Lilffy/NIPKOW/firmware/README.md

# 固件工程（STM32F407VET6 / 天空星核心板）

> 负责人：B。开发环境建议 **STM32CubeIDE**（或 Keil MDK + HAL）。
> 引脚定义已冻结，见 `docs/SCHEMATIC_LAYOUT.md`。

## 里程碑

| 编号 | 内容 | 验收 | 状态 |
|---|---|---|---|
| M0 | 骨架：168 MHz、SysTick、USART2 115200、PB2 心跳灯 | 串口打印版本号 + LED 1 Hz | ⬜ |
| M1 | 红外 EXTI：PA1 下降沿、消抖、LEB、LED 亮 1 s（非阻塞） | 遮光/移开各触发一次 | ⬜ |
| M2 | RGB PWM：TIM3 CH1/2/3（PA6/PA7/PB0），开漏+反相，≥4 级 | 8 色可辨 | ⬜ |
| M3 | 电机：TIM4_CH1（PB6）启停/调速 | 电机可转可停可调速 | ⬜ |
| M4 | 串口协议：`START` / `STOP` / `SET <rpm>` / `RGB r g b` | 串口助手可控 | ⬜ |
| M5 | 稳速闭环：索引周期测量 + PI，1200±20 rpm | 30 s 稳定 | ⬜ |
| M6 | 整帧成像：16×25 帧缓冲、125 µs 像素、切图、动画、失锁 | 静态图 30 s 不漂移 | ⬜ |
| M7 | 加分：灰度、30 fps、PC 传图 | 按赛题 | ⬜ |

## 目录约定

```
firmware/
├── common/     时钟、延时、串口、日志
├── drivers/    led / ir_exti / rgb_pwm / motor_pwm / encoder
├── app/
│   ├── stage1/ 第一阶段 5 个演示程序（可独立编译）
│   └── stage2/ 扫描时序、帧缓冲、动画、失锁
└── tools/      上位机脚本（Python）
```

## 烧录

- ST-Link 接核心板 SWD（PA13/PA14 + GND + 3V3）
- 串口：J7（GND / TX=PA2 / RX=PA3），115200 8N1
- 上电顺序：先测 3.3V/5V 正常，再插核心板

## 关键约束（务必遵守）

1. RGB 三路必须 **GPIO 开漏输出**，PWM 占空比**取反**（低电平点亮），否则灯关不死
2. 索引 PA1：遮光时高、透光时低 → **下降沿**触发
3. 中断里只置标志/记时间戳，1 秒 LED 用 SysTick 非阻塞
4. 切帧只能在索引中断里做，避免撕裂
5. 失锁判据：索引间隔 > 1.5T 立即熄灯并复位状态机

## 构建（VSCode + CMake）

```powershell
cd firmware
cmake -B build -G Ninja -DCMAKE_BUILD_TYPE=Debug
cmake --build build
```

要求：
- `arm-none-eabi-gcc` 在 PATH（或设置环境变量 `ARM_GCC_DIR` 指向工具链根目录）
- CMake ≥ 3.20、Ninja
- 产物：`build/nipkow-fw.elf / .bin / .hex`

## 烧录

```powershell
# STM32CubeProgrammer CLI
& "C:\Program Files\STMicroelectronics\STM32Cube\STM32CubeProgrammer\bin\STM32_Programmer_CLI.exe" -c port=SWD -w build\nipkow-fw.hex -v -rst
```

或 VSCode 里用 STM32 扩展的 Debug/Run（选 ST-Link）。

---

## 目录说明（2026-10-26 更新）

| 路径 | 内容 | 状态 |
|---|---|---|
| 
irmware/cubemx/ | **当前开发工程**：CubeMX 生成（CMake + VSCode），含 M0 代码、.ioc、选择性 HAL | ✅ 可编译（RAM 2224 B / FLASH 19400 B） |
| 
irmware/Core/、
irmware/third_party/ | 早期手写骨架（参考用，HAL 全量） | 📦 参考 |

### 编译 cubemx 工程

`powershell
cd firmware/cubemx
cmake --preset Debug
cmake --build --preset Debug
`

要求：rm-none-eabi-gcc 在 PATH，CMake ≥ 3.22，Ninja。

> cubemx/ 是用 CubeMX 重新生成后直接覆盖的工程；.ioc 是唯一配置源。
> cubemx/Drivers/ 只保留了 CMake 实际引用的 16 个 HAL 源文件 + CMSIS 必要头文件（约 9 MB），
> 换芯片/加外设后如果 CMake 引用了新的 HAL 文件，需要补拷或直接用 CubeMX 重新生成。
