Lilffy/NIPKOW/docs/SCHEMATIC_ZONES.md

# 原理图分区：器件 → 功能模块对照表

> 用途：手动整理原理图分区时按此表归类（2026-10-27 按网表核对生成）。
> **DNP** = 不贴；网络名以原理图/网表为准。

| 模块 | 器件 |
|---|---|
| 核心板 | U1 |
| 电源输入 / 防反接 / 滤波 | J1、D1、C1、C3、C5、C7、C9、C10 |
| 5V 线性稳压（LM1117-ADJ） | U3、C4、C8、R10、R11 |
| 3.3V 线性稳压（LM1117-3.3） | U2、C2、C6、R16 |
| 5V 注入核心板 | JP1 |
| 核心板上拉（PA4/SPI Flash CS） | R15 |
| RGB 驱动（主方案：PNP 高边） | J3、Q4、Q5、Q6、R3、R6、R9、R17、R18、R19、R20、R21、R22 |
| RGB 备用（低边 NMOS，DNP 不贴） | Q1、Q2、Q3、R2、R5、R8 |
| 红外发射 | J4、R12 |
| 红外接收 / 索引输入 | J5、R13、R14、D2 |
| 按键 | KEY1、KEY2 |
| 电机接口 | J6 |
| 串口（UART） | J7、R23 |
| 测试点 | TP1、TP2、TP3、TP4、TP5、TP6、TP7、TP8、TP9 |

---

## 核心板（1 个）

**主要网络**：5V(+5V_CORE) / 3V3 / GND；PA1=IR_INDEX、PA2/PA3=UART_TX/RX、PA4=PA4(上拉)、PA6/PA7/PB0=R/G/B_PWM、PB6=MOTOR_PWM、PC0/PC1=KEY1/KEY2

| 器件 | 值 / 型号 | 封装 | 备注 |
|---|---|---|---|
| U1 | 立创·梁山派-天空星开发板 | DIP-80_L44.97-W69.97-P2.54X2-LS35.9_OLD |  |

## 电源输入 / 防反接 / 滤波（8 个）

**主要网络**：VIN_MAIN（J1、D1.A）→ VIN_PROTECTED（D1.K、C1/C3/C5/C7/C9/C10 到 GND）

| 器件 | 值 / 型号 | 封装 | 备注 |
|---|---|---|---|
| J1 | 主电源接口 | CONN-TH_XY301V-A-5.0-2P | C9900016950 |
| D1 | SS34 | SMA_L4.3-W2.6-LS5.0-FD | C7420365 |
| C1 | 10uF | C0603 |  |
| C3 | 10uF | C0603 |  |
| C5 | 100nF | C0603 |  |
| C7 | 100nF | C0603 |  |
| C9 | 100nF | C0603 |  |
| C10 | 10uF/25V | C0603 |  |

## 5V 线性稳压（LM1117-ADJ）（5 个）

**主要网络**：VIN_PROTECTED → U3 → +5V_REG；ADJ 节点由 R10/R11 分压；C4/C8 滤波

| 器件 | 值 / 型号 | 封装 | 备注 |
|---|---|---|---|
| U3 | 主稳压电路 | TO-220-3_L10.0-W4.5-P2.54-L | C498319 |
| C4 | 10uF | C0603 |  |
| C8 | 100nF | C0603 |  |
| R10 | 120 | R0603 |  |
| R11 | 360 | R0603 |  |

## 3.3V 线性稳压（LM1117-3.3）（4 个）

**主要网络**：VIN_PROTECTED → U2 → +3V3_EXT；C2/C6 滤波；R16 假负载

| 器件 | 值 / 型号 | 封装 | 备注 |
|---|---|---|---|
| U2 | 外围电路稳压 | SOT-223-3_L6.4-W3.5-P2.30-LS7.0-BR | C55544533 |
| C2 | 10uF | C0603 |  |
| C6 | 100nF | C0603 |  |
| R16 | 470 | R0603 |  |

## 5V 注入核心板（1 个）

**主要网络**：+5V_REG ↔ +5V_CORE（JP1 短接才注入）

| 器件 | 值 / 型号 | 封装 | 备注 |
|---|---|---|---|
| JP1 | 跳线 | HDR-TH_2P-P2.54-V-M | C9900015265 |

## 核心板上拉（PA4/SPI Flash CS）（1 个）

**主要网络**：PA4 ↔ +3V3_CORE（R15 10k 上拉）

| 器件 | 值 / 型号 | 封装 | 备注 |
|---|---|---|---|
| R15 | 10000 | R0603 |  |

## RGB 驱动（主方案：PNP 高边）（13 个）

**主要网络**：R_PWM/G_PWM/B_PWM → R17–R19 → Q4–Q6 基极；Q4–Q6 发射极接 +5V_REG、集电极 → R3/R6/R9 → J3-1/2/3；R20–R22 为上拉到 +5V_REG；J3-4 = GND（公共阴极）

| 器件 | 值 / 型号 | 封装 | 备注 |
|---|---|---|---|
| J3 | RGB灯珠接口 | CONN-TH_A2547WV-4P | C9900216472 |
| Q4 | S8550 | SOT-23-3_L2.9-W1.3-P1.90-LS2.4-BR | C20069126 |
| Q5 | S8550 | SOT-23-3_L2.9-W1.3-P1.90-LS2.4-BR | C20069126 |
| Q6 | S8550 | SOT-23-3_L2.9-W1.3-P1.90-LS2.4-BR | C20069126 |
| R3 | 180 | R0603 |  |
| R6 | 120 | R0603 |  |
| R9 | 120 | R0603 |  |
| R17 | 1000 | R0603 |  |
| R18 | 1000 | R0603 |  |
| R19 | 1000 | R0603 |  |
| R20 | 10000 | R0603 |  |
| R21 | 10000 | R0603 |  |
| R22 | 10000 | R0603 |  |

## RGB 备用（低边 NMOS，DNP 不贴）（6 个）

**主要网络**：Q1–Q3 + R2/R5/R8；仅当灯珠为共阳时才贴

| 器件 | 值 / 型号 | 封装 | 备注 |
|---|---|---|---|
| Q1 | AO3400A | SOT-23-3_L2.9-W1.3-P1.90-LS2.4-BR | **DNP 不贴**，C700953 |
| Q2 | AO3400A | SOT-23-3_L2.9-W1.3-P1.90-LS2.4-BR | **DNP 不贴**，C700953 |
| Q3 | AO3400A | SOT-23-3_L2.9-W1.3-P1.90-LS2.4-BR | **DNP 不贴**，C700953 |
| R2 | 10000 | R0603 | **DNP 不贴** |
| R5 | 10000 | R0603 | **DNP 不贴** |
| R8 | 10000 | R0603 | **DNP 不贴** |

## 红外发射（2 个）

**主要网络**：+5V_REG → R12 → J4-1（阳极）；J4-2 = GND（阴极）

| 器件 | 值 / 型号 | 封装 | 备注 |
|---|---|---|---|
| J4 | 2P2.54单排针 | HDR-TH_2P-P2.54-V-M | C9900015265 |
| R12 | 200 | R0603 |  |

## 红外接收 / 索引输入（4 个）

**主要网络**：+3V3_EXT → R13 → IR_INDEX（J5-1 = 集电极，接 PA1）；J5-2 = GND（发射极）；R14 + D2 为通光指示

| 器件 | 值 / 型号 | 封装 | 备注 |
|---|---|---|---|
| J5 | 2P2.54单排针 | HDR-TH_2P-P2.54-V-M | C9900015265 |
| R13 | 1000 | R0603 |  |
| R14 | 1000 | R0603 |  |
| D2 | GL0603UG01 | LED0603-RD | C51933293 |

## 按键（2 个）

**主要网络**：KEY1 = PC0、KEY2 = PC1；按下接地（内部/外部上拉），低有效

| 器件 | 值 / 型号 | 封装 | 备注 |
|---|---|---|---|
| KEY1 | 5.8 WSPT | SW-TH_6P-L5.8-W5.8-P2.00-LS4.5-TL_K8-5851E-L1 | C5379898 |
| KEY2 | 5.8 WSPT | SW-TH_6P-L5.8-W5.8-P2.00-LS4.5-TL_K8-5851E-L1 | C5379898 |

## 电机接口（1 个）

**主要网络**：J6: 1=VIN_PROTECTED、2=GND、3=MOTOR_PWM(PB6)、4=MOTOR_FG、5=MOTOR_AUX

| 器件 | 值 / 型号 | 封装 | 备注 |
|---|---|---|---|
| J6 | MDF7-5P-2.54DSA(95) | HDR-TH_5P-P2.54-V-M_MDF7 | C19088617 |

## 串口（UART）（2 个）

**主要网络**：J7: 1=GND、2=UART_TX(PA2)、3=UART_RX(PA3)、4=UART_VCC；R23(0Ω, DNP) 预留 3V3 供电

| 器件 | 值 / 型号 | 封装 | 备注 |
|---|---|---|---|
| J7 | HX PZ2.54-1x4P ZZ | HDR-TH_4P-P2.54-V-M | C32713270 |
| R23 | 0 | R0603 | **DNP 不贴** |

## 测试点（9 个）

**主要网络**：TP1=VIN_PROTECTED、TP2=+5V_REG、TP3=+3V3_EXT、TP4=GND、TP5=IR_INDEX、TP6=R_PWM、TP7=G_PWM、TP8=B_PWM、TP9=MOTOR_PWM

| 器件 | 值 / 型号 | 封装 | 备注 |
|---|---|---|---|
| TP1 | RH-5000 | TEST-TH_BD2.54-P1.4_RED | C5277086 |
| TP2 | RH-5000 | TEST-TH_BD2.54-P1.4_RED | C5277086 |
| TP3 | RH-5000 | TEST-TH_BD2.54-P1.4_RED | C5277086 |
| TP4 | RH-5000 | TEST-TH_BD2.54-P1.4_RED | C5277086 |
| TP5 | RH-5000 | TEST-TH_BD2.54-P1.4_RED | C5277086 |
| TP6 | RH-5000 | TEST-TH_BD2.54-P1.4_RED | C5277086 |
| TP7 | RH-5000 | TEST-TH_BD2.54-P1.4_RED | C5277086 |
| TP8 | RH-5000 | TEST-TH_BD2.54-P1.4_RED | C5277086 |
| TP9 | RH-5000 | TEST-TH_BD2.54-P1.4_RED | C5277086 |

---

## 建议分区摆放（从上到下、从左到右）

1. **左上：电源输入** —— J1、D1、C1/C3/C5/C7、C9/C10
2. **左中：稳压** —— U3 + C4/C8 + R10/R11；U2 + C2/C6 + R16
3. **左下：注入/上拉** —— JP1、R15
4. **中间：核心板 U1**（最大器件）
5. **右上：RGB 驱动** —— J3、Q4–Q6、R3/R6/R9、R17–R22；备用 Q1–Q3、R2/R5/R8 紧邻放
6. **右中：红外** —— J4 + R12（发射）；J5 + R13/R14/D2（接收）
7. **右下：按键/电机/串口** —— KEY1/KEY2、J6、J7 + R23
8. **底边：测试点 TP1–TP9**

> 跨区连接一律用网络标号（VIN_PROTECTED、+5V_REG、R_PWM…），不要拉长线。
> 电源与地：用电源符号（+5V_REG、+3V3_EXT、GND），避免线与线交叉。
