Lilffy/NIPKOW/hardware/PCBInfo.txt

工程标题: 		Nipkow
板子标题: 		Board1
PCB 标题: 		PCB1
时间: 		2026-10-25 08:21:32

板子尺寸: 		3937mil x 3543mil
板子面积: 		...
铜箔面积: 		顶层 ... 利用率 ...
露铜面积: 		总计 ... 利用率 ...
层: 		总计 22, 铜箔层 2

器件: 		16
封装: 		15
元件: 		总计 59,顶层 59,底层 0
焊盘: 		总计 215, 顶面表贴 86,底面表贴 0,金属化孔 125, 非金属化孔 4
网络: 		总计 37, 未布线 0
测试点: 		网络总数 37, 有测试点的网络 0, 测试点覆盖率 0%
 		总计 0, 顶面测试点 0, 底面测试点 0

挖槽区域: 		4
过孔: 		总计 32, 通孔 32, 盲埋孔 0
铺铜区域: 		1
导线长度: 		75672.4mil
