Lilffy/NIPKOW/docs/V2_HANDOVER_FOR_A.md

# V2 改板任务书（交给 A）

> 2026-10-31。目标：**在 V1 网表不变的前提下，重排布局 + 重新布线，得到一块"无隐患"的扩展板。**
> 时间要求：**今天（10-31）出 Gerber**，加急打样 2–3 天，11-03/04 到货，留 2 天焊接联调。

---

## 0. 背景（一句话）

V1 板已到货，但布局有几处问题（连接器罩住贴片、器件进核心板投影、丝印位号错位、电源区太挤）。铜箔没短路，但焊装体验差、有返修风险。
V2 = **同一张原理图/网表**，只改布局和布线，不动电路。

---

## 1. 交付物（就是你要发的文件）

| 文件 | 说明 |
|---|---|
| `Nipkow_EDA工程.zip` | EDA 工程（`.eprj3` + `pcb` + `sch`），**用 V1 恢复版作底稿** |
| `docs/PITFALLS_AND_FIXES.md` | 所有已知坑与应对 |
| `docs/HW_CHECKLIST.md`、`docs/SOLDERING_ORDER.md` | 焊接与检查 |
| `docs/V2_HANDOVER_FOR_A.md`（本文） | 改板要求与验收 |

---

## 2. 必改项（按优先级）

| # | 问题 | 现状（实测） | V2 要求 |
|---|---|---|---|
| 1 | **R10/R11 分压值** | BOM 写 120/360，实际只有 1.67V | 原理图已改：**R10=360、R11=120**，别改回去 |
| 2 | **J3 本体罩住 R18–R22** | J3 本体 10.2×7.0mm，中心 (77,46.7)；R18/R19/R20 在 (73.4/76.7/80.0, 49.7) | **J3 本体不得覆盖任何贴片焊盘**，与最近贴片间距 ≥1.5mm |
| 3 | **C6/C7/C8 紧贴 U3** | 间隙 0.05–0.1mm | 与 U3 本体间距 **≥1.0mm**，并留 15×15mm 散热片空间 |
| 4 | **C9 / R15 / R23 在核心板投影内** | C9 左缘约 0.5mm 进投影 | 移出核心板投影；投影区内只允许 ≤1mm 高贴片且必须先焊 |
| 5 | **J7 在核心板投影内** | 直针 8.5mm + 杜邦头 ≈11mm，会顶核心板 | **移出投影**（Y>80mm 或 X>72.5mm），或明确标注"只能焊线" |
| 6 | **J1–D1 太近** | 间隙 0.35mm | 间距 **≥1.0mm** |
| 7 | **丝印位号错位** | U1 偏 40.7mm、J3 偏 7.1mm、J6 6.7mm、J1/U3 6.4mm… | 位号文字离器件中心 **≤1.5mm**，不压焊盘 |
| 8 | 板边与孔 | — | 器件离板边 ≥1mm；M3 孔周围 3.5mm 禁布 |

---

## 3. 操作步骤（嘉立创 EDA 专业版 V4.1.78）

1. **打开工程** → 双击 `Nipkow.eprj3`
2. **改布局**：按第 2 节的 8 条挪动器件（先挪连接器，再挪被动件）
3. **删掉旧走线**：全选走线 → 删除（或 `布线 → 清除全部布线`）
4. **自动布线**：菜单 `布线 → 自动布线`，范围选"全部网络"，层选 **Top + Bottom**
   - 若自动布线有未完成网络：把该网络先手动连掉，或调小线宽/间距重跑
5. **铺铜**：`铺铜 → 重建全部铜皮`（快捷键 `Shift+B`），确认 GND 全部连通
6. **DRC**：`设计 → 检查 DRC`，**必须 0 error**（连接错误=未布线，间距错误=短路风险）
7. **丝印检查**：位号不压焊盘、不重叠
8. **导出**：
   - `文件 → 导出 → Gerber`（打包 zip）
   - `文件 → 导出 → BOM`
   - `文件 → 导出 → 坐标文件（PickAndPlace）`
   - `文件 → 导出 → PDF`（装配图，可选）
9. **发回**：Gerber.zip + BOM.csv + PickAndPlace.csv +（改动后的）工程 zip

---

## 4. 验收标准（发回前自检）

| 项 | 标准 |
|---|---|
| 网表 | 37 个网络，**全部连通**（DRC 无 Connection Error） |
| 间距 | DRC 无 Clearance Error（≥6mil） |
| 核心板投影 | 区内无插件；贴片 ≤1mm 高 |
| 连接器 | J3/J4/J5/J6 本体不压任何贴片焊盘 |
| R10/R11 | 原理图值 = **360/120** |
| 丝印 | 位号贴近器件，不压焊盘 |
| 板框 | 100×90mm，4×M3 孔位置不变 |
| 文件 | Gerber + BOM + 坐标齐全，BOM 与原理图一致 |

---

## 5. 时间线

| 时间 | 事 |
|---|---|
| 10-31 上午 | 打开工程，按第 2 节改布局 |
| 10-31 下午 | 自动布线 + DRC 修到 0 + 导出 |
| 10-31 傍晚 | 发回文件 → B 复核 → 下单加急 |
| 11-03/04 | 到板 |
| 11-04/05 | 焊接 + 联调 |
| 11-06 | 验收 |

---

## 6. 注意

- **不要改原理图电路**（除 R10/R11 已改好），只改布局/布线/丝印
- **不要加新元件**（不加电解位、不加 SWD 排针）
- 若自动布线跑不完：先布电源（VIN/5V/3V3/GND），再布信号
- 有疑问直接发 DRC 截图给 B，不要自己猜
