Lilffy/NIPKOW/docs/HW_CHECKLIST.md

# 硬件核查清单（V1 板到货后按顺序执行）

> 2026-10-30 板到货当天用。**先看第 0 节，有两处必须先改，否则上电就出事。**

## 🔴 0. 上电前必须做的两处修正（最重要）

### 0.1 R10 / R11 阻值必须对调（否则 5V 轨只有 1.67V）

LM1117-ADJ 输出公式：`Vout = 1.25 × (1 + R2/R1)`，其中 **R2 = OUT–ADJ（R10）**，**R1 = ADJ–GND（R11）**。

原 BOM/原理图：R10 = **120Ω**、R11 = **360Ω** → `1.25 × (1 + 120/360) = 1.67V` ❌（核心板起不来）

**正确做法（焊之前改）**：
- **R10 位置焊 360Ω**
- **R11 位置焊 120Ω**
- 验证：`1.25 × (1 + 360/120) = 5.00V` ✅

> 手上的料正好够：120Ω 有 3 颗（R6、R9、**R11**），360Ω 有 1 颗（**R10**）——把标签对调着焊即可，不用补买。

### 0.2 U2 方向 + 型号确认

- U2（SOT-223，3.3V LDO）：**pin1 = GND**，焊接前确认 pin1 与丝印/封装缺口方向一致；**贴反 = 9V 灌进 3.3V 轨，烧 U2 + 红外 + LED**
- 确认 U2 是**固定 3.3V 型号**（丝印 `1117-3.3` / `AMS1117 3.3`）。若发到的是 `LM1117-ADJ`（可调版），板上没有分压电阻 → 输出只有 1.25V，必须换料

## 1. 到货 10 分钟开箱核对（不焊）

| # | 检查项 | 方法 | 判据 |
|---|---|---|---|
| 1 | 板子数量/外观 | 目视 | 无划伤、断线、阻焊起泡 |
| 2 | 尺寸 | 卡尺 | 100 × 90 mm |
| 3 | 安装孔 | 卡尺 | 4 × Ø3.2 mm，孔距 89.84 × 79.84（相对首孔） |
| 4 | **两个 2×20 排母孔间距** | 卡尺/直尺 | 内侧行距 **33.02 mm**（中心距 35.56） |
| 5 | 丝印 | 目视 | J1/J3/J4/J5/J6/J7、TP1–TP9、U2/U3、Q4–Q6 可读 |
| 6 | 极性标记 | 目视 | D1 阴极带、D2 方向、U2 pin1、U3 方向 |
| 7 | 过孔/镀层 | 目视 | 无堵孔、无露铜 |

## 2. 焊前静态检查（万用表，断电）

| # | 测什么 | 档位 | 期望 |
|---|---|---|---|
| 1 | VIN_MAIN ↔ GND（TP1 对 TP4） | 通断/电阻 | 不通（>1MΩ）；若几十Ω → 有短路，别上电 |
| 2 | +5V_REG（TP2）↔ GND | 电阻 | 不通（电容充电会跳动） |
| 3 | +3V3_EXT（TP3）↔ GND | 电阻 | 不通 |
| 4 | **TP2 ↔ TP3（5V 对 3V3）** | 通断 | **不能通**（这条查"VCC 混接"） |
| 5 | D1 正向压降 | 二极管档 | ≈0.2–0.4V（红笔 J1+，黑笔 TP1） |
| 6 | U3 pin1(ADJ)–pin3(VIN)、pin2–pin3 | 二极管档 | 无短路 |
| 7 | U2 pin1(GND)–pin2(VOUT)、pin3(VIN)–pin1 | 二极管档 | 无短路 |

## 3. 焊接顺序 + 分阶段上电

**阶段 A：只焊电源区**
1. J1、D1、C1/C3/C5/C7、C9/C10（VIN 侧）
2. U3 + C4/C8 + **R10=360Ω / R11=120Ω（注意对调）**
3. U2 + C2/C6 + R16
4. JP1 先**不短接**、U1 排母**先不焊**
5. 限流电源 9V / **200mA**，测：
   - TP1（VIN_PROTECTED）≈ **8.6V**（9 − 0.4 肖特基）
   - TP2（+5V_REG）≈ **5.00V**（±0.1）← **若 1.6–1.7V 说明 R10/R11 装反了**
   - TP3（+3V3_EXT）≈ **3.30V**（±0.1）
6. 摸 U3 温度（正常微温）

**阶段 B：核心板座 + 基本外设**
7. 焊 H1/H2 两个 2×20 排母（注意方向，别焊反）
8. 焊 C9/C10 附近的 R15、J7、R23（R23 不贴）
9. 断电，插核心板，JP1 短接
10. 上电：核心板应亮；测核心板 5V/3.3V；ST-Link 下载固件，串口 115200 应打印 `=== NIPKOW M0 ===`

**阶段 C：驱动与接口**
11. 焊 Q4–Q6 + R3/R6/R9 + R17–R22 + J3（Q1–Q3/R2/R5/R8 **不贴**）
12. 焊 J4、R12（用 220Ω 更好，200Ω 也能用）
13. 焊 J5、R13、R14、D2
14. 焊 KEY1/KEY2、J6、TP1–TP9
15. 全系统上电复测三路电压 + 各功能

## 4. 电压判据（万用表，黑笔接 TP4 GND）

| 测试点 | 网络 | 期望值 | 异常含义 |
|---|---|---|---|
| TP1 | VIN_PROTECTED | 8.5–8.8V（9V 输入） | 低 → D1 装反/虚焊 |
| TP2 | +5V_REG | **5.00 ± 0.1V** | 1.6–1.7V → R10/R11 反；0V → U3 虚焊/JP1 未短接无关 |
| TP3 | +3V3_EXT | 3.3 ± 0.1V | 1.25V → U2 是可调版/装反；0V → U2 虚焊 |
| 核心板 5V 脚 | +5V_CORE | 5.0V（JP1 短接后） | 无 → JP1 未短接/排母虚焊 |
| 核心板 3.3V 脚 | +3V3_CORE | 3.3V | 无 → 核心板未启动 |

## 5. 功能验证（按第一阶段五任务顺序）

| # | 任务 | 操作 | 判据 |
|---|---|---|---|
| 1 | 通电运行 | 上电，串口 115200 | 打印 `SYSCLK = 168000000 Hz` |
| 2 | 红外遮挡 | 挡/移开 J4-J5 光路，测 TP5 | 遮光 ≈3.3V，通光 <0.99V；移开瞬间 PB2 LED 亮 1s |
| 3 | RGB 常亮/调光 | 按键 KEY1 选 R/G/B，KEY2 调 5 档 | 三色分别常亮，亮度可辨 4 档以上 |
| 4 | 中断 + LED | 挡住再移开 | LED 亮 1 秒后灭，可再次触发 |
| 5 | 电机 | 按 KEY1 到 MOTOR，KEY2 调速；或串口 `MOTOR 3` | 启停、转速变化 |
| + | 串口命令 | `HELP`/`STATUS`/`TARGET R`/`LEVEL 3` | 有响应，RGB 跟随变化 |

## 6. 常见异常对照

| 现象 | 可能原因 | 处理 |
|---|---|---|
| 上电电流大/冒烟 | 电源短路（U2/U3 装反、D1 反） | 立即断电，万用表查 TP1/2/3 对 GND |
| 5V 只有 1.67V | R10/R11 值装反 | 对调（R10=360、R11=120） |
| 3.3V 只有 1.25V | U2 是可调版或装反 | 换固定 3.3V 型号 / 重焊 |
| 核心板不亮 | JP1 未短接、排母虚焊、核心板 5V 输入不足 | 测 +5V_CORE、补焊 |
| 串口无输出 | GND 未共地、TX/RX 未交叉、波特率不对 | 按 `A_HANDOVER_NOTES` §4.5 排查 |
| 红外无反应 | J4/J5 插反、R12/R13 虚焊、光路没对准 | 测 TP5、手机相机看发射管 |
| RGB 不亮/颜色反 | 灯珠共阳、Q4–Q6 虚焊、J3 线序错 | 核对 J3-4=GND（共阴） |

## 7. 记录

| 日期 | 检查项 | 实测值 | 结论 | 备注 |
|---|---|---|---|---|
| | TP1 | | | |
| | TP2 | | | |
| | TP3 | | | |
| | 核心板串口 | | | |
| | 红外 TP5 | | | |
| | RGB | | | |
| | 电机 | | | |

## 八、V1 板最终焊接值（不重打，按此焊）

> 结论：R10/R11 换值**不改变铜箔**，Gerber 与 V1 完全相同 → **不需要重打板**。
> 按下面焊接即可得到 5.00V。

| 位号 | 焊什么 | 说明 |
|---|---|---|
| **R10** | **360Ω** | 原 BOM 标 120，必须换 360 |
| **R11** | **120Ω** | 原 BOM 标 360，必须换 120 |
| R12 | 200Ω（有 220 更好） | 200 时 If≈18.5mA，可接受 |
| C1、C3 | 10µF/**25V** 0603 | 你已补 25V |
| C10 | 10µF/**25V** 0603 | 已补 |
| C4、C8 | 10µF/16V + 100nF | 5V 输出 |
| C2、C6 | 10µF/16V + 100nF | 3.3V 输出 |
| C5、C7、C9 | 100nF/50V | 你已补 |
| C-EXT | 100µF/25V 电解（外接） | J1 或 J6 电源端 |
| **J7** | **弯针（90°）4P** 或直接焊线 | 直针会顶核心板，必须弯针/焊线 |
| U3 | LM1117-ADJ + 散热片 + 绝缘垫片 | 背板 5V 电位 |
| R13 | 1kΩ（弱光换 2.2k） | 你已备 2.2k |
| Q1–Q3、R2/R5/R8、R23 | **不贴** | DNP |

### 上电第一件事

测 **TP2（+5V_REG）对 TP4（GND）= 5.00V ± 0.1V**；若 1.6–1.7V → R10/R11 装反。
