Lilffy/NIPKOW/docs/A_HANDOVER_NOTES.md

# 硬件侧交接说明（B → A）

> 写给 A 和 A 的 AI：硬件（焊接/调试/机械/测试）从这里开始主要由 A 负责。
> 板子已经**布通、DRC 0**，制造文件在仓库 `hardware/`。
> 更新：2026-10-25（B）

---

## 1. 板子当前状态（已验证）

| 项 | 状态 |
|---|---|
| 板框 | 100 × 90 mm，4 × M3 安装孔（3.2 mm，四角） |
| 层数 | 2 层，1.6 mm |
| 器件 | 59 个（全顶层）；215 焊盘（86 SMT + 125 通孔 + 4 非金属化） |
| 布线 | 37 网络全部布通，**未布通 0**；32 个过孔；底层 GND 覆铜 |
| DRC | **0 错误** |
| 制造文件 | `hardware/Gerber.zip`、`BOM.csv`、`PickAndPlace.csv`、`PCBInfo.txt`、`schematic.pdf` |

**上次网表/DRC 结论**：以仓库里 `hardware/PCBInfo.txt` 的时间戳为准（每次导出更新）。

---

## 2. 本次唯一改动：C10

| | 之前 | 现在 |
|---|---|---|
| C10 | 100 µF，**0603 封装**（物理上贴不了） | **10 µF / 25 V，0603** |
| 100 µF 大电容 | 想放在 C10 位置 | 改为**外接**：在 J1（VIN 输入）两端或电机 J6 电源端并 100 µF 电解 |
| 铜箔 | — | **没有改动**，Gerber 不变 |

**为什么不是把 C10 换成 6.3 mm 电解**：C10 原位置离 C9 只有 3.2 mm，6.3 mm 电容放不下；挪位置要重布电源区走线（试过，产生 24 个间距错误），所以选"小电容 + 外接大电容"。

**A 要做的**：采购时按 BOM 买 **10 µF/25 V 0603**（X5R/X7R）；外接 100 µF 电解（≥16 V）接到 J1 或电机电源端，注意极性。

---

## 3. 不贴（DNP）的器件——不要焊

| 器件 | 说明 |
|---|---|
| Q1、Q2、Q3（AO3400A） | 旧的低边 RGB 方案，已改为 PNP 高边，**不贴** |
| R2、R5、R8（10 kΩ 下拉） | 配合 Q1–Q3 的，**不贴** |
| R23（0 Ω） | J7-4 的 +3V3 预留，**默认不贴**（需要给 USB-TTL 供电时才贴） |

其余按 BOM 全贴。

---

## 4. 焊接与上电顺序（建议）

1. 先焊电源区：J1、D1(SS34)、U2、U3、C1–C8、R10/R11/R16、JP1
2. **不插核心板**、JP1 断开，限流 200 mA 上电 7.4–12 V（建议 9 V）
3. 测：VIN_PROTECTED、+5V_REG（应 ≈5.0 V）、+3V3_EXT（应 ≈3.3 V）
4. 摸 U3 温度（LM1117-ADJ，压差大时会热；建议加小散热片）
5. 断电，插核心板，JP1 短接（5 V 注入核心板）
6. 上电，测核心板 3.3 V；ST-Link 下载 `firmware/` 的 M0 程序
7. 串口 115200 应看到 `=== NIPKOW M0 ===` + `SYSCLK = 168000000 Hz`，PB2 LED 闪（M1 起改为红外触发亮 1 秒）

> ⚠️ 上电前必做：万用表二极管档测 VIN–GND、5V–GND、3V3–GND 无短路。

---

## 4.5 串口（J7）接线与调试

**板上：** J7 = 4P 2.54 排针（HDR-TH_4P），接 USART2（PA2/PA3），固件已配 **115200 8N1**。

| J7 | 网络 | 接 USB-TTL |
|---|---|---|
| 1 | GND | **GND（必须共地）** |
| 2 | UART_TX（PA2） | 模块 **RX** |
| 3 | UART_RX（PA3） | 模块 **TX** |
| 4 | UART_VCC | **不接**（R23 默认不贴，无 3.3V 输出） |

**需要买：** CH340 / CP2102 USB-TTL 模块（**电平选 3.3V**，约 5–10 元）+ 杜邦线 ×3 + USB 线。

**接线（交叉）：**
```
USB-TTL TX  → J7-3 (PA3, 板 RX)
USB-TTL RX  ← J7-2 (PA2, 板 TX)
USB-TTL GND → J7-1 (GND)
USB-TTL VCC   不接
```

**排查：**
- 没输出/乱码 → 先查 **GND 共地**、TX/RX 是否交叉、波特率 115200
- 模块有 3.3V/5V 跳线 → 确认在 **3.3V**
- macOS/Linux 可直接 `screen /dev/tty.usbserial* 115200`；Windows 用串口助手/PuTTY/MobaXterm

> 另：核心板自带调试口是 **USART1（PA9/PA10）**，与本板 J7 的 USART2 不是同一路；ST-Link V2 没有虚拟串口，V3 才有。

---

## 5. 测试点（TP1–TP9）

> 2026-10-27 按网表更正（之前版表错位）。

| 测试点 | 网络 |
|---|---|
| TP1 | VIN_PROTECTED（防反接后） |
| TP2 | +5V_REG |
| TP3 | +3V3_EXT |
| TP4 | GND |
| TP5 | IR_INDEX（PA1，红外接收输出） |
| TP6 | R_PWM（PA6） |
| TP7 | G_PWM（PA7） |
| TP8 | B_PWM（PB0） |
| TP9 | MOTOR_PWM（PB6） |

（以 `schematic.pdf` 为准，若有出入以原理图为准并在 issue 里指出。）

---

## 6. 已知风险（A 重点关注）

| 风险 | 说明 | 处理 |
|---|---|---|
| U3 散热 | 9 V 输入、5 V 输出 0.3 A 时耗散约 0.8 W | 加散热片；摸温度 >80 °C 要改方案 |
| 电机电流 | 3720 内置驱动电机，启动电流未知 | 先串限流/保险，测堵转电流再定线宽 |
| RGB 驱动 | PNP 高边，**GPIO 必须开漏 + PWM 反相** | 若灯关不死，先查固件是否开漏 |
| 灯珠参数未知 | Vf/If 未确认 | 上电前用可调电源单独测灯珠 |
| J7 供电 | J7-4 经 R23（默认不贴）到 3V3 | 不要直接接 USB-TTL 的 VCC |
| 5V/3V3 排针 | 核心板 40 脚 = 5V，38 脚 = 3.3V | 插反会烧，插前核对丝印 |

---

## 7. A 的工作方式（和 B 的约定）

1. **每项工作开一个 issue**（用 `.github/ISSUE_TEMPLATE/agent-task.md` 模板）
2. 每天在 **#18 每日状态** 留一条
3. 关闭 issue 前附证据：电压读数 / 波形截图 / 照片
4. **不要改** `firmware/`（B 的地盘）；不要改 `hardware/Gerber.zip`（B 导出）
5. 需要改电路 → 开 `[Q]` issue，**人类拍板**

---

## 8. 给 A 的 DeepSeek 的话

- 你的职责是**硬件、机械、测量、记录**，不是写固件
- 先读：`README.md` → `docs/TASKS.md` → `docs/A_HANDOVER_NOTES.md`（本文件）→ `docs/GITHUB_COLLAB_PROTOCOL.md`
- 遇到电气不确定（能不能上电、线序、极性）→ 先列风险，**不要猜**
- 数据以实测为准，不要编造电压/电流数值
- 每次交付：issue 里写「做了什么 / 怎么测的 / 结果 / 证据」
