Lilffy/NIPKOW/docs/PROJECT_BRIEF.md

# 项目简报：柱状尼普科夫鼓机械扫描电视

> 依据：`docs/inbox/` 三份原始文件（赛题 PDF、指导文档 DOCX、核心板原理图 PDF）
> 整理：Lead，2026-10-24
> 规则：本文件是项目"单一事实源"的摘要层；所有数字都能回溯到原文页码/章节；改动决策记入 `docs/DECISIONS.md`

---

## 0. 一句话

用 16 孔螺旋排布的旋转鼓 + 1 颗 RGB 灯，在 1200 rpm 下以 20 fps 显示 16×25 = 400 像素的彩色画面。
**本次要交付的是：插在组委会「梁山派·天空星」STM32F407 核心板上的扩展板（原理图+PCB+焊接）以及配套固件。**

---

## 1. 任务与验收

### 1.1 赛制

- 比赛分**两个阶段**，每个阶段验收当天 **8:30 提交作品**，逐组进实验室测试，**每组 ≤ 10 分钟**。`[赛题 p1]`
- 第一阶段**只考电路与基础软件，不要求机械装配**；第二阶段做结构装配、软件调试、整机联调。`[赛题 p4]`
- 发挥部分元器件**自备**，组委会不额外提供。`[赛题 p1]`
- 组委会提供主要元器件一套（表 1），损坏可再申请但影响评分。`[赛题 p5]`
- **预计 10 月 30 日（周五）提供物料**，后续集中提供焊台。`[指导 1.0]`

### 1.2 第一阶段验收（5 条，全部是硬指标）

| # | 要求 | 落到板上的对应电路 |
|---|---|---|
| 1 | 扩展板通电后最小系统正常运行，程序可下载运行 | 3.3 V 电源、排针、SWD/串口 |
| 2 | 红/绿/蓝三路 LED 可分别常亮，三路 PWM 独立调光，**亮度至少 4 级** | RGB 驱动通道 ×3 |
| 3 | 遮光板遮/放发射接收管之间，接收信号随之变化 | 光电索引电路 |
| 4 | 编码器信号送单片机**外部中断**，中断后点亮 LED **持续 1 秒**后熄灭，可重复触发 | EXTI + LED（可用板上用户 LED） |
| 5 | 单片机可控制直流电机转动、停止并调速 | 电调 PWM 输出 |

`[赛题 p4]`　指导文档把这五条拆成五个独立可演示的程序（表 1：最小系统跑通 / 三路 PWM 调光 / 编码器信号观测 / 外部中断+LED 亮 1 秒 / 电机启停调速）。`[指导 1.7 + 表1]`

### 1.3 第二阶段验收（7 条 + 加分）

1. 机械装配完成：无刷电机、鼓、视窗按图 2 装配；手动盘车一圈阻力均匀；桶壳与视窗相对位置正确；鼓内壁消光；**加装防护罩** `[赛题 p4 (1)]`
2. 装置以 **1200 ± 20 rpm** 稳定运行；光电同步脉冲不丢失、无明显毛刺 `[赛题 p4 (2)]`
3. 屏上稳定显示 **16 行 × 25 列**静态图像（校徽/文字/图案），16 行全部到位、**无行错位**，**静置 30 秒无可见漂移** `[赛题 p4 (3)]`
4. 图像内容可切换，**至少预存 2 幅**，按键或串口切换 `[赛题 p4 (4)]`
5. 彩色显示，至少 **红/绿/蓝/黄/青/品红/白/黑 8 色** `[赛题 p4 (5)]`
6. 动画显示，**≥ 5 fps** 刷新 `[赛题 p4 (6)]`
7. **失锁保护**：遮挡索引光路时当帧丢弃、自动重同步，画面不得整幅错位或倾斜 `[赛题 p4 (7)]`

加分项 `[赛题 p4 (8)]`：
- a. 帧率提到 **30 fps（1800 rpm）** 并保持锁相，1 分钟不丢帧
- b. **灰度/多级亮度**，同色 ≥ 4 级
- c. 上位机实时传输图像，PC 任意文字图像上屏
- d. 显示面积/像素扩展（周向扩展成环屏；纵向加孔+第二组灯到 32 线；改小孔尺寸+软件提高水平分辨率）
- e. 其它交互功能

---

## 2. 关键参数（已复核计算）

鼓 / 光学 `[赛题 p1-p3]`：

| 项 | 值 | 校核 |
|---|---|---|
| 鼓半径 r | 80 mm | 周长 2πr = **502.65 mm** |
| 鼓壳 | Ø160 mm × 高 46 mm | 图 2/图 5 |
| 通光孔 | 16 个，**1.255 mm × 1.961 mm** 方孔 | |
| 视窗（固定） | 角宽 **22.5°**，弧长 31.4 mm，与鼓壁间隙 1–2 mm | 502.65 × 22.5/360 = **31.42 mm** ✓ |
| 每行像素数 | 25 列，列距 1.255 mm | 31.42/25 = **1.2568 mm** ✓（原文 1.255，取整） |
| 行高 / 孔高差 | 1.961 mm × 16 行 = 31.38 mm | 原文 1.961 ✓ |
| 总像素 | 16 × 25 = **400** | |

时序 `[赛题 p1-p2]`：

| 项 | 20 fps（基准） | 30 fps（加分 a） |
|---|---|---|
| 转速 | 1200 rpm = 20 r/s | 1800 rpm = 30 r/s |
| 帧周期 | 50 ms | 33.3 ms |
| 行周期 | 3.125 ms | 2.083 ms |
| 像素周期 t = T/400 | **125 µs** | **83.3 µs** |
| 每像素转角 | 0.9° | 0.9° |
| 每行转角 | 22.5° | 22.5° |

电/电源 `[赛题 p3-p4]`：

| 项 | 值 |
|---|---|
| 直流输入 | **7.4 – 12 V**，需防反接 |
| 3.3 V | LM1117-3.3（SOT-223，立创 C126027）供 MCU + 光电接收 |
| 5 V | LM1117-ADJ（TO-220，立创 C498319）专供 RGB 灯芯；R1=240 Ω、R2=720 Ω → 5.0 V |
| 输出电容 | 每路 ≥ 10 µF ∥ 100 nF，**低 ESR（LM1117 有 ESR 下限，太小会自激）** |
| 地 | 功率地与信号地**单点汇接** |
| 电机 | 无刷电机 + 电调 ESC，1200 rpm，M6 联轴器（M4 顶丝）；电机与灯芯建议分路供电 |

核心板 `[赛题 p2, 原理图]`：主办方提供「立创梁山派·天空星」核心板（C22370035），MCU **STM32F407VET6**（LQFP-100，兼容 STM32F103/F4、GD32F407/470、AT32F403A/435 等，板上 0 Ω 跳线选择），板载 8 MHz + 32.768 kHz 晶振、用户 LED、复位/唤醒/DFU 按键、TF 卡、SPI FLASH、USB、REF3030 基准、10 针调试口，**双排 2.54 mm 排针 P1/P2 共 80 针**全部引出。
→ 详细针脚映射见 `docs/BOARD_PINOUT.md`。

---

## 3. 系统链路 `[赛题 图3 | 指导 图4]`

```
上位机 PC ──(400像素图像)──▶ STM32 主控 ──3路PWM──▶ RGB 驱动 ──▶ RGB 灯芯(鼓内) ──▶ 尼普科夫鼓
                                │                                        （16孔螺旋/Ø160×46）
                                ├──PWM(油门)──▶ 电调 ESC ──▶ 无刷电机(1200rpm) ──M6联轴器──▶ 鼓
                                └──EXTI◀── 红外对管索引 ◀──(每转1个遮光脉冲)── 鼓上挡板
```

- **数据链**：出图 → 发像素 → 调光 → 成像
- **动力链**：ESC → 无刷电机 → 鼓
- **闭环**：索引脉冲 → EXTI → 帧同步 + 失锁检测 `[赛题 图3]`

光路要点：灯珠与灯罩在鼓内固定不转，灯罩开口（=固定视窗，22.5°）只让光径向朝外；鼓壁上的孔转进开口才有光透出。`[赛题 图2, 图5]`

---

## 4. 扩展板必须包含的电路

### 4.1 电源 `[赛题 p3 | 指导 1.1 | 交接文档 §2]`

> **2026-10-24 更新（以交接文档方案为准）**：不再由扩展板 3.3V 给核心板供电，改为 **5V 经 JP1 注入核心板 `PIN_IN_+5V`，核心板用自带的 SCJA1117B 生成 3.3V**；扩展板 U2（LM1117-3.3）只给红外上拉/指示 LED。
> 理由：避免两个 3.3V LDO 输出并联、避免向核心板 LDO 输出反灌。

- 输入 7.4–12 V（**建议标称 9 V**）→ J1 → **D1 SS34 防反接** → `VIN_PROTECTED`
- `VIN_PROTECTED` → 电机（J6-1）与两路 LDO 输入
- U3 `LM1117T-ADJ`（TO-220，C498319）→ `+5V_REG`；R10=120 Ω（OUT–ADJ）、R11=360 Ω（ADJ–GND）→ 5.0 V
- `+5V_REG` → JP1 两针跳线 → 核心板 `PIN_IN_+5V`（**U1 的 40 或 80 号脚，见 2.1 更正**）
- U2 `LM1117-3.3`（SOT-223，C55544533）→ `+3V3_EXT` 仅供红外上拉 R13 / 指示 LED
- 输出电容：每路 10 µF（低 ESR 钽）+ 100 nF；LM1117 对 ESR 有下限，纯陶瓷可能自激
- **热耗（必须核算）**：5 V 轨现供核心板+RGB+红外 ≈150–280 mA；9 V 输入耗散 ≈0.8 W，12 V ≈1.4 W → 加散热片/敷铜，优先 9 V
- **U2 轻载**：负载仅 0.5–4 mA，低于 LM1117 最小负载（5–10 mA）→ 加 330 Ω–1 k 假负载，或改用核心板 3.3 V
- 地：功率地与信号地单点汇接；电机供电与 5 V 灯芯分路走线

### 4.2 RGB 三通道驱动 `[赛题 p3 | 指导 1.2 | 参考电路 图1]`

**2026-10-26 最终方案（覆盖交接文档 §4.2 的旧说法）**：灯珠按 **共阴 4 线三合一**设计，J3：1/2/3 = 红/绿/蓝**阳极**（各经 R3=180 Ω、R6=R9=120 Ω 到 **S8550 PNP 高边**集电极），**J3-4 = GND（公共阴极）**；PNP 发射极接 +5V_REG，基极经 R17–R19（1 kΩ）到 PA6/PA7/PB0，并有 R20–R22（10 kΩ）上拉到 +5V_REG。旧的低边组 Q1–Q3 + R2/R5/R8 保留但 **DNP 不贴**。固件：**GPIO 推挽输出 + PWM 取反**（compare = 1000 − duty）。
（历史：交接文档曾按"8 mm 共阳、330/270/270 Ω、AO3400A 低边"描述，已作废。）

**这是最容易做错的一处，先把结论写清楚：**

- 参考电路里三路各串 **1 kΩ** 从 `GPIO_PWM1/2/3` 接 LED 阳极、共阴接地——若 MCU 用 **3.3 V** 直驱，绿/蓝 LED（Vf≈3.2 V）几乎无余量，实测电流只有 ~0.1 mA 级别，**不亮或极暗**；且 1 kΩ 在 5 V 下也只有 ~1.8 mA。
- 指导文档给的 **红 150 Ω / 绿蓝 100 Ω** 是按 **5 V 电源 + 15–20 mA** 算的：红 (5−2.0)/0.02 = 150 Ω；绿蓝 (5−3.2)/0.02 = 90 Ω → 取 100 Ω。但同一段又说"GPIO 直驱时持续电流 ≤ 8 mA"，**两者不能同时满足**——结论：**必须用开关管，5 V 供电**。
- 推荐两种拓扑（取决于组委会灯珠是共阴还是共阳，见待确认 Q1）：
  - **共阳**：5 V → 限流电阻 → 灯珠阳极；灯珠阴极 → NMOS 漏极（2N7002/AO3400）→ GND；GPIO → 100–330 Ω → 栅极，栅极 10 kΩ 下拉。PWM 高有效。
  - **共阴**：5 V → 灯珠阳极；灯珠阴极 → 限流电阻 → PNP（S8550）集电极；PNP 发射极 → 5 V；GPIO → 1–4.7 kΩ → 基极（低有效）。PWM 逻辑需取反。
- PWM 载频建议 **≥ 100 kHz**（周期 ≤ 10 µs），使每个 125 µs 像素窗口内有 ≥ 12 个周期，平均亮度误差 < 5%；30 fps 时 83 µs 仍 ≥ 8 个周期。若载频只有几 kHz，会出现像素间亮度差（条纹）。
- 灰度加分项：8 位/通道或 6 位（2 bit×3）编码，配 γ 表；PWM 分辨率 ≥ 8 bit。

### 4.3 光电索引电路 `[赛题 p2-p3 | 指导 1.3 | 参考电路 图1]`

- 发射：5 V → **200 Ω** → 红外发射二极管 → GND（≈19 mA 恒亮）
- 接收：3.3 V → **1 kΩ** → 光电三极管集电极（DY-PT4133B-A2）；发射极 → GND；集电极节点 → **EXTI 引脚**（+ 100 nF 到地抗干扰）
- 遮光时截止 → 节点 **高（3.3 V）**；透光时导通 → 节点 **低（≈0.2–0.4 V）** `[指导 1.3]`
- 灵敏度不足时把 1 kΩ 加到 4.7–10 kΩ；必要时加 74HC14 施密特整形 + RC
- 机械上：发射/接收管装在底座上**不随鼓转**，鼓外壁贴挡板，每转遮光一次 → 1 个索引脉冲 `[赛题 图2]`
- 抗干扰：两管加遮光套筒、避免环境光直射；电机与灯芯分路供电

### 4.4 按键与测试点 `[指导 1.4]`

- 按键：一端 GPIO、一端 GND，GPIO 内部上拉，按下为低；软件 10–20 ms 消抖
- 测试点（板边，便于探笔）：**输入电源、5 V、3.3 V、GND、索引输出、PWM1/2/3、电机 PWM**（建议再加 FG、EXTI 原始点）

### 4.5 电机/电调接口 `[指导 1.5 | 交接文档 §4.5]`

**2026-10-24 更新**：实际电机是 **3720、6–12 V、内置驱动的无刷电机**（不是"电调 ESC + 舵机信号"），5 线：红 VIN、黑 GND、蓝 PWM、绿 FG、黄未知。
- J6 `MDF7-5P-2.54DSA`：J6-1 `VIN_PROTECTED`、J6-2 GND、J6-3 `MOTOR_PWM`（PB6/TIM4_CH1）、J6-4 `MOTOR_FG`（未接）、J6-5 `MOTOR_AUX`（未接）
- **未确认**：PWM 频率/占空比–转速关系、输入电平（3.3 V 是否够）、堵转电流、FG 电气类型、黄线功能 → **拿到规格书前不要直接接电机通电**
- 电机供电点建议加 100 µF 电解 + 100 nF，抑制线束电感尖峰
- 若电机 PWM 输入需要 5 V 电平，需加电平转换或开漏上拉

### 4.6 对外端子

- 核心板双排母座（2×20 ×2，2.54 mm）
- RGB 灯芯 4 线端子（焊线安装，灯在鼓内）
- 红外发射/接收 2 组端子（焊线到灯罩/底座）
- 电机/电调 3 线（信号、电池电压、GND）
- 直流输入端子、按键、串口（可选，调试用）

---

## 5. 核心板接口

- 主芯片：STM32F407VET6，LQFP-100，168 MHz，512 KB Flash / 192 KB RAM（本项目 400 B 帧缓冲 + 双缓冲绰绰有余）
- 板载占用（扩展板选脚时避开）：PA13/PA14 = SWD，PB3 = SWO，PB2 = 用户 LED + BOOT1，PA0 = 唤醒键，PC13 = 用户按键，BOOT0、NRST；TF/SPI FLASH/USB 也占脚
- 详尽针脚表：`docs/BOARD_PINOUT.md`（由队友核对原理图生成）

---

## 6. 固件任务分解（五级台阶）`[指导 1.7 / 2.2–2.7]`

1. **最小系统**：时钟、下载、点灯
2. **三路 PWM 调光**：≥4 级，独立通道
3. **编码器观测**：EXTI 计数/测周期
4. **外部中断 + LED 亮 1 秒**：中断服务、单次定时
5. **电机启停调速**：ESC PWM 输出
6. **闭环稳速 1200±20 rpm**：1 MHz 自由计数 + 索引中断读差值 + 滑动平均得 T + 简易 PI 调占空比 `[指导 2.2]`
7. **单行成像**：先只让 1 个孔扫出一行亮线 → 校准时序与弧线位置 `[指导 2.3]`
8. **整帧 16×25**：t = T/400 更新三路 PWM；行号由孔序、列号由帧内计时；CPU 吃紧时用 DMA 搬比较寄存器 `[指导 2.3]`
9. **图像切换**：≥2 幅常量图案，按键/串口，**帧边界切换**防撕裂 `[指导 2.4]`
10. **8 色**：3 bit RGB 查表 `[指导 2.5]`
11. **动画**：双缓冲，节拍 5–20 fps `[指导 2.6]`
12. **失锁保护**：索引间隔 > 1.5T 判失锁 → 立即熄灭、复位行/帧状态机、等下一有效索引 `[指导 2.7]`
13. **加分**：1800 rpm 锁相、灰度 γ、PC 实时传图、32 线/环屏

---

## 7. 时序预算（168 MHz 视角）

| 量 | 值 | 备注 |
|---|---|---|
| 像素窗口 | 125 µs = 21,000 cycles | ISR 开销 < 1 µs 无压力 |
| 帧缓冲 | 400 B（1 B/像素，3 bit 有效） | 双缓冲 800 B |
| 周期测量 | 1 MHz 计数，T = 50,000 counts | 滑动平均 4–8 点 |
| PWM 载频 | 100–200 kHz | 与 125 µs 像素窗口的整数倍关系 |
| 行对齐余量 | 机械误差 → 固件行相位微调（可加偏移量） | 标定一次写入 Flash |

---

## 8. 风险清单

| 风险 | 后果 | 对策 |
|---|---|---|
| 3.3 V 纹波/跌落 | 核心板复位、下载失败 | 低 ESR 输出电容、≥10 µF、独立走线、电机地隔离 |
| LM1117 输出电容 ESR 过低 | 自激振荡 | 按数据手册选 ESR 区间（钽电容/电解，勿只用陶瓷） |
| 电机纹波串入索引 | 误触发、丢帧 | 分路供电、单点接地、RC+施密特、软件窄脉宽剔除（±20% 判据） |
| 索引光路受环境光干扰 | 多脉冲/抖动 | 遮光套筒、恒流驱动、阈值整形 |
| 联轴器同轴度差 | 高速振动、画面抖 | 先对中再锁紧、手动盘车检查、动平衡配重位 |
| 视窗/孔加工误差 | 双孔透光串行、行重叠 | 装配后实拍验证，固件行相位/遮光修正 |
| 帧边界切图 | 撕裂 | 只在索引中断切前台缓冲指针 |
| 25 列对 22.5° 的边界 | 首末列落在视窗边缘 | 标定像素相位偏移，必要时裁掉首/末列或压缩有效区 |
| 焊接顺序错 | 上电烧板 | 先电源→测电压→再其余模块，逐级验证 |

---

## 9. 待确认（阻塞设计，需你/组委会回答）

> 2026-10-24：Q1、Q2 已由交接文档回答（见 `docs/HANDOVER_REVIEW.md`）；新增问题见 `docs/QUESTIONS.md`。

1. **RGB 灯珠**：已确认共阳 8 mm 4 针（待确认额定电流与 Vf）
2. **电机**：3720 内置驱动，5 线（待规格书：PWM 频率/电平、堵转电流、FG、黄线）
3. **两个阶段的验收日期**、队伍人数、可用调试设备（示波器？）
4. **机械件**：底座/灯罩/视窗是组委会下发还是自绘 3D 打印
5. **固件环境**：Keil MDK / STM32CubeIDE / 标准库 or HAL
6. 板载 SPI FLASH 是否使用（决定 PA6/PA7 能否当 PWM）
7. USB 5V 与 PIN_IN_+5V 是否直连（万用表实测）

---

## 10. 下一步（建议顺序）

1. 拿到 Q1/Q2 答案 → 定 RGB 驱动拓扑
2. 出扩展板原理图（嘉立创EDA专业版）→ DRC → PCB（2 层，电源区加粗，测试点在板边）
3. 同时写固件骨架：五级台阶逐级可演示（第一阶段的 5 个程序）
4. 物料到位后：先焊电源、逐级测压，再焊其它模块
5. 机械装配 → 盘车 → 低速成像 → 1200 rpm 闭环 → 整帧/彩色/动画 → 失锁
6. 加分项按性价比排：灰度（软件小改动）> 30 fps（机械+锁相）> PC 传图 > 分辨率扩展

---

## 11. 原理图现状（2026-10-24 从 .esch2 重建网表）

工作副本：`Nipkow/`（由 `Documents\LCEDA-Pro\projects\Nipkow` 复制，复制时逐字节一致）。
网表：`docs/NETS.md`（工具 `.tools/netlist.py`）。

**已确认的网表结构（59 个元件）：**

| 网络 | 成员 | 备注 |
|---|---|---|
| `VIN_MAIN` | J1.1 – D1.A | 输入 |
| `VIN_PROTECTED` | D1.K、C1/C3/C5/C7/C9/C10、U2.VIN、U3.VIN、J6.1、TP1 | 防反接后 |
| `+5V_REG` | U3.VOUT、C4/C8、R10.2、R12.1、Q4–Q6.E、R20–R22、JP1.1、TP2 | 5V 主轨 |
| `+3V3_EXT` | U2.VOUT、C2/C6、R13.1、R14.1、R16.1、R23.1 | 仅红外/指示 |
| `+5V_CORE` | **JP1.2**、U1.40、U1.80 | JP1 短接才注入 |
| `+3V3_CORE` | U1.38、U1.78、R15.2 | 设计上不接（避免并联 LDO） |
| `IR_INDEX` | U1.PA1、R13.2、J5.1、D2.K、TP5 | 透光=低（下降沿触发） |
| `R/G/B_PWM` | U1.PA6/PA7/PB0 → R17/R18/R19(1 kΩ) → Q4/Q5/Q6 基极；+ TP6/7/8 | TIM3 三通道，PWM 取反 |
| `RGB_x_K` | J3.1/2/3 ↔ R3(180)/R6(120)/R9(120) ↔ Q4/Q5/Q6 集电极 | 共阴高边（J3-4=GND） |
| `MOTOR_PWM` | U1.PB6、J6.3、TP9 | TIM4_CH1 |
| `KEY1/2` | PC0/PC1 ↔ 按键对 GND | 内部上拉 |
| `IR_TX_A` | J4.1 – R12(200Ω) – +5V_REG | 发射 18–19 mA |

**审查发现（待处理）：**

1. ✅ 已修：`+5V_CORE` 原本只连 U1-40/80，JP1-2 悬空 → 已加网络标签连通（见 CHANGELOG）。
2. ⚠️ **UART 无对外接口**：`UART_TX`(PA2)、`UART_RX`(PA3) 各只有一个引脚、没有连接器 → 第二阶段 PC 传图/调试需要，建议加 3 针排针（TX/RX/GND）或改用核心板调试口 USART1。
3. ✅ 已处理：C10 原 100 µF/0603 无法贴装 → 改为 **10 µF/25 V 0603**；100 µF 电解改为**外接**（J1 两端或 J6 电源端），见 `DECISIONS.md` 2026-10-26 与 `IR_DEVICE_CHECK.md` 同类思路。
4. ✅ 已更新：RGB 限流改为 **R3=180 Ω / R6=R9=120 Ω**（≈16.7 / 15 mA，5 V 供电），待灯珠实物 Vf 复核。
5. ⚠️ **PA6/PA7 与板载 SPI FLASH 共用**（PA4=CS）→ 已加 **R15 10 kΩ 上拉**到 +3V3_CORE；固件不初始化 SPI1。
6. ⚠️ **U2 轻载** 0.5–4 mA < LM1117 最小负载 → 加 330Ω–1k 假负载或改由核心板 3.3V 供电。
7. `+3V3_CORE` 两脚互连但不对其他网络供电——符合"不并联 LDO"决策，保留即可。
8. `EXP_IO1/2`(PC2/PC3)、`MOTOR_FG/AUX` 为预留单点网络，ERC 会报单点警告，属预期。

**引脚分配现状**（与 `docs/inbox/pinout_notes.md` 的差异）：

| 功能 | 实际（网表） | 排针号 | 说明 |
|---|---|---|---|
| R/G/B PWM | PA6/PA7/PB0 | P1-7 / P1-10 / P1-11 | 与建议稿一致 |
| IR_INDEX | PA1 | P1-4 | 一致 |
| 电机 PWM | PB6 | **P2-23** | 建议稿写 P2-25，笔误（PB4 才是 P2-25） |
| KEY1/KEY2 | PC0/PC1 | **P2-14 / P2-15** | 建议稿写 P2-16/P2-15，PC0 笔误 |
| UART | PA2/PA3 | P1-1 / P1-6 | 无连接器 |
| EXP_IO | PC2/PC3 | P2-16 / P2-17 | 建议稿写 P2-18，笔误 |
