Lilffy/NIPKOW/docs/QUESTIONS.md

# 待确认问题（按阻塞程度排序）

状态：⬜ 未答 / ✅ 已答 / 🚫 作废。答案同步进 `docs/PROJECT_BRIEF.md` 与 `docs/DECISIONS.md`。

## 已答

| # | 问题 | 答案 | 来源 |
|---|---|---|---|
| Q1 | RGB 灯珠共阴还是共阳？ | ✅ **共阴**（最终）：J3-4 = GND（公共阴极），J3-1/2/3 = 红/绿/蓝阳极，Q4–Q6（S8550 PNP 高边）驱动；旧共阳/低边组（Q1–Q3 + R2/R5/R8）保留但 **DNP 不贴** | 组委会口径 + `DECISIONS.md` 2026-10-24 条 |
| Q2 | 电机是 ESC 还是内置驱动？ | ✅ **3720、6–12 V、内置驱动无刷电机**，5 线（红/黑/蓝PWM/绿FG/黄未知），PWM=PB6/TIM4_CH1 | 交接文档 §4.5 |
| Q3 | 核心板 5V/3.3V 排针脚号 | ✅ **40=PIN_IN_+5V，38=+3V3**（两排针相同）；交接文档写反了，已纠正 | 官方 PDF p7 矢量线段 + 你的符号交叉验证 |

## 待答（阻塞）

| # | 问题 | 影响 | 状态 |
|---|---|---|---|
| Q4 | 板载 SPI FLASH 用不用？决定 PA6/PA7（占用 SPI1 的 MISO/MOSI）能否当 RGB PWM，或改到 PB4/PB5/TIM4 通道 | RGB 引脚/PCB 布局 | ⬜ |
| Q5 | USB 5V 与 PIN_IN_+5V 是否直连？（PDF p3 的菱形元件）→ 断电蜂鸣档实测 | 能否 USB 与扩展板 5V 同时接 | ⬜ |
| Q6 | 电机规格书：PWM 频率/占空比–转速、输入电平、堵转电流、FG 类型、黄线 | J6 电路与固件 | ⬜ |
| Q7 | RGB 灯珠型号/额定电流/Vf（**共阴**，三合一 4 线；实物到手确认） | 限流电阻 | ⬜ |
| Q8 | 电源适配器：标称电压/电流/极性；用 9 V 还是 12 V | U3 热耗 | ⬜ |
| Q9 | 扩展板要不要自带用户 LED（第一阶段第 4 条"中断点亮 LED 1 秒"）？还是用核心板 PB2 | 验收项 | ⬜ |
| Q10 | UART 用哪两脚？EXP_IO1/2 用途？ | 排针/固件 | ⬜ |
| Q11 | PCB 尺寸/固定孔/与底座机械关系 | 布局 | ⬜ |
| Q12 | 两阶段验收日期、队伍人数、调试设备 | 排期 | ⬜ |
| Q13 | 固件环境：Keil MDK / CubeIDE / 标准库 or HAL | 工程脚手架 | ⬜ |

## 已发现但需实物核对的疑点

1. 孔排布：文写"同一母线"，图 1 画"螺旋（每 22.5° 升高一行）"→ 以螺旋为准，装配后确认。
2. 交接文档 5V/3.3V 引脚编号写反（已纠正，见 Q3）。
3. RGB 限流 330/270/270 Ω 对应 ≈9/6.7/6.7 mA，偏暗。
4. U3 热耗 0.8–1.4 W，TO-220 需散热。
5. U2 轻载 0.5–4 mA，低于 LM1117 最小负载。
