Lilffy/NIPKOW/handover/README_A.md

# A 的交接包（2026-10-26）

> 提交人：A（`Layla82693`）的助手
> 对应 issue：#20「[A] 提交 A 的交接包」
> 放在 `handover/` 而不是直接铺到 `docs/`，是为了**不覆盖 B 已有的同名文件**（B 的 `docs/BOM.md`、`TASKS.md`、`CHANGELOG.md` 保持不动）。

---

## 一、这里面是什么

### `docs/` — 给 A 用的作业文档

| 文件 | 用途 |
|---|---|
| `A_新手行动手册.md` | 通俗版：买什么、怎么焊、怎么上电、验收说什么 |
| `A_新手一周学习计划.md` | 等板这一周 7 天学什么（每天有验收标准） |
| `A_STAGE1_TASKS.md` | 第一阶段详细清单：7 步焊接、6 组数据、12 个 issue |
| `TEAM_SPLIT.md` | 两人分工、4 周时间线、三张接口表（电源树/引脚/串口协议） |
| `PCB_P0_PLAYBOOK.md` | 板框/安装孔/出图下单（若板未布通时的操作手册） |
| `ROUTING.md` | 线宽表、6 条关键网络路径、地策略、4 项电气复核 |
| `RISKS.md` | 21 条风险（含 PB2 极性、C10 封装、LM1117 输出 ESR） |
| `B仓库阅读报告.md` | 读完 B 仓库 22 个文件的结论：权威顺序、定论、文档矛盾 |
| `打板下单.md` | Gerber 核验结果 + 嘉立创下单参数 + 付款前 5 项检查 |
| `原理图怎么看.md` | 解释原理图为什么看着糙 + 读图三原则 + 分块图索引 |
| `LETTER_TO_B.md` | 之前写给 B 的信（已过时，留档） |
| `A_打印包.pdf` / `.docx` | **12 页 A4 打印包**：焊接卡、上电卡、测试点、记录表、采购单、极性速查、分块图、打卡表 |

### `docs/mech/` — 机械文件

- `board_100x90.dxf`：板框 100×90 + 4×M3 孔（可给底座开孔用）
- `board_99x89.dxf`：备用窄边方案
- `preview_*.png`：预览图

### `docs/img/` — 打印用图片

- `01_核心板与排母.png`、`02_电源区.png`、`03_RGB驱动.png`、`04_红外与连接器.png`
- `gerber_preview.png`：Gerber 渲染预览（红=顶层铜 蓝=底层铜 绿=板框 黄=钻孔）

### `tools/` — 生成脚本

| 脚本 | 作用 |
|---|---|
| `make_board_dxf.py` | 生成板框/孔 DXF + 预览（改尺寸重跑） |
| `make_bom.py` | 生成对照 BOM + CSV |
| `make_print_pack.py` | 生成 12 页打印包（docx → pdf） |
| `gerber_view.py` | 最小 Gerber/Excellon 解析 + 预览渲染 |
| `make_manifest.py` | 生成带 SHA-256 的文件清单 |

---

## 二、这次核对出来的、要 B 知道的三件事

1. **Gerber 没变**：`hardware/Gerber.zip` 的 git 对象哈希 `e12ddb68…` 与 10-25 首版一致；C10 从 100µF 改 10µF/25V 只是 BOM 值变化，封装仍 0603，铜箔未动。→ 打板用现有 zip 即可，不需要重新导出。
2. **PB2 极性已由 B 修正**（`92edca9`，改为高电平点亮），与核心板原理图 `PB2→LED2→R29→GND` 一致。
3. **C1/C3 是 10µF/0603 挂在 9–12V 输入上**：0603 的 10µF 常见耐压 6.3/10V，建议采购 16V 以上规格，或只在 9V 适配器下使用。这是目前唯一还没解决的电气隐患。

---

## 三、A 接下来按什么顺序做

1. 打板（Gerber 已核验，见 `docs/打板下单.md`）
2. 买料（`docs/A_打印包.pdf` 第 7 页采购清单，带立创编号）
3. 等板期间按 `docs/A_新手一周学习计划.md` 练手
4. 板到后按 `docs/A_打印包.pdf` 第 2 页焊接卡 → 第 3 页上电卡
5. 每次上电填一张第 5 页记录表，数据发 issue

---

## 四、需要 B 帮的三件事

1. 把本目录的 `docs/*.md` 选择性并入 `docs/`（或保持 `handover/` 独立也行）
2. 确认 `C1/C3` 的耐压选型（见上 §二.3）
3. 板子如果还没下单，确认下单参数（`docs/打板下单.md` §3）
