Lilffy/NIPKOW/docs/PCB_ITERATION_PLAN.md

# PCB 迭代打板计划（V1 → V2）

> 背景：组委会允许多次打板，只要按时提交。策略从“一次定型”改为“**V1 验证 + V2 收敛**”。
> 更新：2026-10-26

## 总策略

```
V1（当前 Gerber，已布通/DRC 0）
  → 下单打样（2 层，3–5 天 + 快递 1–2 天）
  → 到板 48h 内跑完「V1 验证清单」
  → 汇总问题 → V2 修改 → 打 V2
  → V2 做最终提交版（V1 留作备件/机械调试）
```

## V1 定位：电气与接口验证

**V1 必须验证的（决定 V2 改不改）**

| # | 验证项 | 判据 | 若不通过 |
|---|---|---|---|
| 1 | 电源：VIN/5V/3V3 | 5V 4.9–5.1V，3V3 3.2–3.4V | V2 改 U3 散热/换 LDO |
| 2 | RGB 灯珠形态 | 4 线=三合一；共阴=可直接用 | 共阳 → V2 改低边/割铜 |
| 3 | RGB 亮度与色准 | 8 色可辨，单色可常亮 | V2 调 R3/R6/R9 阻值 |
| 4 | 红外对射 | 遮光≈3.3V、通光<0.99V（TP5） | V2 调 R12/R13 或改电路 |
| 5 | 电机接口 | 电机能转、方向正确、PWM 有效 | V2 改 J6 定义/加保护 |
| 6 | 核心板排针 | 插拔顺畅、40/38 脚对 | V2 改排母位置 |
| 7 | 机械孔位 | 与鼓/底座装配得上 | V2 改孔径/位置 |
| 8 | 串口 J7 | PC 能收发 | V2 改线序 |

**V1 已知待改进（直接进 V2 清单）**

- C10：0603 只能贴 10µF；100µF 需外接 → V2 换 6.3mm 贴片电解或换 1210
- U3 散热：TO-220 无散热片空间 → V2 加敷铜/预留散热片位置
- J3：4 针端子若灯珠为共阳 → V2 加跳线/割铜焊盘
- 丝印：接口名/极性/版本号可更清楚
- 测试点：TP1–TP9 位置可再优化到板边
- 机械：M3 孔位按实测底座调整

## V2 修改清单（到板后按实测填写）

| 项 | 状态 | 说明 |
|---|---|---|
| C10 封装 | 待定 | 6.3mm SMD 电解 or 1210 |
| RGB 拓扑 | 待定 | 取决于 V1 灯珠实物 |
| R3/R6/R9 | 待实测 | 按亮度/色准调 |
| R12/R13 | 待实测 | 200Ω→220Ω、1k→2.2k 视情况 |
| 丝印/测试点 | 待优化 | |
| 机械孔位 | 待实测 | |

## 时间倒排（待填截止日期）

| 阶段 | 时长 | 备注 |
|---|---|---|
| V1 打样+快递 | 5–7 天 | 嘉立创 2 层 |
| V1 焊接+验证 | 2 天 | A 主责 |
| V1→V2 改板 | 1 天 | B 改 EDA，重新出 Gerber |
| V2 打样+快递 | 5–7 天 | |
| V2 焊接+整机联调 | 3–5 天 | |
| **合计** | **约 16–22 天** | 需留缓冲 |

> ⚠️ 若距提交不足 20 天，V2 可能来不及 → 策略改为“V1 直接作为提交版，问题用飞线/割铜/外接解决”。

## 2026-10-26 更新：第一阶段截止 **11-06（下周五）**，V1 已下单

今天 = **2026-10-26 周一**，截止 = **2026-11-06 周五**，共 **11 天**。

**结论：放弃 V2，V1 就是交付版。** 一切问题用飞线/割铜/外接/换阻值解决。

### 倒排（实际执行表）

| 日期 | 任务 | 负责人 | 关键点 |
|---|---|---|---|
| 10-26（周一） | PCB 已下单 ✅ | A/B | 确认嘉立创生产周期+快递 |
| 10-26 ~ 10-29 | **元器件/工具必须到货** | A | ST-Link、USB-TTL、阻容、端子、焊台 |
| 10-26 ~ 10-30 | 固件 M2（RGB）+ M3（电机）+ M4（串口） | B | 无板可写、可编译 |
| 10-26 ~ 10-30 | 上电测试清单、五任务演示脚本 | B | 文档先行 |
| 预计 11-01 ~ 11-03 | **PCB 到货** | — | 到货当天开始焊 |
| 到货当天 | 电源区焊接+上电测压 | A | 限流 200mA |
| +1 天 | 全焊 + 下载 M0/M1 验证 | A+B | 串口/心跳/红外 |
| +2 天 | M2/M3 联调 + RGB/电机实测 | A+B | 调阻值 |
| 11-05 | 五任务联排 + 演练 | A+B | 10 分钟流程 |
| 11-06 | 第一阶段验收 | A+B | 留半天缓冲 |

### 风险与对策

| 风险 | 概率 | 对策 |
|---|---|---|
| PCB 到货晚于 11-03 | 中 | 联系嘉立创加急/顺丰；同步准备核心板+面包板先验 M0/M1 |
| 元器件没到 | 中 | **今天就下单**（阻容 0603 套装、端子、排针、LDO、三极管） |
| 灯珠是共阳 | 中 | 割铜+飞线改低边（Q1–Q3 焊盘预留） |
| 红外弱光 | 中 | R13 换 2.2k / R12 换 220Ω |
| 焊错/板坏 | 低 | 嘉立创可加急补单，但时间极紧 → 焊接严格按 A_HANDOVER_NOTES |

### 现在就要做的（本周）

1. **A**：确认元器件采购单已下单，列出缺货项；准备焊台/万用表/ST-Link/USB-TTL
2. **B**：写完 M2 + M3 固件并用软件自测（无板）
3. **A+B**：建一个 `[P0] 第一阶段冲刺` issue，把上表变成 checklist
