Lilffy/NIPKOW/docs/DECISIONS.md

# 决策记录

格式：日期 · 决策 · 理由 · 影响文件

## 2026-10-24 建立项目文档结构
- `docs/inbox/` 只读原始文件；`docs/text/` 抽出的文本；`docs/render/` 关键页图片；`docs/PROJECT_BRIEF.md` 摘要；`docs/INDEX.md` 索引；`docs/QUESTIONS.md` 待确认。
- 理由：上下文有限，靠"文件 + 摘要 + 索引"实现跨会话可复现的"记忆"。

## 2026-10-24 本地工具链放 `.tools/`，Python 库装到 `.tools/pylibs`
- 用 DSH 自带 Python 3.12 + urllib 直接下载 wheel 解包（系统 pip 被沙箱拦截）。
- 已装：pypdf 6.9.2（PDF 抽文本）、PyMuPDF 1.26.5（PDF 渲染 PNG）。
- 理由：不污染系统环境、可随时删除；`.tools/` 不进交付物。

## 2026-10-24 RGB 驱动按"5 V + 开关管"设计，否决 3.3 V GPIO 直驱
- 理由：绿/蓝 LED Vf≈3.2 V，3.3 V 直驱无余量；文档给的 150 Ω/100 Ω 是 5 V 下的值。
- 待定：灯珠共阴/共阳（Q1）决定用 NMOS 低边还是 PNP 高边。

## 2026-10-24 以"螺旋排孔"为准理解机械结构
- 理由：16 × 22.5° = 360°，逐行进光要求同一时刻只有一个孔在视窗内；文字"同一条母线"与图 1 矛盾，按图 1 与几何计算执行，装配后实物复核。

## 2026-10-24 接受交接方案的供电架构（5V 注入核心板）
- 扩展板 U3(LM1117-ADJ)→5V→JP1→核心板 PIN_IN_+5V，核心板自带 LDO 产 3.3V；扩展板 U2(3.3V) 只供红外/指示。
- 理由：避免双 LDO 并联与反灌；代价是 U3 热耗上升，需散热核算。

## 2026-10-24 纠正 5V/3.3V 排针脚号
- 结论：**40 = PIN_IN_+5V，38 = +3V3**（官方 PDF p7 矢量线段实测；与 EDA 符号一致）。
- 交接文档"38=5V、40=3.3V"错误，按此接会烧核心板。JP1-2 → U1-40（或 80）。

## 2026-10-24 新发现待处理项
- PA6/PA7 与核心板板载 SPI FLASH 共用 → PA4 加上拉或换 PWM 脚。
- U2 轻载 → 加假负载或改由核心板 3.3V 供电。
- RGB 限流偏小（≈9/6.7/6.7 mA）→ 待灯珠额定电流确认后调整。

## 2026-10-24 UART 走核心板调试口（不加扩展板连接器）
- 核心板自带 10 针调试口含 USART1_TX/RX（PA9/PA10）+ 3.3V + GND，USB-TTL 直接插。
- 理由：少一个连接器、少一处机械开口；阶段二 PC 传图够用。
- 代价：PA2/PA3 的 `UART_TX/RX` 成为预留网络（ERC 单点警告，可接受）。

## 2026-10-24 阻值先按"共阳 8mm RGB"预估（实物到手复核）
- R3=180 Ω（≈16.7 mA）、R6/R9=120 Ω（≈15 mA）、R14=1 kΩ、R16=470 Ω（U2 假负载）。
- 依据：Vf(红)≈2.0 V、Vf(绿蓝)≈3.2 V、5 V 供电；扫描占空比低，峰值 15–20 mA 安全。
- 若实物为**共阴**，三路要改 PNP/PMOS 高边，拓扑变化，**打 PCB 前必须确认**。

## 2026-10-24 C10（100 µF 电解）封装暂缺
- 原理图先按电容符号 + 值标注；封装待定（取决于机械空间与选型），打 PCB 前必须落实。

## 2026-10-24 灯珠极性：改为**共阴**（最终）
- 依据：组委会"两种都行但推荐共阴"，且确认内部测试用共阴。
- 拓扑：PNP 高边（S8550）— 限流电阻 — 灯珠阳极；公共阴极接 GND。
- 驱动：基极 1 kΩ 到 GPIO + 10 kΩ 上拉到 5 V，**GPIO 开漏输出**（低=亮，PWM 取反）。
- 现有 NMOS 低边组保留但不贴（BOM 标注），漏极连接需断开防直通。
- 阻值：红 180 Ω、绿蓝 120 Ω（仍待实物 Vf 复核）。

## 2026-10-26 RGB 灯珠形态：按**三合一 4 线共阴**设计，实物到手再确认
- 电路现状：J3 为 4 针线对板端子（A2547WV-4P），1/2/3 = 红/绿/蓝阳极（各经限流电阻到 PNP 高边），4 = 公共阴极 GND。
- 赛题物料清单第 9 项写"RGB 三路 LED 灯珠 / 焊线安装 / 提供"，**4 线 = 三合一，6 线 = 三只分立**，需实物确认。
- **如果是分立三只**：电气上可接（三阳极接 J3-1/2/3，三阴极共接 J3-4），但机械上必须把三色聚到同一点，否则扫描成像有颜色视差 → 优先要求/更换为三合一。
- **如果是共阳**：改贴预留的 Q1–Q3 低边组 + R2/R5/R8，公共端接 +5V；但 J3-4 现直连 GND 铜箔，需割铜+飞线，属改板级操作，需人类确认。
- 确认方法：数线数；万用表二极管档测公共端（红笔/黑笔分别对三色，能测出三个 Vf 的即公共端）；公共端为阴极=共阴。

## 2026-10-26 第一阶段人机交互：KEY1 选目标 + KEY2 调 6 级（每通道独立）
- 方案：KEY1 短按在 **R → G → B → MOTOR** 四个目标间循环；KEY2 短按把当前目标亮度/速度 `level = (level+1) % 6`（0=关，1–5 递增）。
- **每路独立存储**：`uint8_t lv_rgb[3]` 与 `uint8_t lv_motor` 分开；KEY2 只改当前选中目标的 level。
- 是否满足赛题"三路 LED 可分别常亮、三路 PWM 独立调光、每路至少 4 级"：
  - 独立：每路有自己的 level，互不影响 ✅
  - 常亮：把某一路 level 调高、其余两路 0，即为单色常亮 ✅
  - ≥4 级：每路可选 0–5 共 **6 档**（其中 1–5 为亮度/速度档，0 为关）✅
- 档位映射建议（人眼感知非线性，别用等分）：
  - RGB 亮度：`{0, 25%, 45%, 65%, 85%, 100%}` → compare = 1000 − duty
  - MOTOR：`{0(停), 20%, 40%, 60%, 80%, 100%}`，实物到手后按启动占空比重新标定
- 演示顺序（现场验收用）：KEY1 选 R → KEY2 从 0 逐档升到 5（展示 5 级亮度）→ 同样演示 G、B → 最后 MOTOR 展示启停与调速。
- 备选/兜底：M4 串口命令（`RGB r g b` / `LEVEL n` / `COLOR n`）同时实现，现场若按键不便可用串口。
- 不采用：单一"全局亮度"旋钮式调节（不满足"独立"要求）。
- 影响文件：`firmware/cubemx/Core/Src/keys.c`、`rgb.c`、`main.c`、`docs/FIRMWARE_MODULES.md`
