Lilffy/NIPKOW/docs/HANDOVER_REVIEW.md

# 交接文档对照审查

> 审查对象：`docs/inbox/handover.md`（GPT 代写的交接说明，2026-10-25）
> 对照物：`docs/PROJECT_BRIEF.md`（我 10-24 写的方案）、`docs/inbox/board_schematic.pdf`（官方原理图）、
> 以及你 EDA 工程里的实际原理图 `...\LCEDA-Pro\projects\Nipkow\sch\Schematic1\P1.esch2`（我解析过）
> 结论日期：2026-10-24

---

## 0. 一句话结论

**路线不冲突，可以接手。**交接文档的工程判断基本靠谱（尤其"不把 3.3V 灌进核心板"这个决定是对的）；
但有 **1 处危险错误必须纠正**、**3 处需要改**、**5 处不明确**，另有 **3 个双方都没提到的隐患**。

| 类别 | 数量 | 说明 |
|---|---|---|
| 危险错误 | 1 | 交接文档把 5V / 3.3V 的排针脚号写反了（见 2.1） |
| 需要修改 | 3 | RGB 限流偏小、U3 热耗、U2 轻载 |
| 不明确 | 5 | 见第 3 节 |
| 新发现隐患 | 3 | PA6/PA7 与板载 SPI FLASH 共用、USB/PIN 5V 关系、无用户 LED |

---

## 1. 与我的方案逐项对照

| 项目 | 我 10-24 的方案 | 交接文档 / 你现在的设计 | 判定 | 处理 |
|---|---|---|---|---|
| 3.3V 供电对象 | LM1117-3.3 供 MCU + 光电接收 | 5V 经 JP1 注入核心板，核心板自产 3.3V；扩展板 3.3V 只供红外上拉/指示 | **改**（交接方案更安全） | 接受，已更新简报 |
| RGB 灯极性 | 待定（Q1） | **共阳极 8mm 4 针**，J3-4=+5V，AO3400A 低边开关 | **一致** | 我的判断得到验证 |
| RGB 限流 | 150Ω/100Ω @20mA | 330/270/270Ω ≈ 9/6.7/6.7mA | **冲突** | 偏暗，需按灯珠额定值定（见 2.6） |
| 电机接口 | 电调 ESC + 50Hz 1–2ms 舵机信号 | 3720 内置驱动无刷电机，5 线（红/黑/蓝PWM/绿FG/黄未知），PB6/TIM4_CH1 | **改**（实物已明确） | 仍需规格书确认 PWM 频率/电平 |
| 光电索引 | 1k 上拉 + 指示 LED（并联） | 一致；D2+R14 并在 +3V3 与 IR_INDEX 之间 | **一致** | 逻辑正确 |
| 测试点 | 8 项 | 9 个（TP1–TP9） | **满足** | 建议补 FG、5V 注入点 |
| 按键 | GPIO + 内部上拉 + 消抖 | KEY1=PC0、KEY2=PC1，另一端 GND | **一致** | 需确认封装常开触点 |
| 5V/3.3V 引脚 | 未指定 | 交接文档称 P1-38=5V、P1-40=3.3V | **错误** | 见 2.1，实际 40=5V、38=3.3V |

---

## 2. 关键核对结果（附证据）

### 2.1 ⚠️ 5V / 3.3V 的排针脚号：交接文档写反了

**交接文档说**：`P1-38 = PIN_IN_+5V`，`P1-40 = +3V3`（P2 同理）。

**我从官方 PDF 第 7 页的矢量线段实测**：

- `y=290.9` 的水平导线接的是 **+3V3** 电源端口，对应排针**第 19 行**（右列为 38 号）；
- `y=298.1` 的水平导线接的是 **PIN_IN_+5V**，对应**第 20 行**（右列为 40 号）；
- 两个编号的文本坐标（37/38 在 y≈287、39/40 在 y≈294）与行位一一对应。

**结论：`40 = PIN_IN_+5V`，`38 = +3V3`（两个排针相同）。**

**交叉验证**：你 EDA 里「立创·梁山派-天空星开发板」符号的引脚定义是
`Pin 38 = +3V3`、`Pin 40 = +5V0`、`Pin 78 = +3V3`、`Pin 80 = +5V0` —— **与官方 PDF 一致，你的符号是对的**。

→ **JP1-2 应接 U1 的 40 号脚（H1 侧；镜像位置是 80 号脚/H2 侧）。**
→ 按交接文档接会把 5V 灌到 3.3V 轨上，核心板直接报废。**这条已在交接文档里标红纠正。**
→ 上电前建议再用万用表确认一次（断电，量排针 40 与 38 对 GND 的通断/电压）。

### 2.2 核心板 5V 与 USB 5V 的关系（交接文档第 3 项待验证）

官方 PDF 第 3 页左上角：`USB_IN_+5V` 与 `PIN_IN_+5V` 之间有一个**无位号的菱形元件**（PDF 里没有位号，不在 BOM 里，疑似跳线/网络短接/理想二极管类），
主回路上 USB-C VBUS → `F1 500mA` → `+5V` → `SCJA1117B` LDO → `+3V3`。

- 若菱形是**短接/0Ω**：两者是同一个网络，**USB 与 JP1 5V 绝对不能同时接**（会向电脑 USB 口倒灌）。
- 若是**二极管**：可以同时存在，取高者供电。

**未测量前，按"不同时接"执行**；一测（断电蜂鸣档量 USB VBUS ↔ 排针 40）即可确定。

### 2.3 🔥 U3（LM1117-ADJ，5V）热耗：新发现，必须核算

改成"5V 注入核心板"后，5V 轨负载变大了：

| 负载 | 估算电流 |
|---|---|
| 核心板（3.3V LDO 输入折算） | 100–200 mA |
| RGB 三路（按 7–20 mA/路） | 20–60 mA |
| 红外发射（5V/200Ω） | 19 mA |
| **合计** | **约 150–280 mA** |

U3 耗散：
- 9V 输入：(9−5) × 0.2 ≈ **0.8 W**
- 12V 输入：(12−5) × 0.2 ≈ **1.4 W**

TO-220 无散热片 θja≈50–65 °C/W → 温升 40–90 °C，夏天/封闭壳内会烫手甚至热保护。

**处理（按优先级）**：
1. 输入用**标称 9V**（别用 12V），并给 U3 加散热片/大面积敷铜；
2. 若实测仍过热，改 buck（MP1584/MP2307 模块）——但组委会发的是 LM1117-ADJ，属于自备件，加分/评分不受影响，需确认允许。

### 2.4 ⚠️ PA6 / PA7 与核心板板载 SPI FLASH 共用：新发现

官方 PDF 第 1 页层次图：`SPI-FLASH` 模块接 **PA4(CS) / PA5(CLK) / PA6(MISO) / PA7(MOSI)**。
你的三路 PWM 用的是 `PA6 (R_PWM)`、`PA7 (G_PWM)`。

- 电气上可行：只要 PA4 保持高（片选无效），flash 的 DO 是高阻；PA7 是 flash 输入，也高阻。
- 风险：**PA4 复位后浮空**，flash 可能被误选中，PA6 上出现 flash 输出 → 与 PWM 冲突。
- 处理（二选一）：
  - a) 扩展板上 **PA4 加 10k 上拉到 +3V3**（强制 CS 无效），保留 PA6/PA7；
  - b) 换 PWM 脚到不冲突的定时器通道（如 TIM3 的 PB4/PB5，或 TIM4 的 PB7/PB8/PB9）。
- 需要你定：**板载 SPI FLASH 这次用不用？** 不用就选 a。

### 2.5 U2（LM1117-3.3）轻载：新发现

U2 现在只供 R13(1k) + R14/D2，负载仅 **0.5–4 mA**，低于 LM1117 典型最小负载（5–10 mA），空载时输出可能偏高（>3.4V）。

- 处理：加 330Ω–1k 假负载（≈3–10 mA），或把红外上拉/指示改由**核心板 3.3V（38/78 脚）**供电，直接去掉 U2。

### 2.6 其它复核

- **RGB 限流**：Vf 红≈2.0V、绿蓝≈3.2V，5V 供电时：
  - 现设计 330Ω（红）≈9mA、270Ω（绿/蓝）≈6.7mA —— **偏暗**，且 8 色里的黄色（红+绿）会更暗；
  - 若灯珠额定 20mA：红 150Ω、绿蓝 100Ω；保守取 180Ω / 120Ω（≈17/15mA）。
  - 注意：AO3400A 的 Rds(on)≈30mΩ，压降可忽略；但长时间满占空比对 8mm 灯珠散热有要求。
- **IR 指示 LED 接法**：D2 阳极经 R14 接 +3V3、阴极接 IR_INDEX —— 当 IR_INDEX 被拉低时点亮，**逻辑正确**；但与上拉并联会多灌 0.5mA，可接受。
- **反灌路径**：只有"扩展板带电、核心板未上电（JP1 拔掉）"时，+3V3_EXT 会经 R13 灌入 PA1（约 3.3mA）。按操作规则（拔 JP1 时不单独给扩展板上电）即可规避，或在 PA1 串 100Ω。
- **ERC**：交接文档的 0 错误 10 警告是在 JP1 改动**之前**跑的，不能沿用；改线后必须重跑。

---

## 3. 不明确的地方（按阻塞程度排序）

| # | 问题 | 为什么卡 | 谁能回答 |
|---|---|---|---|
| U1 | JP1-2 接哪个脚 | 已解决：U1-40（或 80）——等你点头 | 我 + 你复核 |
| U2 | USB 5V 与 PIN_IN_+5V 是否直连（菱形元件） | 决定"能否同时接 USB 和扩展板 5V" | 万用表实测 |
| U3 | 电机规格书：PWM 频率/电平、堵转电流、绿 FG 类型、黄线定义 | 决定 J6 电路（是否需要上拉/电平转换/保护） | 卖家/说明书 |
| U4 | RGB 灯珠型号、额定电流、Vf（8mm 共阳 4 脚） | 决定限流电阻 | 实物/卖家 |
| U5 | 电源适配器：标称电压/电流/插头极性 | 决定 U3 热耗与 J1 接线 | 你 |
| U6 | 板载 SPI FLASH 用不用 | 决定 PA6/PA7 方案 | 你 |
| U7 | UART 用哪两个脚？EXP_IO1/2 做什么？ | 影响排针与固件 | 你 |
| U8 | PCB 尺寸/固定孔/与底座机械关系 | 决定布局 | 你/组委会 |
| U9 | 第一阶段第 4 条要求"编码器中断点亮 LED 1 秒"——扩展板上没有普通 LED（D2 是 IR 指示） | 验收项 | 用核心板 PB2 用户 LED 或加 1 颗 LED |
| U10 | ERC 的 10 个警告逐条处理 | 收尾 | 我 |

---

## 4. 接手方式（受沙箱限制，必须先解决）

我能**读**你的工程（已验证），但**不能写** `C:\Users\23041\Documents\...`（沙箱只允许写 `C:\Users\23041\Downloads\Nipkow`）。

两个方案：

- **方案 A（推荐）**：你把工程文件夹复制一份到
  `C:\Users\23041\Downloads\Nipkow\eda\Nipkow`
  然后用 EDA 打开这个副本（File → 打开工程）。之后我直接改 `.esch2` 文件，双向同步会刷新，你在界面里看效果；原工程保留作备份。
- **方案 B**：我出"每一步点哪里、连哪根线"的精确清单，你在 EDA 里点（像之前 GPT 带你那样，但更快）。

---

## 5. 我建议的下一步（一次只做一件事）

1. 【你】确认 JP1-2 → U1.40（或选择方案 A 让我直接改）
2. 【我】接上 JP1-2，重跑 ERC，把 10 个警告分类
3. 【我】出三处修改：U3 散热方案、PA4 上拉（或换脚）、RGB 限流电阻
4. 【你】万用表测 USB 5V ↔ 排针 40
5. 之后才进入布局布线（电源/电机电流路径、地回流、红外与 PWM 隔离、核心板方向、固定孔）
