Lilffy/NIPKOW/docs/TASKS.md

# 任务清单 V2.0（2026-10-25 更新）

> 替代 `docs/inbox/task_points.md`（GPT 版 V1.0，已归档）。
> 依据：当前原理图（共阴版，SHA-256 `8D46D07D…CBC9B`）、PCB 摆放结果、交接文档与赛题。
> 标记：✅ 完成 · 🟡 进行中 · ⬜ 未开始 · ⚠️ 有风险/待确认

---

## 0. 相对 V1.0 的关键变更（先看这个）

| 项 | V1.0 写法 | 现在的事实 |
|---|---|---|
| RGB 驱动 | 三路 MOSFET 低边，J3-4 = `+5V_LED`，共阳 | **改为共阴**：Q4–Q6（S8550 PNP 高边）+ 基极 1k/10k，J3-4 = **GND**；Q1–Q3（AO3400A）标 **DNP 不贴**，R1/R4/R7 已删 |
| 供电 | 3.3V 稳压器给 MCU + 红外；5V 给灯 | **5V 经 JP1 注入核心板 `PIN_IN_+5V`**，核心板自带 LDO 产 3.3V；扩展板 U2 的 3.3V 只供红外/指示，并加 R16 假负载 |
| 电机 | 需确定 ESC + 控制协议 | 实物是 **3720 内置驱动无刷电机**（5 线：红/黑/蓝PWM/绿FG/黄未知），不需要 ESC；PWM=PB6/TIM4_CH1 |
| 串口 | 待补 | **已加 J7（1×4 2.54）**：GND / TX(PA2) / RX(PA3) / 第4脚经 **R23(0Ω,默认不贴)** 预留 +3V3；核心板调试口（USART1）可作备用 |
| 排针编号 | 待核对 | 已核对：**40 = PIN_IN_+5V，38 = +3V3**（原交接文档写反，已纠正）；PA9/PA10 只在调试口、不在 2×20 排针上 |
| PA6/PA7 | 未提 | 与核心板板载 **SPI FLASH 共用**（PA4=CS）；已加 **R15 10kΩ 上拉**把 CS 锁高 |
| BOM | 待生成 | 已生成 `docs/BOM.md` + `BOM_draft.csv`（59 项，含 J7/R23），缺立创编号、C10 封装待定 |
| PCB | 未开始 | 59 个封装已按分区摆放（110×90 假设），**板框/安装孔/布线未做** |

---

## 1. 现状快照

| 项 | 状态 |
|---|---|
| 原理图 | ✅ 功能完整、共阴版、已分区；ERC 上次 0 错误/10 警告（**改动后需重跑**） |
| 网表 | ✅ 工具 `.tools/netlist.py`，结果在 `docs/NETS.md` |
| BOM | 🟡 明细完整，缺供应商编号；C10 封装、KEY 型号待定 |
| PCB | 🟡 59 器件已摆放（0 重叠），缺板框/安装孔/布线 |
| 实物 | ⬜ 电机、灯珠、传感器、电源在 PCB 生产后才到 |

---

## 2. 已完成（✅）

### 2.1 方案与文档
- ✅ 读完赛题、指导文档、核心板原理图、交接文档，归档并做完整性校验（`docs/MANIFEST.md`）
- ✅ 参数复核（16×25、125 µs、22.5°、r=80 等）
- ✅ 与交接文档对照，纠正 5V/3.3V 脚号错误（`docs/HANDOVER_REVIEW.md`）
- ✅ 建立工作副本 `Nipkow/`（原理图 + PCB），带哈希与回滚备份

### 2.2 原理图
- ✅ 电源：J1、D1(SS34)、U2(LM1117-3.3)、U3(LM1117-ADJ, 120/360→5V)、C1–C8、R10/R11、JP1（5V 注入）、R16（U2 假负载）
- ✅ RGB：**共阴** PNP 高边（Q4–Q6 S8550 + R17–R22），限流 R3=180Ω / R6=R9=120Ω，J3；旧 NMOS 组 DNP
- ✅ 红外：J4（发射 + R12 200Ω）、J5（接收 + R13 1k 上拉）、D2/R14 指示、PA1 输入
- ✅ 按键：KEY1/KEY2（PC0/PC1，内部上拉）
- ✅ 电机：J6 5P（VIN/GND/PWM/FG/AUX），PB6 输出
- ✅ 串口：J7（GND/TX/RX + R23 0Ω 预留 3V3）
- ✅ 测试点：TP1–TP9（输入/5V/3.3V/GND/IR/三路 PWM/电机 PWM）
- ✅ 分区整理（`docs/SCHEMATIC_LAYOUT.md`）
- ✅ 4 轮网表验证（每次改动后对比，无意外短接）

### 2.3 PCB
- ✅ 从原理图更新 PCB（59 个封装）
- ✅ 按分区完成首次摆放（电源/核心板/RGB/红外/按键/测试点/串口），包围盒重叠 = 0
- ✅ 位号文字跟随器件（修正了"位号散落"的问题）

### 2.4 工具与流程
- ✅ PDF/DOCX 抽取、渲染、网表重建、ESP 文件编辑工具（`.tools/`）
- ✅ 改动日志与备份机制（`docs/CHANGELOG.md`）

---

## 3. 未完成（按优先级）

### P0：PCB 下单前必须完成

- ⬜ **画板框**：**100 mm × 90 mm**（界面按 mm 输入；对应 3937×3543 mil）
- ⬜ **4×M3 安装孔**（mm，孔 3.2）：(5.08,5.08) (94.92,5.08) (5.08,84.92) (94.92,84.92)
  > 若下单平台要求"**严格小于 100 mm**"，改用 99×89 mm（器件已按 100×90 摆放，边缘微调即可）
- ⬜ 确认核心板方向（USB/调试口/按键不被遮挡），必要时旋转 U1
- ⬜ **自动布线**（EDA 自动布线器）→ 之后手工收尾：加宽电源/电机线、补 GND 铺铜
- ⬜ 自动布线后检查未布通网络（ratsnest 残留），逐条手工补
- ⬜ 铺设 GND（底层整片），功率地/信号地单点汇接
- ⬜ 加宽电源/电机走线（5V 0.8 mm、VIN/电机 1.2–1.5 mm）
- ⬜ DRC 0 错误
- ⬜ 3D 预览：U3 散热片、排母、端子插拔空间
- ⬜ 丝印：接口名、极性、版本号、J7 定义
- ⬜ 导出 Gerber/BOM/坐标文件，下单（**单边 <100 mm**）

### P0：BOM / 采购（可与 PCB 并行）

- ⬜ 补全**立创编号**（J1/J3/JP1/U2/U3 等，ERC 有 5 个"编号不匹配"）
- ⬜ 确认 U2 用 **C126027**（赛题）还是 **C55544533**（当前器件名）
- ⬜ 确认 KEY1/KEY2 实物与 **C5379898** 同封装
- ⬜ 确定 **C10**（100 µF/25 V）封装（建议 6.3×7.7）
- ⬜ 核对 RGB 灯珠（8 mm 共阳/共阴、四脚顺序）——**等实物**
- ⬜ 核对电机 5 线定义、PWM 电平——**等实物**
- ⬜ 买：U3 散热片、端子、排针、备用阻容

### P1：板到货后（硬件）

- ⬜ 焊接顺序：电源 → 测电压 → 其余
- ⬜ 首次上电限流、测 3.3V/5V、摸 U3 温度
- ⬜ 核心板插装、下载程序
- ⬜ 实测 RGB 亮度 → **按实测 Vf/If 更换 R3/R6/R9**（0603 手换）
- ⬜ 红外灵敏度/阈值实测 → 必要时改 R13
- ⬜ 电机接线确认 → 测试启停/调速/堵转电流
- ⬜ ERC 重跑 + 网表复核

### P1：第一阶段固件（5 项，可与焊接并行）

- ⬜ 最小系统点灯
- ⬜ 三路 PWM 调光（≥4 级，**开漏输出 + PWM 取反**）
- ⬜ EXTI 中断 + 板载 LED 亮 1 秒
- ⬜ 电机 PWM 启停/调速
- ⬜ 串口指令（START/STOP/SET）
- ⬜ 五项现场演示顺序排练

### P2：第二阶段（机械 + 联调）

- ⬜ 机械装配（鼓/视窗/联轴器/遮光片/防护罩）
- ⬜ 1200±20 rpm 闭环 + 索引脉冲质量
- ⬜ 单行 → 整帧 → 8 色 → 切图 → 动画 → 失锁保护
- ⬜ 加分项按性价比：灰度 > 30 fps > PC 传图 > 分辨率扩展

---

## 4. 里程碑（更新）

| 里程碑 | 完成标准 | 状态 |
|---|---|---|
| M1 原理图冻结 | 模块齐全、ERC 通过、BOM 可采购 | 🟡 结构已完成，缺 ERC 重跑与料号 |
| M2 PCB 下单 | 板框/孔/布线/DRC/3D 检查通过 | 🟡 已摆放，未布线 |
| M3 硬件点亮 | 上电正常、可下载 | ⬜ |
| M4 第一阶段验收 | 五项实测通过 | ⬜ |
| M5 机械完成 | 装配完成、盘车均匀 | ⬜ |
| M6 稳定成像 | 1200±20 rpm、16×25、全部功能 | ⬜ |
| M7 第二阶段验收 | 规定功能 + 加分项 | ⬜ |

---

## 5. 风险与待确认（更新）

| 风险 | 说明 | 对策 |
|---|---|---|
| 机械尺寸未定 | 底座/孔位/线束长度未知 | 板框 110×90 + 4 角孔预留；不行就 3D 打印转接件 |
| 灯珠参数未知 | 共阴已按组委会口径确认，但 Vf/If 未知 | 阻值先按 180/120 估，实物到手实测再换（0603 易换） |
| 电机参数未知 | 5 线定义、PWM 电平、堵转电流 | J6 用可插拔端子；黄线不接；先不接电机通电 |
| U3 散热 | 5V 轨 0.2–0.3 A，9V 输入耗散 ≈0.8 W | 加散热片/敷铜；用 9V 适配器 |
| U2 轻载 | 3.3V 只带红外，<5 mA | 已加 R16 470Ω 假负载 |
| USB 与外部 5V | PIN_IN_+5V 与 USB 5V 之间有无二极管未实测 | 万用表实测后再决定能否同时接 |
| 板载 SPI FLASH | PA6/PA7 复用 | 已加 R15 上拉，固件不初始化 SPI1 |
| ERC 遗留 | 单网络警告、悬空引脚 | 收尾时逐条处理或加非连接标识 |

---

## 6. 两人分工（更新）

| 阶段 | 成员 A（硬件） | 成员 B（软件/机械） |
|---|---|---|
| 现在（PCB） | 画板框/孔、布线、DRC、下单 | 写第一阶段 5 项固件（可用核心板裸板调试） |
| 等板期 | 采购、准备焊接工具、核对封装 | 机械 CAD（鼓/视窗/底座适配）、固件框架 |
| 板到后 | 焊接、上电、测电压/温升 | 下载程序、联调第一阶段功能 |
| 第二阶段 | 机械装配、电气可靠性 | 扫描时序、转速闭环、显示功能 |

---

## 7. 立即要做的三件事

1. **画板框 + 4 个安装孔**（坐标见 P0），确认核心板方向
2. **补 BOM 料号**（C10 封装、U2 型号、KEY 型号）
3. 开始布线（我可以先出电源/电机的走线规则与关键网络路径建议）
