Lilffy/NIPKOW/handover/docs/A_STAGE1_TASKS.md

# A 的第一阶段任务清单（可直接当 GitHub Issue 用）

> 依据：`docs/TEAM_SPLIT.md`（分工）、`docs/refs/赛题_2026第四届.pdf`（第一阶段 5 项）、B 的 `B_PLAN_AND_GITHUB.md`（固件里程碑 M0–M4 的硬件依赖）
> 范围：**只到第一阶段验收**（第二阶段机械/成像不在这里）
> 一句话目标：**让五项功能在 10 分钟演示里稳过，且每一项都拿得出数据。**

---

## 0. 先花 3 分钟对账（否则后面全白干）

B 的文件说「PCB 已布通、DRC 0 错误、Gerber/BOM/坐标已导出」，但本工作区三个证据对不上：

| 证据 | 现状 |
|---|---|
| `TASKS.md`（19:14 写） | 「板框/安装孔/布线未做」 |
| B 的规划（20:33 写） | 「已布通、DRC 0、制造文件已导出」 |
| EDA 工程文件 | mtime 停在 18:30，SHA-256 自 19:19 起未变；`docs/export/Gerber.zip` 等**不存在** |

工程内容是加密的，我无法从文件判断有没有走线。所以 **A 的第一件事是打开 EDA 看一眼**：

- [ ] 打开 `扩展板1.eprj2` → PCB：**有走线吗？**（全板飞线还在 = 没布；飞线只剩零星 = 布完了）
- [ ] `设计 → 检查 DRC`：跑一次，看报告
- [ ] 有没有 `Gerber.zip / BOM.csv / PickAndPlace.csv` 落盘

**分支 A（确实已布通）**：跳过 §1，直接从 §2 开始 —— 等板、焊接、上电。
**分支 B（还没布）**：先做 §1，否则没有板可焊，B 的固件也永远只能在裸板上跑。

> 这一步别省。B 的计划默认板子已完成，如果实际没完成，A 会一直"等一块不存在的板"。

---

## 1. 分支 B：打板前（只有确认未完成时才做）

| # | 任务 | 判据 | 预计 |
|---|---|---|---|
| 1.1 | 导入板框/孔（`PCB_P0_PLAYBOOK.md` §2，DXF 已生成） | 尺寸 100.00×90.00，4×Ø3.2 孔位对 | 30 min |
| 1.2 | **KEY1/KEY2 封装改 C5379898**（5.8×5.8 六脚插件，赛题提供件） | 焊盘与器件手册一致 | 30 min |
| 1.3 | **U3 封装决策**：保持 SOT-223 自购 C263277 / 改 TO-220 用提供件 C498319 | 定下来就写进 CHANGELOG | 10 min（决策）|
| 1.4 | 布线：先手工布 6 条关键路径（电、电机、RGB、IR、串口），再自动布线 | 飞线清零 | 3–4 h |
| 1.5 | DRC 0 错误 | 截图存档 | 1 h |
| 1.6 | GND 铺铜 + 电源加宽 + 丝印 + Mark 点 | 见 `ROUTING.md` §3/§8 | 1 h |
| 1.7 | 导出 Gerber/BOM/坐标，下单 | 解压检查一遍 | 30 min |

---

## 2. 到货与焊接（分支 A/B 都走）

### 2.1 收货核对（30 min）

- [ ] 按 `BOM.md` §7「到货核对」逐条打勾（电阻按阻值分装、S8550 丝印 `2TY`、LM1117 两片分开）
- [ ] 板子目检：孔位、丝印、有无短路/划伤
- [ ] 缺件清单 → 立刻补单（别等焊到一半发现少一个 0603）

### 2.2 焊接顺序（**必须按这个顺序**，每步都能单独验证）

| 步 | 焊什么 | 焊完立刻做 |
|---|---|---|
| 1 | 电源入口：J1、D1、U3/U2 + 输入输出电容 | 万用表测 VIN-GND 不短路 |
| 2 | 上电测压（**不焊其它**）：限流 100 mA、9 V | 5V、3.3V 到位 → 否则停 |
| 3 | RGB 驱动：Q4–Q6 + R17–R22 + R3/R6/R9（**Q1–Q3 不焊**） | 三路空载测集电极电压 |
| 4 | 红外：R12/R13/R14、D2、J4/J5 | 遮光测 PA1 电平变化 |
| 5 | 按键、JP1、J6、J7、R15/R23 | 按键通断、串口回环 |
| 6 | 排母（双排 2×20）×2 | 目检不连锡、针脚垂直 |
| 7 | 测试点 TP1–TP9 | 逐个通断 |

> **不要一次性全焊完再上电**。分 7 步焊、7 次验证，出问题时能立刻定位到"第几步"。

---

## 3. 上电与测量（这是 B 的 M1/M2/M3 的输入，必须给数据）

### 3.1 分步上电

| 步 | 条件 | 测什么 | 通过判据 |
|---|---|---|---|
| 1 | 不插核心板，限流 100 mA，9 V | VIN、5V、3V3、GND 之间电阻 | 无短路（>1 kΩ） |
| 2 | 同上 | TP1–TP4 电压 | VIN=9.0±0.3、5.0±0.2、3.3±0.1 |
| 3 | 同上，RGB 全亮（外部给低） | 三路 LED 电流 | 每路 10–20 mA，三路接近 |
| 4 | 插核心板 | 3.3V、PB2 闪灯 | 电压不掉、能下载 |
| 5 | 接电机（**先不装鼓**） | 空载电流、启动 | 见 §3.3 |
| 6 | 满载 10 min | U3 壳温 | < 70 °C |

### 3.2 必须交出这 6 组数据（B 的固件要对着它写）

| # | 数据 | 怎么测 | 给谁用 |
|---|---|---|---|
| 1 | 三路 PWM 空载波形（含高/低电平） | 示波器，TP6/7/8 | B 的 M2（确认开漏+反相） |
| 2 | 每路 RGB 实际电流 + 亮度 | 万用表串在 J3 支路 | B 调 R3/R6/R9 的依据 |
| 3 | 红外遮光/移开两态电平 | 示波器 TP5，手动挡光 | B 的 M1（边沿方向！见 §5） |
| 4 | 索引脉冲波形（装鼓后） | 示波器 TP5，转起来 | B 的 M5/M6 |
| 5 | 电机 3 档转速时的 PWM 波形 | 示波器 TP9 | B 的 M3 |
| 6 | 满载 10 min 的 U3 壳温 | 手摸/热电偶 | 决定要不要加散热片 |

### 3.3 电机单独测（不装鼓，桌面固定）

- 先只接红/黑：看转向、听声音，**螺旋桨/鼓绝对不能装**
- 再接蓝线 PWM：3.3 V 方波先试（B 计划里的 M3 假设 3.3 V 能驱动；若不动，按 `RISKS R2` 改开漏+5 V 上拉）
- 绿线 FG：示波器看有无方波（有 = 测速可用；没有 = M5 要换方案）
- 黄线：**不接，热缩管包住**

---

## 4. 交接包（A → B，一次性给齐）

打包成一个 issue 或 `docs/TEST_LOG.md` 的 commit：

```
【板子编号】#1
【电压】VIN=__ 5V=__ 3V3=__（限流 __ mA，输入 __ V）
【RGB】R=__mA G=__mA B=__mA；三路常亮/独立调光 OK
【红外】遮光=__V 移开=__V；边沿：上升/下降
【索引】静止=__V 转动时有/无脉冲，频率≈__Hz（1200rpm 应 ≈20Hz）
【电机】3.3V PWM 能否起转：能/不能；3 档转速 __/__/__
【温升】U3 壳温 __°C（满载 10 min）
【附件】波形截图 ×__、实物照片 ×__
```

> 这 8 行填满，B 就能直接开工 M1–M4，不用来回问。

---

## 5. 三个必须先问 B 的点（我都查了原始资料，附我的判断）

| # | 冲突 | 我的核对结果 | 建议 |
|---|---|---|---|
| 1 | B 写「板载 LED PB2 **低电平点亮**」 | **反了**。核心板原理图第 2 页：「PB2(BOOT1) → LED2 → R29 2 kΩ → GND」，**高电平点亮**（PB2 另有 R30 10 kΩ 下拉） | 让 B 把 M0 的验收改成「PB2 输出高 → 灯亮」 |
| 2 | B 写「红外 PA1 EXTI1，**下降沿（遮光时高电平）**」 | 自相矛盾：遮光变高，那进入遮挡是**上升沿** | 让 B 按 A 实测波形定边沿（§3.2 第 3 项），别先写死 |
| 3 | B 写「PCB 已打样冻结，改硬件要先问 B」 | 本工作区的工程文件自 18:30 未变、无 Gerber 导出 | 先做 §0 对账；若确实未布通，**板还没打样，"冻结"不成立** |

---

## 6. GitHub：A 的 Issue 清单（照抄即可）

分支前缀统一 `feat/a-xxx`，每个 issue 做完附证据再关。

| # | Issue 标题 | Label | 验收（写进 issue） |
|---|---|---|---|
| A0 | 状态对账：PCB 是否已布通/DRC/导出 | `hw` | 三项截图存档，结论写清 |
| A1 | （若未布通）KEY/U3 封装修正 | `hw` | 焊盘尺寸与器件手册一致 |
| A2 | （若未布通）布线 + DRC 0 + Gerber | `hw` | 飞线清零，DRC 截图 |
| A3 | 物料到货核对 | `hw` `test` | BOM §7 全部打勾，缺件清单 |
| A4 | 电源部分焊接 + 上电测压 | `hw` `test` | 5V=5.0±0.2、3V3=3.3±0.1，无短路 |
| A5 | RGB 驱动焊接 + 三路电流实测 | `hw` `test` | 三路 10–20 mA，波形截图 |
| A6 | 红外电路焊接 + 两态波形 | `hw` `test` | 遮光/移开电平差 > 2 V，波形截图 |
| A7 | 排母/串口/按键/测试点完成 | `hw` `test` | 通断全对，串口回环 OK |
| A8 | 核心板插装 + 下载最小程序 | `hw` `test` | PB2 闪灯（高电平点亮） |
| A9 | 电机单独测（不装鼓） | `hw` `test` | 起转/停转/3 档，有波形或视频 |
| A10 | 满载 10 min 温升 | `test` | U3 壳温 < 70 °C，附照片 |
| A11 | 交接包（§4 那 8 行） | `test` | 数据齐全，B 确认收到 |

GitHub 操作照 B 的文件 §4.2 走即可，只有两条要记住：**不要在 main 上直接提交**（除 README）、**PR 描述写清"改了什么/怎么验证/影响范围"**。

---

## 7. 第一阶段验收当天（A 的重点是"讲得清 + 拿得出"）

- 带：万用表、示波器（若允许）、测试记录打印页、备用 0603 阻容、备用按键
- 按 `TEAM_SPLIT.md` §5 的顺序配合：B 操作，A 讲——
  1. 最小系统：电源树一句话（7.4–12 V → 5 V → 核心板 → 3.3 V）
  2. RGB：三路独立、4 级亮度，报实测电流
  3. 红外：手挡一下，报两态电平
  4. EXTI：连挡 3 次，每次亮 1 s
  5. 电机：`START/SET/STOP` 演示 3 档
- **风险预案**：红外最怕环境光，提前在房间开/关灯各试一次；串口卡住立刻切按键演示。

---

## 8. 一页 Checklist

```
□ §0 对账（EDA 里看一眼走线/DRC/导出文件）
□ 收货核对 + 缺件补单
□ 焊接 7 步，每步验证
□ 上电 6 步，数据进 TEST_LOG
□ §4 交接包 8 行填满 → 发 B
□ 三个冲突点跟 B 确认（PB2 极性最重要）
□ Issue A0–A11 逐个开、关
□ 验收前预演 2 遍（B 操作 / A 讲解）
```

---

## 9. 变更记录

| 日期 | 内容 |
|---|---|
| 2026-10-25 | 首版：按 B 的 M0–M4 硬件依赖倒推 A 的第一阶段；含状态对账、7 步焊接、6 组数据、12 个 issue、3 个冲突点 |
