Lilffy/NIPKOW/handover/docs/A_新手一周学习计划.md

# A 的一周学习计划（等板期间，2026-10-27 ~ 11-01）

> 你现在的处境：板子已下单/待下单，**物料预计 10 月 30 日（周五）发**，之后有焊台。
> 这一周不要碰正式板——用废板练手，同时把"看得懂、量得准、说得清"这三件事练出来。
> 每天 1.5–2 小时，最后一天留 1 小时做整理。

---

## 一句话目标

**板子到的那天，你能独立完成：焊完 → 限流上电 → 量出 5V/3.3V → 把数据发给 B。**
这一周练的就是这四步背后的基本功。

---

## 每天固定 20 分钟：读原理图

打印 [`schematic_扩展板原理图.pdf`](hardware/schematic_扩展板原理图.pdf)（A3 或两张 A4 拼），每天圈一块：

| 天 | 今天读哪块 | 读完要能说出 |
|---|---|---|
| 一 | 电源入口 J1 → D1 → U3/U2 | 9V 进来先经过什么，为什么要有 D1 |
| 二 | U3 周围（R10/R11/C4/C8） | 5V 是怎么算出来的（1.25×(1+360/120)） |
| 三 | RGB（Q4–Q6 + R17–R22 + R3/R6/R9） | 为什么用 PNP、为什么基极要上拉到 5V |
| 四 | 红外（R12/R13/D2/J4/J5） | 遮光时 PA1 是高还是低 |
| 五 | 电机 J6 + 按键 KEY | 五根线分别干什么、按键为什么不用外接上拉 |
| 六 | 排母 H1/H2 + TP1–TP9 | 40 脚是 5V、38 脚是 3.3V、每个测试点量什么 |
| 日 | 通读一遍 | 合上图能凭记忆画个框图 |

> 看不懂没关系，把不明白的地方记下来发给我或 B。**"看不懂"是最值得问的问题。**

---

## Day 1（周一）· 认识板子和元件：2 小时

**做什么**

1. 把 BOM 里的元件按类摆一遍（电阻/电容/二极管/三极管/连接器），每个拿起来看 10 秒
2. 学会认丝印：
   - 0603 电阻**没有丝印**，只能靠万用表量或者包装标签
   - 0603 电容也没有丝印，只能靠包装/颜色（电容一般比电阻厚一点）
   - 电解电容：**长脚是正极**，外壳有一条白边标负极
   - 二极管 SS34：**带白条的一端是负极**
   - 三极管 S8550：丝印 `2TY`（`J3Y` 是另一种管子，别混）
3. 摸一遍焊接工具：烙铁、镊子、助焊剂、吸锡带，知道各自干嘛

**验收**：随便抓 5 个元件，能说出"这是什么、怎么判断方向、怎么判断好坏"。

**搜这些视频（B站/YouTube）**
- `电子元件识别 入门 电阻 电容 二极管`
- `0603 贴片 丝印 怎么看`

---

## Day 2（周二）· 万用表：1.5 小时

**万用表是 A 最重要的工具**，比示波器还重要。练三个档位：

| 档位 | 练什么 | 判断标准 |
|---|---|---|
| **通断档（蜂鸣）** | 测一根导线两端、按一下按键 | 通 → 响；断 → 不响 |
| **直流电压档** | 量 5 号电池（≈1.5V）、USB 口（≈5V） | 读数稳定，红笔正黑笔负 |
| **二极管档** | 量一颗 LED、一颗 SS34 | 正向有读数（LED 1.8–3.4V），反向显示 `OL`/`1` |

**关键理解**：二极管档 forwards 会显示"正向压降"，这就是判断 LED 颜色和好坏的依据（红 ≈2.0V，绿蓝 ≈3.0V）。

**验收**：闭着眼拿一颗二极管，用万用表 5 秒内说出"哪头是正极、是死是活"。

**搜**：`万用表 使用 入门 二极管档 通断档`

---

## Day 3（周三）· 焊接练习：2 小时 ⭐ 最重要的一天

**别拿正式板练**。找一块废旧电路板（坏路由器、旧鼠标、坏充电器）拆元件练。

练习顺序（每一步都要练到"焊点发亮、像小火山"）：

1. **拆**：用烙铁+吸锡带把旧板上的 0603 拆下来（练手稳）
2. **焊 0603 电阻**：
   - 先在一个焊盘上点一点锡
   - 镊子夹住电阻推上去，烙铁碰一下固定
   - 再焊另一端
   - **不要两个焊盘都先上锡**，那样元件永远放不平
3. **焊 SOT-23（三极管）**：三个脚先对齐，先焊中间那只脚固定，再焊两边
4. **焊排针/排母**：先焊对角两个脚固定，检查垂直，再焊其余
5. **练拆**：用热风枪或吸锡带把焊错的元件拆下来（一定会用到）

**焊点好坏的判断**

| 好焊点 | 坏焊点 |
|---|---|
| 发亮、呈小火山状、焊锡少 | 发暗、成球、拉尖（烙铁太冷或没加助焊剂） |
| 元件贴平在板上 | 元件翘起一头（虚焊） |
| 不碰旁边焊盘 | 连锡（两个焊盘粘一起） |

**验收**：在废板上焊 10 个 0603，用万用表和目检，至少 8 个合格。

**搜**：`手焊 0603 教程`、`SOT-23 焊接 技巧`、`虚焊 假焊 判断`

---

## Day 4（周四）· 上电流程与限流电源：1.5 小时

这是**唯一会让你烧板子的环节**，必须提前理解。

**核心原理**

- 板子如果焊错（短路），直接接 9V 会瞬间大电流 → 烧器件
- **限流电源**（可调直流电源）在电流超设定值时自动降压，等于"水龙头先开小"
- 第一次上电设 **9V / 100–200mA**：电流接近 0 就正常，电流顶满就说明短路

**练什么**（没有可调电源就借实验室的）

1. 可调电源设 5V / 100mA，接一个 LED + 330Ω 电阻
2. 观察：正常时电流 ≈ (5−2)/330 ≈ 9mA
3. 故意把 LED 反接：电流接近 0（不亮）
4. 故意短路一下输出：看电流被限制在 100mA（这就是保护）

**验收**：能解释"为什么第一次上电要限流、为什么要先不插核心板"。

**搜**：`可调直流电源 限流 使用`、`第一次上电 限流 电子`

---

## Day 5（周五）· 示波器：2 小时（物料今天到）

**只需学会 5 个旋钮**：时基（横轴时间）、幅度（纵轴电压）、触发（让波形稳住）、通道选择、探头衰减（1X/10X）。

**练什么**

1. 探头接校准方波（示波器自带的 1kHz 测试点），调到稳定显示
2. 量频率：屏幕会直接显示 `1.000 kHz`
3. 量占空比：高电平时间 / 周期
4. 如果借到核心板或 Arduino：让它输出 PWM，改占空比看波形变化

**为什么要学**：B 的固件调 RGB 时，你要用示波器确认"真的输出了 PWM、占空比真的在变"。这是验收时的硬证据。

**验收**：能测一个方波，读出**频率、幅度、占空比**三个数。

**搜**：`示波器 使用 入门 触发 时基`、`示波器 测 PWM 占空比`

---

## Day 6（周六）· 读数据手册 + 元件判断：1.5 小时

不用读全，只读**首页参数表**和**引脚图**：

| 器件 | 看什么 | 和你有关的一句话 |
|---|---|---|
| **LM1117**（U2/U3） | 压差、最大电流、热阻、输出电容要求 | 压差 1.3V，输出电容要有 ESR（别只挂陶瓷） |
| **S8550**（Q4–Q6） | 引脚 E/B/C、Ic 最大 500mA | E 接 5V、C 接限流电阻、B 接 MCU |
| **SS34**（D1） | 正向压降 0.5V、反向 40V | 白条那头是负极，接板子内侧 |
| **AO3400A**（Q1–Q3） | 不用管，**DNP 不贴** | 别焊这仨 |

**练习**：拿到数据手册，5 分钟内找到"最大电流"和"引脚 1 在哪"。

**验收**：能对着 U3 说出"输入 9V、输出 5V、差 4V 会发热、所以要加散热片"。

---

## Day 7（周日）· 记录与协作：1 小时

**写测试记录模板**（照抄 `docs/A_STAGE1_TASKS.md` §4 那 8 行），存在手机备忘录里，焊完随时填。

**GitHub 三件事**（用 GitHub Desktop，图形界面，比命令行简单）

1. 打开仓库，看 **issue #20**（B 指派给你的交接包任务）和 **#18**（每日状态）
2. 学会开一个 issue（用仓库里的模板 `.github/ISSUE_TEMPLATE/agent-task.md`）
3. 学会在 issue 里贴证据（截图/读数）

> 你现在能用 git 了（仓库公开了）。要不要我帮你把交接包整理成可以直接提交的目录？说一声就行。

**验收**：在自己的仓库里开一个 issue，标题写"焊接电源区"，正文写清楚"怎么做、怎么验、要什么证据"。

---

## 这一周必须掌握的三件事（其余的都可以边做边学）

1. **焊得动、焊得对**：0603 / SOT-23 / 排母，焊点发亮不连锡
2. **量得准**：万用表三个档位（通断/电压/二极管）闭着眼会用
3. **敢上电但要限流**：理解"先 100mA 试，正常再放开"

## 现在不用学的（别浪费时间）

- ❌ 固件编程（那是 B 的事，你只要会**烧录**和**看串口**）
- ❌ 画原理图 / PCB 布线（板已经布好了）
- ❌ 复杂的电路计算（你只需要会 V=IR 和分压）
- ❌ 3D 建模（第二阶段才用，先把硬件搞熟）

---

## 这一周要准备的东西

| 东西 | 用途 | 备注 |
|---|---|---|
| 废旧电路板 2 块 | 练拆焊 | 坏路由器/鼠标/充电器 |
| 0.8mm 含松香焊锡丝 | 焊接 | 别买无铅的，新手难焊 |
| 助焊剂（针管或膏状） | 让焊点发亮 | 比焊锡更重要 |
| 吸锡带 | 拆件/清连锡 | 3mm 宽 |
| 尖头镊子 | 夹 0603 | 一定要尖 |
| 放大镜 / 手机微距 | 检查虚焊 | 10 倍够用 |
| 高温海绵/铜丝球 | 擦烙铁头 | |
| 防静电手环（可选） | 保护芯片 | 冬天干燥时有用 |

---

## 时间线提醒

| 日期 | 事 |
|---|---|
| 10/27–10/29 | Day 1–3（读图、万用表、焊接练习） |
| **10/30（周五）** | **组委会发物料**，顺便把工具带去实验室 |
| 10/31–11/01 | Day 4–7（上电流程、示波器、数据手册、记录） |
| 物料到齐后 | 按 `A_HANDOVER_NOTES.md` §4 的顺序焊接（先电源，测压，再其余） |

---

## 变更记录

| 日期 | 内容 |
|---|---|
| 2026-10-26 | 首版：按 B 的 A_HANDOVER_NOTES 与 10/30 物料时间点，排 7 天学习计划 |
