Lilffy/NIPKOW/handover/docs/A_新手行动手册.md

# A 的新手行动手册（照着做就行）

> 读者：A（负责硬件/机械，第一次做板）
> 一句话：**A 的任务是"把板子焊出来、证明它能用、把数据交给 B"**。不用写固件，不用改原理图。
> 配套：`A_STAGE1_TASKS.md`（详细版，给熟手看）；本文是通俗版。

---

## 0. 先搞清自己在干什么

整台机器是这么转的：

```
9V 电源 → 扩展板把电压变成 5V 和 3.3V → 核心板（一块现成的小电脑）跑程序
                                    ↓
        程序控制 3 个灯（红绿蓝）、1 个红外"眼睛"、1 个电机
                                    ↓
              电机转鼓，鼓上的小孔扫出图像
```

A 负责的是**中间那块扩展板**：它得能供电、能点灯、能读红外、能驱动电机。B 负责在上面那块"小电脑"里写程序。

**分工一句话**：A 造身体，B 装大脑。A 要保证"身体"健康——电压对、灯会亮、信号干净。

---

## 1. 今天就能做的三件事（不用等任何人）

### ① 先把件买了

打开 `docs/BOM_draft.csv`，每一个料号都能直接在**立创商城**下单：

1. 打开 lcsc.com（立创商城）
2. 找「BOM 配单」→ 上传这个 CSV
3. 它会自动把每行匹配到商品，你核对一下数量，下单

**买的时候注意三件事**（这几条是真金白银的坑）：

| 注意 | 为什么 |
|---|---|
| 0603 电阻电容**按 10 只起买**（BOM 里写的 1 只，是板上用量） | 0603 只有米粒的 1/4 大，焊坏一个很常见，多买几个不心疼 |
| **S8550 三极管看丝印 `2TY`** | 丝印 `J3Y` 的是 S8050（另一种管子），买错了灯永远不亮 |
| LM1117 有 **-3.3** 和 **-ADJ** 两种，长得一模一样 | 一定分开放、贴标签，混了会烧 |

顺带买：焊锡丝（0.8 mm 含松香）、助焊剂、吸锡带、镊子（尖头）、放大镜（或手机微距）、M3 铜柱和螺丝。

### ② 借/买工具

| 工具 | 用途 | 备注 |
|---|---|---|
| 可调温电烙铁（350 °C） | 焊接 | 尖头，别用大马蹄头焊 0603 |
| 万用表 | 测电压/通断 | 几十块的够用 |
| **可调限流电源** | 第一次上电 | **最重要**，学校实验室一般有，借！没它第一次上电等于赌博 |
| 示波器 | 看 PWM/红外波形 | 实验室借，只需要能看 20 kHz 以内的方波 |
| 热风枪 | 拆件/返修 | 可选，拆错了才用得上 |

### ③ 把 GitHub 弄通

让 B 在仓库 Settings → Collaborators 里加 `Layla82693`（你的账号）。

然后装 **GitHub Desktop**（图形界面，比命令行简单），登录后 clone 仓库，之后每做完一件事点一下「Commit → Push」就行。

> 为什么非要 GitHub：**两个人不能靠微信传文件**。板上改了什么、测出什么数据，都要留痕，验收时也能当证据。

---

## 2. 等 B 给你原理图之后（现在还没有）

B 还没上传**扩展板原理图 PDF**。拿到它以后，做一件事：

**把它打印出来（A3 或两张 A4 拼），拿荧光笔把每个接口圈出来，写上"这是干嘛的"：**

- J1 = 电源输入（9V 进来）
- J3 = 灯（红绿蓝 + 公共端）
- J4 = 红外发射（一个"手电筒"）
- J5 = 红外接收（一个"眼睛"）
- J6 = 电机（5 根线）
- J7 = 串口（接电脑）
- TP1~TP9 = 测试点（用万用表戳这里测电压/看波形）

这一步看着笨，但**焊的时候你会一直用这张纸**。焊错位置 90% 是因为没做这一步。

---

## 3. 板子到了以后：焊接（7 步，千万别一次焊完）

> 核心原则：**每焊完一组，就测一次**。一次全焊完再上电，坏了你不知道是哪一颗。

| 步骤 | 焊什么 | 焊完立刻做什么 | 怎么算过 |
|---|---|---|---|
| 1 | 电源入口：J1、D1（黑管子带白条）、U2、U3、几个电容 | 万用表"通断档"量 VIN 和 GND 之间 | 不能"嘀"（不短路） |
| 2 | **先别焊别的，直接上电**：9V、限流 100 mA | 量 5V 和 3.3V 两个测试点 | 5V≈5.0、3.3V≈3.3，且电流很小 |
| 3 | 三个 PNP 三极管 Q4/Q5/Q6 + 它们的电阻（1k、10k） | 装个灯或量集电极电压 | 三路电压一致 |
| 4 | 红外部分：R12、R13、R14、D2、J4、J5 | 用手挡一下红外对管，量 PA1 | 电压有明显变化（差 2V 以上） |
| 5 | 按键、JP1、J6、J7、R15、R23 | 按键按下量通断 | 按下通、松开断 |
| 6 | 两组 2×20 排母（核心板插的座子） | 目检 + 量相邻针脚 | 不连锡 |
| 7 | 测试点 TP1~TP9 | 每个都戳一下 | 通到对应网络 |

**焊接小技巧（初学者最容易犯的错）：**

- 0603 元件：**先在一个焊盘上点一点锡，用镊子把元件推上去固定，再焊另一端**。别两个焊盘都先上锡，那样元件放不平。
- 电解电容（圆柱形）：**长脚是正极**，板上有一个"+"或者半圆阴影，别装反，装反会鼓包炸。
- 二极管 D1（SS34）：**带白条的一端是负极**，板上也有白条标记，反了会短路。
- 三极管 Q4–Q6：三个脚不一样，**按板上丝印方向放**，别凭感觉。
- 每焊完一组，用手机拍一张照片存着——**以后出问题全靠它回溯**。

---

## 4. 第一次上电（最危险的一步，按这个顺序）

> 想象给一个新机器第一次通电：**先把水龙头开到最小**，看有没有漏水，再慢慢开大。限流电源就是"小水龙头"。

1. **不插核心板**、不接电机、不接灯
2. 限流电源设 9 V / 100 mA，接 J1
3. 看电流表：
   - 电流接近 0 → 正常，继续
   - 电流一下子顶到 100 mA → **立刻断电**，说明有短路，回去查焊接
4. 量 TP1（VIN）≈9 V、TP2（5V）≈5 V、TP3（3.3V）≈3.3 V
5. 摸一下 U3（那个 3 脚的稳压块）：温温的正常，烫手就断电
6. 一切正常后，**再插核心板**，此时核心板上的小灯应该会亮/闪
7. 最后才接电机，**而且绝对不装鼓、不装任何会转的东西**

**三条保命规则：**

- 电机第一次转，**手上别拿任何东西**，鼓不装，让它空转
- 任何时候板子发热、闻到怪味、听到"啪"，**先拔电再看**
- 换接线、改焊点之前，**一定先断电**

---

## 5. 测数据：给 B 的 8 行信息

B 写程序要知道板子的"脾气"，你测完把这几行发他（复制到 issue 或微信都行）：

```
板子 #1
VIN=9.0V  5V=5.0V  3V3=3.3V（限流 100mA）
RGB 电流：红 15mA 绿 13mA 蓝 13mA（或实测值）
三路 PWM：有波形 / 无波形（截图）
红外：遮光 3.3V，移开 0.2V（或实测）
索引（装鼓后）：静止 0V，转动有脉冲，频率约 20Hz
电机：3.3V PWM 能起转 / 不能；三档转速听到了变化
U3 温度：满载 10 分钟后 45°C
```

> 这 8 行填满，B 就能少问你 20 个问题。

---

## 6. 最后：验收当天

验收是**老师站在旁边看你们演示**，一共 10 分钟。分工：

- **B 操作**（点串口、按按键、挡红外）
- **A 讲解**（"这是我们自己画的扩展板，9V 进来，这里变 5V……"）

A 要能张口说出的三句话：

1. **电源**："9V 进来先过防反接二极管，再分两路：一路变 5V 给灯和核心板，一路变 3.3V 给红外。"
2. **灯**："三路三极管分别控制红绿蓝，PWM 调亮度，至少 4 档。"
3. **红外**："发射管一直亮着，挡一下接收管电压就变，单片机靠这个知道鼓转到哪了。"

**带的东西**：打印的测试记录、万用表、备用元件（0603 电阻电容各几个）、备用按键。

---

## 7. 三条纪律（比技术重要）

1. **不改设计**。板已经冻结了，你觉得哪里不对 → 开个 issue 问 B，确认了再动。自己偷偷改，B 的固件会全部对不上。
2. **每一步留证据**。照片、读数、波形截图。没有证据的"我测过了"等于没测。
3. **卡住 2 小时就喊人**。一个人对着板子发呆一整晚，是这个项目最常见的失败方式。

---

## 8. 每天花 5 分钟做的事

在 `docs/TEST_LOG.md` 里写一行：

```
2026-11-05  焊完电源区，VIN 不短路；5V=5.01V，3V3=3.29V；U3 微温。明天焊 RGB。
```

三句话就够。**这不是给老师看的，是给你自己看的**——三天后你会忘记今天为什么这么判断。
