Lilffy/NIPKOW/handover/docs/B仓库阅读报告.md

# B 的仓库读完了（2026-10-25 21:2x）

> 仓库：`Lilffy/NIPKOW`，提交 `d7cfac2`，22 个文件
> 已全部下载到 `dist/b-repo/`（本地快照，可随时对照）
> 结论速览：**设计和 BOM 是完整的、能打的**；但有 **2 个封装错误** 和 **5 处文档过期**，不修会直接卡住 A 买料/焊接。

---

## 1. 仓库里有什么

```
docs/     16 份  任务/简报/决策/网表/分区/BOM/待确认/GitHub 指南
hardware/  5 件  Gerber.zip(634KB)、BOM.csv、PickAndPlace.csv、PCBInfo.txt、BOM_draft.csv
firmware/  1 份  README.md（里程碑 M0–M7、烧录方式、5 条关键约束）
tools/     1 份  README.md（空壳）
README.md、.gitignore
```

**没有的**：扩展板原理图 PDF。A 焊接需要它，这是唯一硬缺项。

---

## 2. 哪些文件"以谁为准"（重要）

B 的文档叠了很多版本，内容互相打架。按可靠度排序，**冲突时看上面、忽略下面**：

| 优先级 | 文件 | 可信度 | 说明 |
|---|---|---|---|
| 1 | `hardware/BOM.csv`、`PickAndPlace.csv`、`PCBInfo.txt` | ⭐⭐⭐ 最高 | EDA 直接导出，是"板上真实有什么" |
| 2 | `docs/NETS.md` | ⭐⭐⭐ | 从 .esch2 重建的网表（10-24 23:47，共阴版），引脚级可信 |
| 3 | `docs/SCHEMATIC_LAYOUT.md` | ⭐⭐⭐ | 分区 + J7 定义 + 共阴说明 |
| 4 | `docs/DECISIONS.md` | ⭐⭐ | 决策流水账，**看最后几条**（前面的是被推翻的） |
| 5 | `docs/PROJECT_BRIEF.md` | ⭐⭐ 部分过期 | §4.2/§11 还是共阳旧版（48 元件） |
| 6 | `docs/QUESTIONS.md` | ⭐ 部分过期 | Q1"共阳✅"已被推翻，没更新 |
| 7 | `docs/TASKS.md` | ⭐ 部分过期 | 还写"布线未做"，但 PCBInfo 显示已布通 |
| 8 | `docs/DESIGN_PLAN.md`、`B_PLAN_AND_GITHUB.md` | ⭐ 阶段计划 | 里面的"待办"很多已经做完了 |

---

## 3. 定论：这些不用再问了

| 项 | 结论 | 依据 |
|---|---|---|
| RGB 极性 | **共阴**（+5V→PNP(S8550)→限流→灯珠→J3-4=GND） | DECISIONS 最后一条、SCHEMATIC_LAYOUT §备注、NETS.md（J3.4 在 GND 网）、DESIGN_PLAN §7.4 |
| 固件极性 | **GPIO 开漏，低电平点亮，PWM 占空比取反** | 同上 + firmware/README 约束 1 |
| 限流电阻 | R3=**180**、R6=R9=**120**（≈15.6 / 13.3 mA） | BOM.csv 第 16–17 行 |
| 5V 分压 | R10=120（OUT–ADJ）、R11=360（ADJ–GND）→ **5.0 V** | BOM + NETS「ADJ」网 |
| U3 | **TO-220**（C498319，赛题提供件） | BOM.csv 第 26 行 |
| 按键 | **5.8×5.8 六脚插件（C5379898，赛题提供件）** | BOM.csv 第 12 行 + 封装 SW-TH_6P-L5.8-W5.8 |
| 串口 | **J7 四针**（1=GND 2=PA2 3=PA3 4=3V3经R23默认不贴） | NETS「UART_TX/RX/VCC」 |
| 排针 40/38 | 40=+5V、38=+3V3（39/37=GND） | NETS「+5V_CORE」「+3V3_CORE」 |
| 电机 PWM | PB6 → J6-3；FG/AUX 预留不接 | NETS「MOTOR_PWM」 |
| 板 | 100×90、2 层、37 网络全布通、4 个 Ø3.2 非金属化孔 | PCBInfo.txt |

> 之前我提议"把 KEY 改成 6×6 贴片"是**错的**，板上本来就是 5.8 六脚封装，与赛题提供件一致。已作废。

---

## 4. A 真正要买的料（B 的 BOM.csv，26 行 / 59 件）

只列有料号的（其余阻容按位号买）：

| 位号 | 器件 | 封装 | 立创编号 |
|---|---|---|---|
| D1 | SS34 | SMA | **C7420365** |
| D2 | GL0603UG01（LED） | 0603 | **C51933293** |
| J1 | 电源端子 XY301V-A-5.0-2P | 插件 5.0mm | **C9900016950** |
| J3 | XH2.54 4P 立式 A2547WV | 插件 | **C9900216472** |
| J4/J5 | 排针 1×2 2.54 | 插件 | **C9900015265** |
| J6 | MDF7-5P-2.54（HRS） | 插件 | **C19088617** |
| J7 | 排针 1×4 2.54 | 插件 | **C32713270** |
| JP1 | 排针 1×2 2.54 | 插件 | **C9900015265** |
| KEY1/2 | 5.8 WSPT 六脚（**赛题提供**） | 插件 | **C5379898** |
| Q1–Q3 | AO3400A（**DNP 不贴**） | SOT-23 | C700953 |
| Q4–Q6 | S8550（**要贴**，共阴用这组） | SOT-23 | **C20069126** |
| TP1–9 | 测试针 RH-5000 | 插件 Ø1.4 | **C5277086** |
| U2 | LM1117-3.3 | SOT-223 | C55544533 |
| U3 | LM1117-ADJ（**赛题提供**） | TO-220 | **C498319** |
| 阻容 | 10k×7 / 180×1 / 120×3 / 360×1 / 200×1 / 1k×5 / 470×1 / 0Ω×1 | 0603 | 通用 |

> **A 请按 B 的 `hardware/BOM.csv` 下单**，不要用我之前那版 `docs/BOM.md`（料号有出入）。我已在 BOM.md 顶部加了警示。

---

## 5. 两个封装错误 + 一个缺口（必须在买料/焊接前解决）

### 5.1 ⚠️ C10 是 100 µF，却用了 0603 封装

- `BOM.csv`：C10 = **100µF，C0603**
- `PickAndPlace.csv`：C10 → footprint **C0603**
- `DESIGN_PLAN.md` §7.1 自己写的是"C10 电解封装统一按 **6.3×7.7 mm**"

**0603 根本做不出 100 µF**（最大约 10–22 µF，且耐压很低）。板上的焊盘只有 0603 大小，装不了。

这是电机电源的储能电容（NETS 里 C10 接 `VIN_PROTECTED` ↔ GND），少了它，电机一启动容易把 5V/3.3V 拉崩 → 核心板复位、索引误触发。

**处理（三选一，A 和 B 定）**：
1. 板已打样 → 在 C10 焊盘上贴 **10–22 µF/10 V 0603** 应急，另外在 J6 的电源线上**飞线并一颗 100 µF/25 V 电解**（最稳）
2. 板还没下单 → 把 C10 封装改成 6.3×7.7 电解（要重画 PCB）
3. 改用钽电容 100µF（也有 6.3×7.7 的贴片封装，但同样不是 0603）

### 5.2 ⚠️ C1/C3 是 10 µF/0603，却挂在 9–12 V 输入上

NETS 显示 `VIN_PROTECTED` 上有 C1、C3（10 µF）。0603 的 10 µF 常见耐压只有 **6.3 V / 10 V**，9 V 就在边缘，12 V 直接超。

**处理**：买 **10 µF/25 V 0805 或 1206**——焊盘 0603 放不下 0805，所以现实做法是：
- 只用 9 V 适配器（不超 10 V），买 10 µF/**16 V** 0603（少数厂家有）
- 或 C1/C3 不贴，靠 C10 电解 + C5/C7 的 100 nF 撑（容量变小，纹波变大）

### 5.3 ⚠️ 全板没有电解电容

C1–C10 全是 0603 陶瓷。LM1117 需要输出端有 **带 ESR 的电容**（电解/钽），纯陶瓷可能自激。C4（5V 输出）、C2（3.3V 输出）都是 0603 陶瓷。

**处理**：验收前用示波器看一眼 5V/3.3V 的纹波；若抖动大，在输出端并 22 µF 钽（飞线）。

---

## 6. 五处文档过期（不影响打板，但会误导人）

| # | 文件 | 写的是 | 实际 |
|---|---|---|---|
| 1 | `QUESTIONS.md` Q1 | "共阳 ✅ 已确认" | **共阴**（10-24 晚改的，没回填） |
| 2 | `PROJECT_BRIEF.md` §4.2 / §11 | 共阳低边、48 元件网表 | 共阴、59 元件 |
| 3 | `DESIGN_PLAN.md` §5 | "UART 走核心板调试口，不加连接器" | 后来加了 J7（PA2/PA3） |
| 4 | `TASKS.md` | "板框/布线未做" | PCBInfo 显示已布通、DRC 过 |
| 5 | `B_PLAN_AND_GITHUB.md` | "PB2 低电平点亮" | 核心板原理图是 **高电平点亮** |

> 第 5 条最实际：B 按"低电平"写固件，心跳灯永远不亮。

---

## 7. A 在 10 月 30 日（物料发放）之前要做什么

时间线来自 `PROJECT_BRIEF.md` §1.1：**预计 10 月 30 日（周五）发物料**，之后集中提供焊台。

| 优先级 | 事 | 说明 |
|---|---|---|
| 1 | **跟 B 定 C10 / C1C3 怎么处理** | 见 §5，定完才能下单 |
| 2 | 按 `BOM.csv` 下单剩下的料 | 阻容、排针、端子、测试针；阻容按 10 只起买 |
| 3 | 借工具 | 烙铁、**限流电源**、万用表、示波器 |
| 4 | 练焊 | 拿废旧板练 0603 和 SOT-23，**别拿正式板练手** |
| 5 | 把原理图打印出来做标注 | 等 B 上传 PDF；现在可以先按 NETS.md 的引脚表画一张"接口位置图" |
| 6 | 建 GitHub 权限 | 让 B 加 `Layla82693` 为协作者 |

---

## 8. 还是需要 B 给的（按急迫度）

1. **`hardware/schematic.pdf`** —— 焊接必备（唯一硬缺项）
2. **丝印图/装配图**（顶/底） —— 焊完对位用
3. **一句话确认**：C10 想怎么处理？C1/C3 用多少伏的？
4. 板**下单了吗**？（PCBInfo 说明已画完，但没说下单）

---

## 9. 变更记录

| 日期 | 内容 |
|---|---|
| 2026-10-25 | 首版：读完全部 22 个文件；确认共阴/TO-220/KEY 5.8；发现 C10 与 C1/C3 封装问题、5 处文档过期 |
