Lilffy/NIPKOW/handover/docs/LETTER_TO_B.md

# 给 B 的信（v2 · 已收到你的初始提交）

> 写于 2026-10-25 21:05｜作者：A 的助手
> 对应提交：`d7cfac2 init: project docs, hardware manufacturing files, firmware plan`
> 上一条消息（v1）发出去时仓库还是空的，现在不用了 —— 这版按你实际推的内容重写。

---

## 0. 先确认收货

你推的东西我全看到了：`docs/` 16 份、`hardware/` 4 件（Gerber / BOM / 坐标 / PCBInfo）、`firmware/README.md`、`tools/README.md`。

`hardware/PCBInfo.txt` 里有几个关键数字：

```
板子尺寸 3937×3543 mil（= 100×90 mm）
网络 37，未布线 0
过孔 32，非金属化孔 4（安装孔）
铺铜区域 1
```

**"未布线 0" 说明板确实布通了**，之前 `TASKS.md` 里写的"布线未做"是旧状态，我按新状态走，A 不用重新布线了。这条纠正很有用。

---

## 1. 还差 3 样，A 现在焊不了

| # | 缺什么 | 为什么急 |
|---|---|---|
| 1 | **`hardware/schematic.pdf`**（EDA 导出原理图） | 仓库里**没有**。A 手里只有核心板原理图，**没有扩展板原理图** —— 焊什么、连什么、测试点在哪，全靠这张图。这是最急的一件。 |
| 2 | **丝印图**（顶层/底层丝印 PDF 或 PNG） | 焊完要对照丝印找 J3/J4/J5/J6 和极性标记，光看 Gerber 不方便 |
| 3 | **J3 / J6 接线定义**（写进 `docs/PROJECT_BRIEF.md` 就行） | J3 四脚（哪一脚是公共端/红/绿/蓝）、J6 五线（VIN/GND/PWM/FG/黄线）—— A 要焊线，接错就废 |

---

## 2. 三个必须先定死的矛盾（不是文档问题，是贴片和固件的问题）

### 2.1 RGB 到底共阳还是共阴？**你的仓库里自相矛盾**

| 出处 | 说法 |
|---|---|
| `README.md` | 「**共阴** RGB：S8550 PNP 高边」 |
| `docs/QUESTIONS.md` Q1 | 「✅ **共阳** 8 mm 4 针，J3-4=+5V，AO3400A 低边驱动」 |
| 赛题图 3 | 也写「**共阳** · LED 灯罩固定」 |
| 原 `TASKS.md` V2.0 | 共阴（S8550 PNP），Q1–Q3 AO3400A 标 **DNP** |

这不是措辞问题，是**贴哪组器件**的问题：

| 灯珠 | 该贴 | J3-4 | 固件极性 |
|---|---|---|---|
| 共阳 | **Q1–Q3**（AO3400A 低边）+ 删掉 DNP | +5V | 输出高 = 亮 |
| 共阴 | **Q4–Q6**（S8550 PNP 高边） | GND | 开漏输出低 = 亮（占空比反相） |

贴错一组，三路全灭；固件极性也正好相反。**请在 QUESTIONS.md 里一句话定死，并把 README 里冲突的那句删掉。**

### 2.2 限流电阻到底是多少？

- `QUESTIONS.md` 疑点 3：「RGB 限流 330/270/270 Ω 对应 ≈9/6.7/6.7 mA，**偏暗**」
- 原 `TASKS.md` V2.0：「R3 = 180 Ω / R6 = R9 = 120 Ω」

按 5 V、Vf（红 2.0 / 绿蓝 3.2）估算：

| 阻值 | 电流 |
|---|---|
| 330 / 270 / 270 | 9.1 / 6.7 / 6.7 mA |
| 180 / 120 / 120 | 15.6 / 13.0 / 13.0 mA |

**板上焊的是哪组？** 这决定 A 采购哪些阻值、以及实测亮度够不够（验收要"三路可分别常亮 + 4 级调光"，太暗会看不出来）。

### 2.3 PB2 极性还是写反的

`B_PLAN_AND_GITHUB.md` 里写「板载用户 LED PB2 **低电平点亮**」。

核心板原理图第 2 页：`PB2(BOOT1) → LED2 → R29 2 kΩ → GND`（PB2 另有 R30 10 kΩ 下拉）。**高电平点亮。**

不改的话，M0 验收那条「心跳灯 1 Hz 闪」永远过不了。

---

## 3. 已经对上的，不用再讨论（省你时间）

| 项 | 结论 | 依据 |
|---|---|---|
| 排针 40 脚 = `PIN_IN_+5V`、38 脚 = `+3V3` | ✅ 正确 | 核心板原理图第 7 页矢量线条（39 = GND） |
| 板框 100×90 + 4×Ø3.2 NPTH | ✅ 与 A 的 DXF 一致 | `PCBInfo.txt` 3937×3543 mil + 非金属化孔 4 |
| **U3 = TO-220** | ✅ **好消息** | 正好能用赛题提供的 `C498319`，夹个散热片就解决 1.2 W 发热；我之前按 SOT-223 算的散热风险作废 |
| Q4（SPI FLASH / PA6-PA7 冲突） | ✅ 可以关掉 | 板上有 R15 10 kΩ 锁 CS 高，固件不初始化 SPI1 即可 |
| Q9（要不要自带用户 LED） | ✅ 建议用核心板 PB2 | 板上已有 D2 做电源指示；PB2 高电平点亮可用作中断指示 |
| Q10（UART 用哪两脚） | ✅ PA2/PA3 → J7 | 已按 USART2 布线 |

> Q4 / Q9 / Q10 是我按现有资料能替你答的，你确认一下就能从"待答"里划掉。

---

## 4. A 这边的进度

已经备好、随时可提交（817 KB zip）：

- `docs/A_STAGE1_TASKS.md` —— 焊接 7 步 / 上电 6 步 / 要交给你的 8 组数据 / 12 个 issue
- `docs/TEAM_SPLIT.md` —— 分工、4 周时间线、三张接口表
- `docs/BOM.md` + CSV —— 59 位号，立创编号已核验（**但阻值以板上实际为准，见 §2.2**）
- `docs/ROUTING.md` / `RISKS.md` / `PCB_P0_PLAYBOOK.md`
- `docs/mech/board_100x90.dxf` —— 板框+孔，可直接给底座开孔用
- `tools/*.py` —— 生成 DXF / BOM / 清单的脚本

**需要你做两件事：**

1. **Settings → Collaborators → Add people → 填 `Layla82693` → 选 Write**。
   A 这边已经登录 GitHub 并试过直接 push，返回的是：
   `remote: Permission to Lilffy/NIPKOW.git denied to Layla82693.` / `403`
   加上之后 A 就能直接把文档推上来，不用再发 zip。
2. **回一句：板子下单了吗？**
   - 没下单 → A 先用 DXF 核对板框/孔位，再一起确认下单参数（板厚/铜厚/表面处理/尺寸是否严格 <100）
   - 已下单 → A 直接进入备料 + 焊接计划

---

## 5. 一句话总结

**先给 `schematic.pdf`，再定死「共阳还是共阴」。** 这两件定了 A 明天就能开工，其余都是文档润色。

如果这周只能回一句话，就回这两件。
