Lilffy/NIPKOW/handover/docs/ROUTING.md

# 布线规则与关键网络路径（PCB P0 第 4–6 项）

> 配套：`docs/PCB_P0_PLAYBOOK.md`（板框/孔/装配）、`docs/BOM.md`（料号）
> 前提：板框 100×90，2 层，1 oz 铜，板厚 1.6 mm
> 目标：自动布线器能收尾，但电源/电机/高 di/dt 回路必须手工布

---

## 1. 线宽表（按网络类，先建类再布线）

| 网络类 | 包含网络 | 线宽 | 过孔 | 依据 |
|---|---|---|---|---|
| `MOTOR` | `VIN`（J1/J6 到 D1 前）、`MOT_PWM`、`MOT_FG` | **1.2–1.5 mm** | 0.8/1.6 ×2–3 个并联 | 电机启动/堵转电流可达 1–3 A；1 oz、1.2 mm 外层的 10 °C 载流约 3 A |
| `PWR` | `+5V`（U3 输出到 JP1、RGB、J3） | **0.8 mm** | 0.6/1.2 ×2 | 5V 轨 0.2–0.3 A，留 3 倍余量 |
| `PWR3` | `+3V3`（U2 输出到红外/指示/J7 脚4 预留） | **0.5 mm** | 0.4/0.8 | < 20 mA，但压降要小（红外发射管脉冲电流） |
| `SIG` | RGB 三路 PWM、IR、KEY、TX/RX | **0.25 mm** | 0.3/0.6 | 默认 |
| `GND` | GND | 铺铜 + 0.5 mm 以上走线补强 | 0.6/1.2 密集缝合 | 见 §3 |

> 30 mil ≈ 0.762 mm，40 mil ≈ 1.016 mm。若习惯 mil 输入：0.25=10 mil、0.5=20 mil、0.8=32 mil、1.2=47 mil。

### 1.1 载流核算（1 oz = 35 µm，外层，允许 10 °C 温升）

- 0.8 mm ≈ 1.5 A：5V 实际 0.3 A，余量 5 倍 ✔
- 1.2 mm ≈ 3 A：电机额定通常 0.5–1.5 A，堵转短时 2–3 A ✔
- 1.5 mm ≈ 4 A：给 VIN 主干（J1 → D1 → 分叉点）用 ✔
- 若压降要求更严（例如电机线 50 mm）：`R = 0.00048 Ω/□ × 50/1.2 ≈ 0.02 Ω`，2 A 时压降 40 mV，可接受。

---

## 2. 关键网络路径（手工先布这 6 条，再让自动布线跑信号）

### 2.0 网络 ↔ MCU 引脚 ↔ 排针速查

排针编号约定：`P1` = 核心板左侧 40 针（局部编号 1–40），`P2` = 右侧 40 针（局部 1–40）。
来源：`docs/refs/引脚分配.md`（**建议稿，未实物验证**，投板前按 TASKS §3 再核一遍）。

| 功能 | 网络 | MCU 引脚 | 复用 | 排针 | 备注 |
|---|---|---|---|---|---|
| RGB 红 | `PWM_R` | PA6 | TIM3_CH1 | P1-7 | 与板载 SPI FLASH 复用 → R15 锁 CS 高 |
| RGB 绿 | `PWM_G` | PA7 | TIM3_CH2 | P1-10 | 同上 |
| RGB 蓝 | `PWM_B` | PB0 | TIM3_CH3 | P1-11 | — |
| 电机 | `MOT_PWM` | PB6 | TIM4_CH1 | P2-25 | 3.3 V 输出，见 §4.2 |
| 红外索引 | `IR_INDEX` | PA1 | TIM2_CH2 | P1-4 | 输入捕获 |
| 串口 TX | `UART_TX` | PA2 | USART2_TX | P1-1 | 接 USB-TTL 的 RX（交叉） |
| 串口 RX | `UART_RX` | PA3 | USART2_RX | P1-6 | 接 USB-TTL 的 TX |
| 按键 1 | `KEY1` | PC0 | GPIO 输入 | P2-16 | 内部上拉 |
| 按键 2 | `KEY2` | PC1 | GPIO 输入 | P2-15 | 内部上拉 |
| 板载 LED | `LED_STATUS` | PB2 | GPIO 输出 | 板上 | **= BOOT1**，经 R29 2 kΩ，高电平点亮；任务 4 的指示可用它 |
| 板载按键 | — | PA0 | WKUP | 板上 | 不要再用作红外 |
| 调试 | — | PA13/PA14 | SWDIO/SWCLK | 调试口 | 不改普通 GPIO |
| USART1 | — | PA9/PA10 | — | **调试口（不在 2×20 上）** | 备用串口 |

> 关键提醒：`PA6/PA7` 同时是板载 SPI FLASH 的引脚 → **固件不得初始化 SPI1**；`PB2` 是 BOOT1，上电瞬间的电平影响启动模式，用作 LED 没问题（板上有 10 kΩ 下拉保证正常启动）。

### 2.1 主电源主干（最优先）

```
J1(VIN) ──[1.5mm]── D1(SS34) ──[1.5mm]── 分叉点
                                        ├──[1.2mm]── J6 电机 VIN（独立支路）
                                        ├──[1.2mm]── U3(LM1117-ADJ) IN + C5/C6
                                        └──[0.8mm]── U2(LM1117-3.3) IN + C7/C8
```

要点：

- **D1 紧贴 J1**：反接保护二极管要在入口 5 mm 内，别让反接电流先流过一段细线。
- **两条稳压器输入各自就近放输入电容**（U3: C5/C6；U2: C7/C8），电容地先汇到一处再进铺铜，不要各自打孔到一个"远处的 GND"。
- ⚠️ **输出电容别只挂 MLCC**：LM1117/AMS1117 靠输出电容的 ESR 做补偿，数据手册建议 22 µF 钽/电解。只挂 100 nF + 10 µF MLCC 时可能振荡（表现为输出带几十 kHz 纹波、负载跳变时掉压）。核对原理图：U3 输出有 C10（100 µF 电解）✔；**U2 输出必须有 ≥10 µF 电解/钽**，若现在只有 100 nF，下单前补一颗（见 `RISKS.md` R17）。
- **电机 VIN 支路单独走**，从分叉点直接拉到 J6，**不要穿过电源区或红外区**；这是整板最大的干扰源。
- 分叉点之后的地回流要和电流路径同宽（地也要 1.2 mm 以上，别只靠铺铜）。

### 2.2 5V 轨（U3 输出）

```
U3 OUT ──[0.8mm]── C9/C10 ──[0.8mm]── JP1(1) ──[0.8mm]── 排母 40 脚 (PIN_IN_+5V)
                     └──[0.8mm]── Q4/Q5/Q6 发射极（三路分别短支路）
```

- U3 是**线性稳压**，耗散 `(Vin − 5) × I`：
  - 输入 **9 V**、负载 0.25 A → **1.0 W**；输入 7.4 V → 0.6 W；输入 **12 V → 1.75 W**
- SOT-223 的 θJA 完全取决于铺铜：仅引脚 **120–150 °C/W**、10×10 mm 铜 ≈90、25×25 mm 双面铜 ≈60。
  - 9 V / 1.0 W 用裸焊盘：ΔT ≈ 120 °C → **不可行**
  - 25×25 mm 双面铜：ΔT ≈ 60 °C → 勉强（40 °C 环境下 Tj ≈ 100 °C）
  - 加 **15×15×10 mm 铝散热片**（θSA ≈ 20 °C/W，总 ≈ 25–30 °C/W）：ΔT ≈ 30–36 °C → **安全**
- **结论**：整机用 **9 V 适配器**（不要 12 V），5V 负载压在 0.25 A 以内；U3 焊盘下铺 ≥25×25 mm 双面铜 + ≥9 个过孔，并**装 15×15×10 铝散热片**。
- 最优解：换 **buck**（MP1584/MP2315 类，损耗 ≈0.2 W）。PCB 预留 SOT-23-6 + 电感 + 反馈电阻的兼容位置，一版覆盖两种方案。
- 另一个更省事的解法：赛题表 1 提供的可调 LDO 是 **TO-220 封装（C498319）**，TO-220 夹 15×15 散热片后 θJA ≈ 25 °C/W，1.2 W 只升温约 30 °C。若在布线前把 U3 从 SOT-223 改成 **TO-220**，R4 和 R19 一起解决（见 `RISKS.md`）。
- **C10（100 µF）放在 JP1 之前**，作为 5V 的体电荷池；RGB 三路同时点亮时的瞬态由它供。

### 2.3 RGB 三路（共阴，PNP 高边）

```
+5V ── Q4/Q5/Q6 E(发射极)
         C(集电极) ──[R3=180Ω 红 / R6=R9=120Ω 绿蓝]── J3 引脚 1/2/3
         B(基极) ── R17/R18/R19 (1k) ── MCU PWM
                 └─ R20/R21/R22 (10k) ── +5V（基极上拉，保证关断）
J3-4 = GND（共阴）
```

布线要点：

- 三路**结构对称、长度相近**（差 < 5 mm），否则三色亮度/响应会有可见差异。
- 限流电阻**靠近三极管集电极**放，不要放在 J3 侧（J3 到灯珠是外部线，长线是天线）。
- 三路的 5V 支路各自从 C10 附近单独引出，**不要串成菊花链**（菊花链会让蓝灯最暗）。
- **基极网络是"反向"逻辑**：MCU 输出低 = 点亮，高阻 = 熄灭。见 §4.1 的电平复核。

### 2.4 红外（index / 遮挡检测）

```
+5V ──[R12=200Ω]── J4-1 红外发射管 ── GND
+3V3 ──[R13=1k]── J5 接收管集电极 ── PA1（IR_INDEX）
                    └── GND（发射极）
```

- 接收管信号线**短、直、远离开关电源/电机线**；长度 > 20 mm 时在接收端并 100 pF 到地。
- 红外区的地单独汇到一处，再单点接主地（见 §3）。
- 若示波器上看到抖动：先加 100 nF 去耦，再考虑把 R13 降到 470 Ω（提高驱动、降低上升沿时间），最后才加施密特（74LVC1G17）。

### 2.5 电机接口

```
J6-1 VIN ──[1.2mm] 独立支路
J6-2 GND ──[1.2mm]
J6-3 PWM ← PB6/TIM4_CH1 ──[0.25mm] 串 100Ω（可选，抑制振铃）
J6-4 FG  → 上拉 4.7k 到 +3V3 ──[0.25mm] → 定时器输入捕获
J6-5 AUX → 不接（丝印标 NC）
```

- **FG 是开集输出**：必须上拉，且不要直接进 5V；上拉到 3.3 V。
- 电机 PWM 走线**不要与 IR 信号并行走超过 10 mm**；平行段之间保持 ≥ 3 倍线宽间距（≥ 0.75 mm）。
- J6 端子下方（板边）留 ≥ 3 mm 净空，方便插拔。

### 2.6 串口 J7

```
J7-1 GND
J7-2 TX(PA2) ──[0.25mm]，串联 33Ω（可选，抑制过冲）
J7-3 RX(PA3) ──[0.25mm]
J7-4 经 R23(0Ω,默认不贴) → +3V3
```

- TX/RX 尽量等长、避开电机区；R23 只贴 0Ω，**默认不贴**（防止外部 3V3 反灌）。
- 丝印注明 `1:GND 2:TX 3:RX 4:3V3(DNP)`，否则队友一定插反。

---

## 3. 地平面策略

### 3.1 分层

- **底层（Bottom）整片 GND 铺铜**，不切割；所有器件地优先打孔到底层（每个 GND 焊盘至少 1 个 0.3/0.6 过孔，电源焊盘 2 个 0.6/1.2）。
- **顶层（Top）铺 GND 补铜**，但允许被走线切碎；碎片之间用缝合孔连起来（间距 ≤ 5 mm）。

### 3.2 单点汇接（功率地 / 信号地）

```
        电机地(J6-2) ──┐
       U3 输入电容地 ──┼── 汇接点(靠近 J1/D1 的 GND 焊盘) ── 底层 GND 铺铜
         U2 地 / 数字地 ┘
```

- 汇接点选在 **J1 的 GND 引脚正下方**（电源入口），只有这一处"总闸"。
- 电机地**不要**从板中间直接打孔到底层；先走 1.2 mm 到汇接点，再下到底层。
- 红外区（J4/J5/R12/R13）的地：先局部连成一小块，再用 1 个过孔下底层，避免电机回流电流从红外地线上过。

### 3.3 反面例子（会翻车的做法）

- ❌ 铺铜被 5V/电机线切成两半，中间没有缝合 → 地回流绕远，IR 信号抖。
- ❌ 每个 GND 焊盘单独打孔但孔距 > 10 mm → 高频回流路径长。
- ❌ 安装孔用金属化（PTH）→ 螺钉把 GND 直接短到机壳/电机地，噪声灌进板子。

---

## 4. 布线前必须做的 4 项电气复核

这几条不是布线规则，但**决定布线能不能收敛**，建议在开自动布线前先确认。它们都源自当前原理图的实际接法，改一处只需动一个电阻。

### 4.1 RGB 基极驱动电平和 5V 兼容性 ⚠️

现状：`+5V — 10k — 基极 — 1k — MCU_PWM`，PNP 高边。

| 状态 | MCU 配置 | 基极电压 | 结果 |
|---|---|---|---|
| 点亮 | **开漏输出低**（0 V） | ≈ 4.3 V（Veb 钳位） | Ib ≈ 4.3 mA，Ic 15 mA → 强制 β≈3.5，深度饱和 ✔ |
| 熄灭 | **开漏高阻** | 被 10k 拉到 5 V | Veb=0，可靠关断 ✔ |
| ❌ 熄灭 | 推挽输出高（3.3 V） | Veb≈1.5 V | **会误导通**，且 1 mA 倒灌进 MCU 引脚 ✘ |

结论与动作：

1. 固件里三路 PWM **必须配置为开漏（Open-Drain）**，且亮度 = 反相占空比（`CCR = 100% - 亮度`）。
2. 关断时引脚被 10k 上拉到 **5 V**，所以这三个 GPIO **必须是 5V 兼容（FT）引脚**。本方案三路分别是 **PA6（TIM3_CH1）/ PA7（TIM3_CH2）/ PB0（TIM3_CH3）**（见 `docs/refs/引脚分配.md`）；F407 的 GPIO 绝大多数在数据手册 Table 7 标注 `FT`，这三个脚属常规 GPIO/定时器复用脚，**下单前扫一眼确认即可**。
3. 若其中有非 FT 引脚：把该路 10k 上拉改接到 **+3V3**，或在该路基极串一只 1N4148（阳极朝 MCU）把引脚钳在 3.3 V+0.7 V 以内——**两种改法都只动一个元件**，现在改比打板后飞线便宜。

> 这条已经写进 `docs/RISKS.md`，请在下单前定稿。

### 4.2 电机 PWM 电平

3720 内置驱动无刷电机的 PWM 输入通常是 **5 V 逻辑**（部分型号 3.3 V 兼容）。PB6 只有 3.3 V：

- 先实测：给电机单独供电，PWM 用 3.3 V 方波，看能否起转、转速是否随占空比线性。
- 若不响应：J6-3 侧改为 **开漏 + 4.7k 上拉到 5V**（PB6 支持开漏），或串 1k 接一只 2N7002 做电平转换。PCB 上**预留这三个焊盘**（1k、4.7k、SOT-23 位置），比改板快。

### 4.3 JP1 与 USB 5V 冲突

- 核心板 `PIN_IN_+5V` 与 USB 的 5V 之间是否有二极管/理想二极管，**没实测过**。
- 动作：万用表二极管档，量核心板 USB 5V 与 PIN_IN_+5V 之间正反向压降。
  - 有二极管（正反向压降不同）：可同时接，JP1 常闭。
  - 直通（0 Ω）：**USB 供电时必须拔 JP1**，否则电脑 USB 口被反灌。丝印加 `USB 时拔 JP1`。

### 4.4 U3 散热

见 §2.2。最低要求：敷铜 + 散热过孔 + 预留散热片；实测温升 > 80 °C 就换 buck 方案。

---

## 5. 自动布线的使用姿势

1. **先手工布完** §2 的 6 条关键路径（电源、电机、RGB 三路、IR、串口），并锁定（`编辑 → 锁定`）。
2. 给 `SIG` 类跑自动布线（`布线 → 自动布线`），参数：双层、允许过孔、优先水平/垂直。
3. 自动布线**必然**会留残留飞线：`视图 → 飞线` 打开，按"短飞线优先"逐条补。
4. 补完再重铺一次铜（顺序很重要）。
5. 最后统一加宽被自动布线改细的电源线，并补缝合孔。

> 经验值：59 器件的双层板，自动布线通常能完成 90–95% 的网络；剩下 5% 是电源/地/短接，正好是应该手工布的部分。

---

## 6. DRC 规则（下单前 0 错误）

| 规则 | 值 | 说明 |
|---|---|---|
| 最小线宽 | 0.2 mm | 实际最小 0.25 |
| 最小间距 | 0.2 mm | 沉金工艺 6 mil 可做 |
| 孔到铜 | 0.3 mm | 安装孔另按禁布环 6.0 |
| 过孔 | 0.3/0.6（信号）、0.6/1.2（电源） | — |
| 板边距 | 0.3 mm | 除安装孔外，铜箔离板边 ≥ 0.3 |
| 孔径公差 | ±0.05 | 立创标准 |
| 丝印压焊盘 | 禁止 | DRC 会报，逐个挪 |
| 未连接引脚 | 逐条确认 | 悬空脚加"非连接标识"，别留警告堆积 |

---

## 7. 变更记录

| 日期 | 内容 |
|---|---|
| 2026-10-25 | 首版：线宽表、6 条关键路径、地策略、4 项电气复核（RGB 开漏/5V 兼容、电机 PWM 电平、JP1/USB、U3 散热） |
