Lilffy/NIPKOW/handover/docs/打板下单.md

# 打板下单包（NIPKOW 扩展板）

> ## ✅ 版本确认（2026-10-26 16:40 拉取最新仓库核对）
>
> B 在 10-25 23:52 之后推了 10 个提交，**但 Gerber 没有变**：
> - 远端 `hardware/Gerber.zip` 的 git 对象哈希 = `e12ddb68…`，与本文件包的完全一致
> - B 自己在 `docs/A_HANDOVER_NOTES.md` §2 写明：「铜箔**没有改动**，Gerber 不变」
> - 唯一改动是 **C10 从 100 µF 改成 10 µF/25 V**（封装仍是 0603），100 µF 改为**外接电解**
>
> **结论：你手上这份 zip 就是最新的，可以直接下单，不需要重新导出。**
>
> 新增（本次才有的）：`hardware/schematic.pdf` 扩展板原理图 → 已复制为
> [`docs/hardware/schematic_扩展板原理图.pdf`](schematic_扩展板原理图.pdf)

> 来源：B 的仓库 `Lilffy/NIPKOW`，提交 `d7cfac2`（2026-10-25 20:36 推送）
> 制造文件生成时间：**2026-10-25 04:56**（EDA 导出）
> 已解压核验：见 §2

---

## 1. 先说清楚：打板需要的是 Gerber，不是原理图

| 你以为要的 | 实际打板要的 |
|---|---|
| 原理图（.sch / PDF） | ❌ 打板厂不看原理图 |
| **Gerber 制造文件** | ✅ 就是它 —— 已放在 `docs/hardware/NIPKOW_Gerber.zip` |
| 钻孔文件 | ✅ 已包含在 zip 里（Drill_*.DRL） |

**仓库里没有原理图 PDF**（B 只推了 Gerber + BOM + 坐标 + 文档）。如果你要看电路，得让 B 从嘉立创 EDA 里「导出 → PDF」补一份；但**打板不需要它**。

---

## 2. 我替你核过了（不用自己再解压数）

| 项 | 实测值 | 怎么来的 |
|---|---|---|
| 板框尺寸 | **100.00 × 89.99 mm** | 解析 `Gerber_BoardOutlineLayer.GKO` 四个角坐标 |
| 层 | 2 层铜（顶/底）+ 丝印 + 阻焊 + 锡膏 | zip 内有 GTL/GBL/GTO/GBS/GTS/GTP |
| 最小线宽 | 顶层 **0.254 mm（10 mil）**、底层 0.203 mm（8 mil） | 逐层解析光圈最小值 |
| 最小钻孔 | **0.3 mm**（32 个过孔） | 解析 Drill_PTH_Through_Via.DRL |
| 插件孔 | 157 个：0.3×32、0.8×12、0.85×5、1.09×4、1.1×84、1.2×20 | 解析 Drill_PTH_Through.DRL |
| 非金属化孔 | **8 个**：Ø3.2 ×4（M3 安装孔）+ 1.70 / 4.52 / 5.71 / 5.82 各 1（连接器定位柱） | 解析 Drill_NPTH_Through.DRL |
| 器件 | 59 个（全在顶层） | PCBInfo.txt |
| 网络 | 37 个，未布线 **0** | PCBInfo.txt |
| 过孔 | 32 个 | PCBInfo.txt |

> 四个 Ø3.2 是安装孔，位置在四角、距板边 5.08 mm，和 `docs/mech/board_100x90.dxf` 一致 ✅

预览图（我按 Gerber 实时渲染的）：`docs/hardware/gerber_preview.png`
红=顶层铜、蓝=底层铜、灰=丝印、绿=板框、黄=钻孔。

---

## 3. 下单参数（嘉立创，照抄）

| 项目 | 选这个 | 说明 |
|---|---|---|
| 板子尺寸 | **100 × 90 mm** | 上传后系统会自动识别，核对一眼即可 |
| 层数 | **2 层** | |
| 板厚 | **1.6 mm** | 标准 |
| 铜厚 | **1 oz** | 5V 0.3 A、电机 2 A 级够用 |
| 最小线宽/间距 | **6/6 mil** | 实际是 8/8 mil，报 6/6 更保险 |
| 最小孔径 | **0.3 mm** | 和过孔一致 |
| 阻焊颜色 | 绿色（随便） | |
| 丝印颜色 | 白色 | |
| 表面处理 | **沉金 ENIG**（预算紧就喷锡 HASL） | 0603 + 0.2 mm 间距，沉金好焊 |
| 过孔盖油 | 盖油（Tented） | 除非要测 |
| 测试架/飞针 | 不需要 | |
| SMT 贴片 | **不要选** | 你们自己手焊；BOM 里的料号也不全适合 SMT |
| 拼板 | 单板 | 除非要多块 |

---

## 4. 上传步骤

1. 打开嘉立创下单页 → **PCB 下单** → 上传 Gerber
2. 拖进 `docs/hardware/NIPKOW_Gerber.zip`（不用解压）
3. 等它解析完，核对：尺寸 100×90、2 层、板厚 1.6、孔径 0.3
4. 按 §3 选参数 → 选数量（首次建议 **5 片**，单价更低且留返工余量）
5. **付款前**做 §5 的 5 项检查

> zip 里有 4 个 `Fabrication_Colorful*.FCB*` 文件——那是"彩色丝印"工艺的附属文件，普通打板**不用管**，系统会忽略；只认 `Gerber_*` 和 `Drill_*`。

---

## 5. 付款前一定要看的 5 条

| # | 检查 | 不通过会怎样 |
|---|---|---|
| 1 | 尺寸显示 **100 × 90**（不是 1000×900，也不是 3.9 m） | 单位错 → 天价或报废 |
| 2 | 层数是 **2** | 多算层数多花钱 |
| 3 | 钻孔列表里有 **Ø3.2 ×4** | 没有孔 = 装不上铜柱 |
| 4 | 预览图里四角有孔、中间有两排 40 针焊盘 | 层错位/漏层 |
| 5 | 板厚 1.6、铜厚 1 oz、最小孔 0.3 | 参数不匹配会被工程审核打回 |

---

## 6. 打板前最后一个决策（30 秒，但影响能不能焊）

上次读 BOM 时发现 **C10 是 100 µF 但封装画成了 0603**（`PickAndPlace.csv` 证实），而 0603 做不出 100 µF。

- **如果这块板还没下单**：现在改 C10 封装（改 6.3×7.7 电解）还来得及，改完要重新导出 Gerber
- **如果决定就这么打**：C10 位置贴 22 µF/10 V 0603 应急，另在 J6 电源线上飞线并一颗 100 µF/25 V 电解（不影响使用，但难看，验收时说明是"补的储能电容"）

C1/C3（10 µF/0603 挂在 9–12 V 上）同理：只买 10 µF/**16 V 以上** 的 0603，或者干脆不贴、靠 C10。

> 这两条只影响**元件的选择和焊接**，不影响 Gerber 能不能打——所以你可以先打板，元件到手前把这两个决定定下来。

---

## 7. 一个提醒：仓库现在匿名访问不了

今天（10-26）我再去拉 `github.com/Lilffy/NIPKOW` 时返回 **404**——大概率是 B 按我上次的建议把它设成了 **Private**（也可能是改名/删除）。

所以：

- 你手里这份 Gerber 是 **10-25 20:36（d7cfac2）** 的快照，我已在本地留档
- 如果 B 昨晚之后又改过板，**以他那边重新导出的 Gerber 为准**
- 让 B 确认一句："Gerber 是 10-25 04:56 那版吗？之后有没有再改？"

---

## 8. 文件清单（给你的）

| 文件 | 用途 |
|---|---|
| `docs/hardware/NIPKOW_Gerber.zip` | **上传给嘉立创的就是它**（634 KB，16 个文件） |
| `docs/hardware/gerber/` | 解压后的原始文件（想自己看某层用） |
| `docs/hardware/gerber_preview.png` | 我渲染的预览图，付款前先看一眼 |
| `docs/mech/board_100x90.dxf` | 板框+安装孔，做底座/打孔定位用 |
| `docs/BOM.md` / B 的 `hardware/BOM.csv` | 买元件（以 B 的 CSV 为准） |

---

## 9. 变更记录

| 日期 | 内容 |
|---|---|
| 2026-10-26 | 首次核验 Gerber：尺寸 100×89.99、2 层、最小线宽 8 mil、最小孔 0.3、NPTH 8 个；给出下单参数与付款前检查 |
