Lilffy/NIPKOW/tools/README.md

# 工具

- 上位机脚本（Python）：串口发图、图案生成
- 测试脚本：串口协议自测
