Lilffy/NIPKOW/handover/docs/img/gerber_preview.png

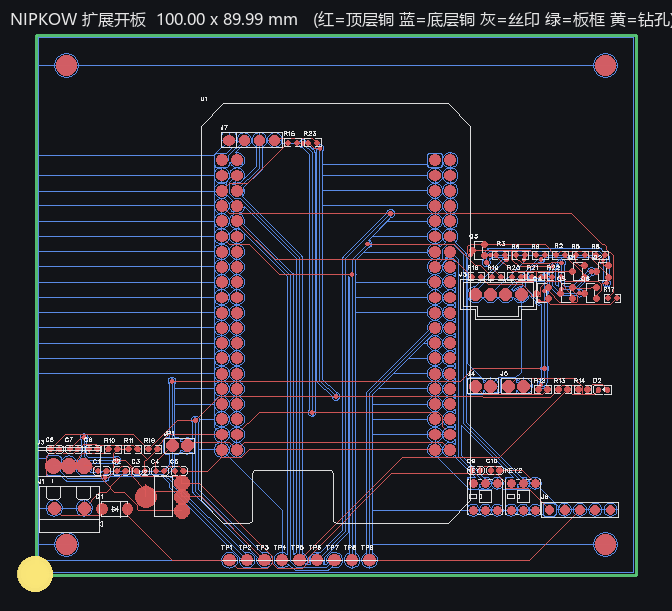
handover/docs/img/gerber_preview.png
