Lilffy/NIPKOW/hardware/silk_bottom.png

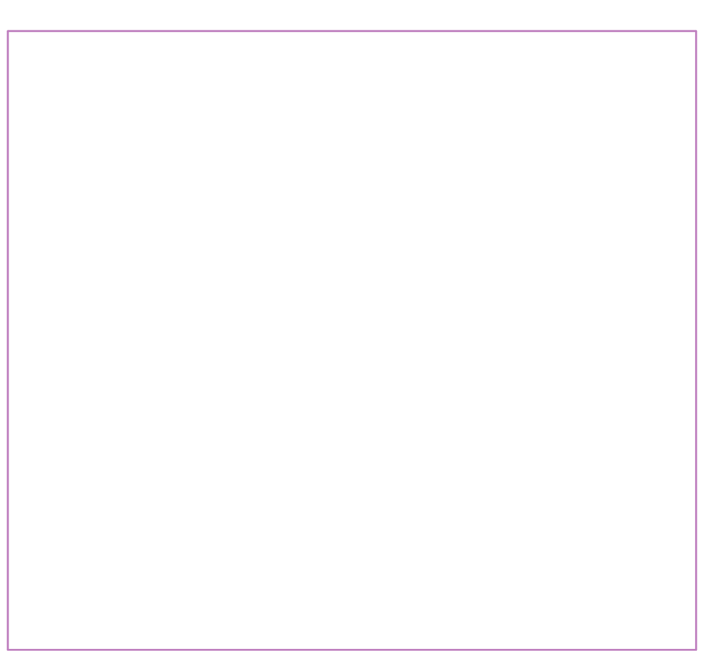
hardware/silk_bottom.png
