Lilffy/NIPKOW/hardware/silk_top.png

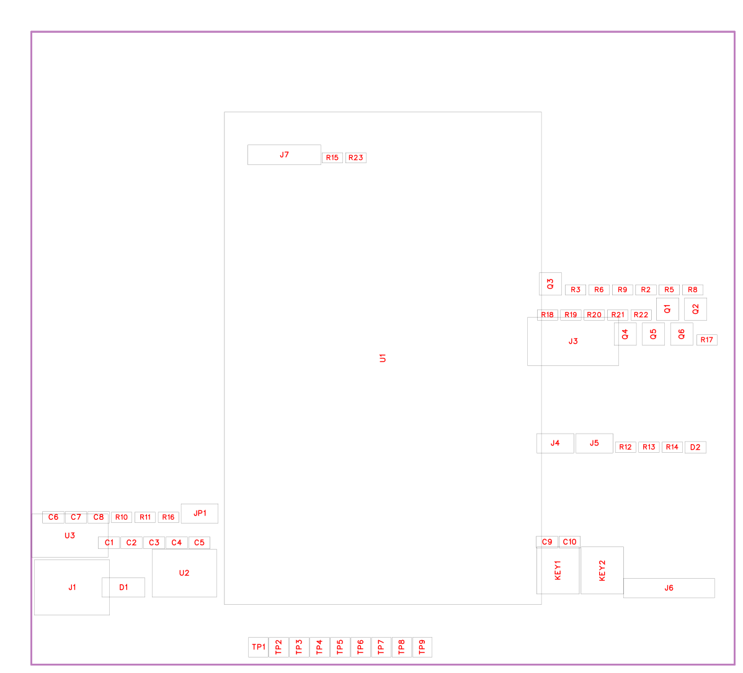
hardware/silk_top.png
