Lilffy/NIPKOW/docs/PARTS_IDEAL_VS_OK.md

# 到货核对清单 + 元件"理想件 / 凑活能用"对照

> 2026-10-30。**今天只核对、不焊接。** 焊接等 R10/R11 与 U2 确认后再动。
> 用法：左列逐项打勾；右列告诉你"没有理想件时什么能顶"。

## 一、板子到货核对（不焊，10 分钟）

| # | 检查项 | 方法 | 判据 | 勾 |
|---|---|---|---|---|
| 1 | 板数/外观 | 目视 | 无划伤、断线、阻焊起泡、露铜 | ☐ |
| 2 | 外形尺寸 | 卡尺 | 100 × 90 mm | ☐ |
| 3 | 安装孔 | 卡尺 | 4 × Ø3.2 mm | ☐ |
| 4 | **两排母内侧行距** | 卡尺 | **33.02 mm**（中心距 35.56） | ☐ |
| 5 | 排母孔数 | 数 | 2 × 20 孔，共 80 | ☐ |
| 6 | 丝印 | 目视 | J1/J3/J4/J5/J6/J7、TP1–TP9、U2/U3、Q4–Q6 可读 | ☐ |
| 7 | 极性标记 | 目视 | D1 阴极带、D2 方向、U2 pin1、U3 缺口 | ☐ |
| 8 | 过孔/镀层 | 目视 | 无堵孔、无氧化 | ☐ |
| 9 | 阻焊开窗 | 目视 | 焊盘齐全，J1 大焊盘、TP 开窗正常 | ☐ |

## 二、元件数量核对（对照 BOM）

| 位号 | 值 | 数量 | 你手上有 | 勾 |
|---|---|---|---|---|
| C1,C2,C3,C4 | 10µF（C1/C3 建议 25V） | 4 | | ☐ |
| C5–C9 | 100nF | 5 | | ☐ |
| C10 | 10µF/25V | 1 | | ☐ |
| D1 | SS34 | 1 | | ☐ |
| D2 | 0603 红/绿 LED | 1 | | ☐ |
| J1 | XY301V-5.0-2P | 1 | | ☐ |
| J3 | A2547WV-4P | 1 | | ☐ |
| J4,J5 | 2P 2.54 排针 | 2 | | ☐ |
| J6 | MDF7-5P-2.54 | 1 | | ☐ |
| J7 | 4P 2.54 排针 | 1 | | ☐ |
| JP1 | 2P 排针 + 跳线帽 | 2 件 | | ☐ |
| KEY1,KEY2 | 5.8×5.8 六脚 | 2 | | ☐ |
| Q4–Q6 | S8550 SOT-23 | 3 | | ☐ |
| R3 | 180Ω | 1 | | ☐ |
| R6,R9 | 120Ω | 2 | | ☐ |
| **R10** | **360Ω（对调后）** | 1 | | ☐ |
| **R11** | **120Ω（对调后）** | 1 | | ☐ |
| R12 | 220Ω（200 也行） | 1 | | ☐ |
| R13,R14,R17–R19 | 1kΩ | 5 | | ☐ |
| R15,R20–R22 | 10kΩ | 4 | | ☐ |
| R16 | 470Ω | 1 | | ☐ |
| R23 | 0Ω（不贴） | 1 | | ☐ |
| U2 | 固定 3.3V SOT-223 | 1 | | ☐ |
| U3 | LM1117T-ADJ TO-220 | 1 | | ☐ |
| TP1–TP9 | RH-5000 或 排针 | 9 | | ☐ |
| H1,H2 | 2×20 排母 | 2 | | ☐ |
| C-EXT | 100µF/25V 电解 | 1 | | ☐ |
| 散热片 | 10×10×8 或 15×15×10 | 1 | | ☐ |
| 绝缘垫片/绝缘粒 | TO-220 用 | 1 套 | | ☐ |
| 导热硅脂 | — | 1 | | ☐ |

## 三、理想件 / 凑活能用

### 电容

| 位置 | 理想 | 凑活能用 | 不能用的 |
|---|---|---|---|
| **C1、C3**（9V 输入） | 10µF/**25V** 0603 X5R | 10µF/**16V** 0603（**只用 9V，禁 12V**） | 10V 及以下；0805/1206 焊盘放不下 |
| **C10**（9V 输入） | 10µF/**25V** 0603 | 10µF/16V 0603 | 100µF 0603（贴不了） |
| C4、C8（5V） | 10µF/16V + 100nF/50V | 10µF/10V（余量小）；100nF/25V | — |
| C2、C6（3.3V） | 10µF/16V + 100nF/50V | 10µF/10V；100nF/25V | — |
| C5–C9（通用） | 100nF/50V X7R | 100nF/25V（C5/C7 在 9V 上，≥16V） | 16V 以下用在 VIN 上 |
| C-EXT（外接） | 100µF/**25V** 电解 6.3mm | 100µF/16V（9V 下可用）；220µF/16V 也行 | 耐压 <16V 且上 12V |

### 电阻（0603，1% 最好，5% 也能用）

| 位置 | 理想 | 凑活能用 | 说明 |
|---|---|---|---|
| **R10 / R11** | **R10=360Ω、R11=120Ω** | 同值 5% 也行 | 决定 5V 输出，误差 <5% 可接受 |
| R3（红） | 180Ω | 150Ω / 200Ω | 亮度略有差异 |
| R6/R9（绿蓝） | 120Ω | 100Ω / 150Ω | 别低于 100Ω |
| R12（红外） | 220Ω | **200Ω（你已有）** | 200Ω 时 If≈18.5mA，别再小 |
| R13（红外上拉） | 1kΩ | 2.2kΩ（更灵敏）/ 470Ω（更强） | 2.2k 弱光更好 |
| R14（指示 LED） | 1kΩ | 470Ω–2kΩ | — |
| R17–R19（PNP 基极） | 1kΩ | 470Ω–2.2kΩ | 470Ω 更饱和，2.2k 也行 |
| R15/R20–R22 | 10kΩ | 4.7kΩ–22kΩ | 上拉/下拉 |
| R16 | 470Ω | 330Ω–1kΩ | 3.3V 假负载 |

### 芯片/器件

| 位置 | 理想 | 凑活能用 | 不能用的 |
|---|---|---|---|
| **U3**（5V） | LM1117T-ADJ（C498319，组委会发） | LM317T（引脚兼容，压差更大但 9V 够；同 1.25V 基准） | 固定 5V 的 LM1117-5.0 也能用（ADJ 脚接地） |
| **U2**（3.3V） | 固定 3.3V SOT-223（AMS1117-3.3 / LM1117-3.3） | 外部 3.3V 模块飞线到 TP3/C2（撤掉 U2） | **LM1117-ADJ 直接焊（没分压 → 1.25V）** |
| D1 | SS34 SMA | SS34 其他封装（改焊盘难度大）；1N5819 SMA | 普通 1N4148（电流不够） |
| D2 | 0603 红/绿 LED | 任意 0603 LED | — |
| Q4–Q6 | S8550 SOT-23 | SS8550 / 2N5401（SOT-23） | NPN（如 S8050） |
| KEY1/2 | 5.8×5.8 六脚（提供） | 4 脚轻触（脚位不同，需飞线） | — |

### 电源 / 工具 / 连接

| 项 | 理想 | 凑活能用 | 备注 |
|---|---|---|---|
| 电源 | 9V/**2A** 稳压适配器 + 鳄鱼夹 | 9V/1A（电机另供）；实验室可调电源（9V 限流 300mA） | **禁 12V** |
| USB-TTL | CH340/CP2102，**3.3V 电平** | FT232、PL2303（3.3V 档） | 5V 电平别用 |
| ST-Link | ST-Link V2（克隆也行） | DAPLink / J-Link（需配置） | — |
| J3 插头 | XH2.54 4P 母壳 + 端子 | **直接把线焊在 J3 引脚上** | 灯珠裸线时 |
| J6 线束 | MDF7-5P 母壳/压线 | 杜邦线插针 / 直接焊线 | 电机峰值大时电源别走 J6 |
| 测试点 | RH-5000 测试针 | 直接焊 1P 排针 / 留锡点 | — |
| 散热片 | 10×10×8 TO-220 | 15×15×10 立式 / 自制铝片 | 必须绝缘 |
| 绝缘 | 硅胶垫 0.5mm + 尼龙螺丝 | 云母片+硅脂 / 散热片悬空 | 背板是 5V |
| 万用表 | 必备 | — | 没有就别上电 |
| 示波器 | 可选 | — | 测 PWM/纹波 |

## 四、今天不要做

- ❌ 不要开始焊接（等 R10/R11 对调方案与 U2 型号确认）
- ❌ 不要上电（先做静态短路检查）
- ✅ 只做：开箱核对、元件清点、万用表测电阻值（R10/R11 分别确认 120/360 各一颗）

## 五、2026-10-30 补件到货（已下单截图）

| 补件 | 型号 | 规格 | 数量 | 对应位号 | 结论 |
|---|---|---|---|---|---|
| 100nF 0603 | FCC0603B104K500CT（富捷） | 100nF ±10% **50V** | 100 | C5–C9 | ✅ 理想件（50V 在 9V 输入也够） |
| 100µF 电解 | RD1E107M6L011PC340（三和） | 100µF ±20% **25V** 插件 | 10 | C-EXT 外接 | ✅ 理想件（25V，9V 下更稳） |
| 10µF 0603 | HGC0603R5106M250NTHJ（华瓷） | 10µF ±20% **25V** | 20 | C1/C3/C10（也可用于 C2/C4/C6/C8） | ✅ 理想件，**25V 解决耐压问题** |
| 220Ω 0603 | 0603WAJ0221T5E（厚声） | 220Ω ±5% | 100 | R12 | ✅ 理想件（If≈16.8mA，留余量） |
| 2.2kΩ 0603 | RCA032K2FLF（HKR） | 2.2kΩ ±1% | 100 | R13 备用 | ✅ 好件（弱光时换 R13；也可顶 R14/R17–R19） |

### 补件后状态

- **C1/C3/C4/C8/C2/C6**：全部用 10µF/25V 0603 → 耐压问题彻底解决（仍建议只用 9V，但 12V 也不再有电容耐压风险）
- **C10**：用 10µF/25V 0603 ✅
- **C-EXT**：100µF/25V 插件，可外接在 J1 或 J6 电源端 ✅
- **R12**：直接用 220Ω ✅（200Ω 已不需要）
- **R13**：1k 为主，另备 2.2k ✅

### 仍缺（到货前补/确认）

| 项 | 状态 | 备注 |
|---|---|---|
| U3 散热片（10×10×8 或 15×15×10） | ❓ 未确认 | U3 在 9V/0.8W 下需要 |
| TO-220 绝缘垫片 + 绝缘粒 | ❓ 未确认 | 背板是 5V 电位 |
| 导热硅脂 | ❓ 未确认 | — |
| 9V 电源适配器 + 鳄鱼夹 | ❓ 未确认 | 2A 最佳，1A 可用 |
| USB-TTL（CH340/CP2102，3.3V） | ❓ 未确认 | 串口调试必需 |
| ST-Link | ❓ 未确认 | 下载必需 |
| J6 电机线束 / J3 XH 4P 母壳 | ❓ 未确认 | 不匹配可焊线 |

### R10/R11 对调所需电阻（用现有料，不用买）

- R10 位置用 **360Ω**（原 R11 那颗）
- R11 位置用 **120Ω**（原 R6/R9/R10 三颗里的一颗）
- 结果：`1.25×(1+360/120)=5.00V` ✅

## 六、2026-10-30 晚 到货/在手状态

| 项 | 状态 | 备注 |
|---|---|---|
| 散热片 | ✅ 到 | U3 焊好后再装（配绝缘垫片/硅脂，确认是否也到了） |
| USB-TTL | ✅ 到 | CH340 类，接 J7：TX→J7-3、RX→J7-2、GND→J7-1、VCC 不接 |
| ST-Link | ✅ 有（2×5 排针） | 需确认引脚定义；只接 GND/SWDIO(PA13)/SWCLK(PA14)，**不要接 5V** |
| 电机 | ✅ 到（红/黑/蓝 三线） | 红→J6-1(VIN)、黑→J6-2(GND)、蓝→J6-3(PWM/PB6)；**无 FG**，M5 用红外索引测速 |
| 鳄鱼夹 | ❌ 未到 | 临时用实验室可调电源（9V 限流 300mA）或香蕉头转夹线 |
