Lilffy/NIPKOW/docs/PURCHASE_CHECK.md

# 采购核对表（V1 板上真实器件 + 已知修正）

> 2026-10-27 由 `hardware/BOM.csv`（EDA 导出，59 件/26 行）生成。
> ⚠️ 采购以本表为准；**A 之前用的 10-25 快照 BOM 已过期**（C10 已改）。
> ⚠️ A 自查报告的 §5.1/§5.2 指出：C10 100µF/0603、C1/C3 耐压不足 —— 本表已修正。

## 关键修正项（必须按这里买）

| # | 位号 | 正确规格 | 说明 |
|---|---|---|---|
| 1 | **C10** | **10 µF / 25 V 0603**（X5R/X7R） | 原 BOM 100µF 贴不了 0603；**100µF 电解单独买**（见 #2） |
| 2 | 外接 | **100 µF / 25 V 电解**（插件，Ø6.3） | 焊在 J1 输入两端或 J6 电源端（飞线/直接搭焊） |
| 3 | **C1、C3** | **10 µF / 25 V 0603**（至少 16 V） | 挂在 VIN_PROTECTED，9V 输入需 ≥16V，12V 需 ≥25V |
| 4 | C4 / C8 | **C4 = 10 µF / 16 V 0603**；**C8 = 100 nF / 50 V 0603**（两者并联在 +5V_REG 与 GND 之间） | 5V 输出侧：大电容+高频去耦 |
| 5 | C2 / C6 | **C2 = 10 µF / 16 V 0603**；**C6 = 100 nF / 50 V 0603**（并联在 +3V3_EXT 与 GND 之间） | 3.3V 输出侧：大电容+高频去耦 |
| 6 | **R12** | **220 Ω 0603**（BOM 标 200） | 200Ω 时 If≈18.5mA 接近额定 20mA；220Ω 留余量 |
| 7 | R13 | 1 kΩ 0603，**另备 2.2 kΩ** | 弱光时换 2.2k 提升灵敏度 |
| 8 | **U3** | **LM1117T-ADJ，TO-220-3**（C498319） | 必须配：**散热片 10×10×8 + 绝缘垫片/粒 + 导热硅脂**（背板 5V 电位） |
| 9 | 灯珠 | 三合一 4 线 **共阴** RGB（组委会提供） | 拿到先数线：4 线=三合一；6 线=分立（需聚光） |

## DNP 不需要买（或买了不贴）

| 位号 | 器件 | 状态 |
|---|---|---|
| Q1、Q2、Q3 | AO3400A | **DNP** |
| R2、R5、R8 | 10 kΩ | **DNP** |
| R23 | 0 Ω | **DNP**（需要时再贴） |

## 采购清单（按 BOM，26 行 / 59 件）

| 位号 | 值/型号 | 封装 | 数量 | 立创编号 | 备注 |
|---|---|---|---|---|---|
| C1,C2,C3,C4 | 10 µF | 0603 | 4 | — | **C1/C3 要 25V**；C4 16V |
| C5,C6,C7,C8,C9 | 100 nF | 0603 | 5 | — | 50V X7R |
| C10 | 10 µF/25 V | 0603 | 1 | — | **不要买 100 µF** |
| D1 | SS34 | SMA | 1 | C7420365 | 防反接 |
| D2 | GL0603UG01（红 LED） | LED0603 | 1 | C51933293 | 通光指示 |
| J1 | XY301V-A-5.0-2P | 插件 | 1 | C9900016950 | 电源输入 |
| J3 | A2547WV-4P | 插件 | 1 | C9900216472 | RGB 接口 |
| J4,J5 | 2P 2.54 排针 | 插件 | 2 | C9900015265 | 红外 |
| J6 | MDF7-5P-2.54DSA | 插件 | 1 | C19088617 | 电机 |
| J7 | PZ2.54-1x4P | 插件 | 1 | C32713270 | 串口 |
| JP1 | 2P 2.54 跳线 | 插件 | 1 | C9900015265 | 5V 注入 |
| KEY1,KEY2 | 5.8×5.8 六脚轻触 | 插件 | 2 | C5379898 | 组委会提供 |
| Q1–Q3 | AO3400A | SOT-23 | 3 | C700953 | **DNP** |
| Q4–Q6 | S8550 | SOT-23 | 3 | C20069126 | RGB 高边 |
| R2,R5,R8,R15,R20,R21,R22 | 10 kΩ | 0603 | 7 | — | R2/R5/R8 **DNP** |
| R3 | 180 Ω | 0603 | 1 | — | 红限流 |
| R6,R9,R10 | 120 Ω | 0603 | 3 | — | 绿蓝；R10 分压 |
| R11 | 360 Ω | 0603 | 1 | — | 5V 分压 |
| R12 | **220 Ω** | 0603 | 1 | — | 红外发射（替代 200） |
| R13,R14,R17,R18,R19 | 1 kΩ | 0603 | 5 | — | R13 可备 2.2k |
| R16 | 470 Ω | 0603 | 1 | — | 3V3 假负载 |
| R23 | 0 Ω | 0603 | 1 | — | **DNP** |
| TP1–TP9 | RH-5000 测试针 | 插件 | 9 | C5277086 | — |
| U1 | 天空星核心板 | DIP-80 | 1 | — | 组委会提供 |
| U2 | LM1117-3.3 | SOT-223 | 1 | C55544533 | — |
| U3 | **LM1117T-ADJ** | **TO-220** | 1 | C498319 | +散热片/绝缘垫片 |

## 接线端子对应

- J1：1=+VIN(9V)、2=GND
- J3：1/2/3=红/绿/蓝阳极，4=GND（公共阴极）
- J4：1=阳极（长脚）、2=GND
- J5：1=C、2=E
- J6：1=VIN、2=GND、3=PWM、4=FG、5=AUX
- J7：1=GND、2=PA2、3=PA3、4=UART_VCC（R23 不贴）

## 若已按旧清单下单，补救

| 已买错 | 补救 |
|---|---|
| C10 = 100 µF 0603 | 补买 1 颗 10 µF/25 V 0603（几毛钱）；100 µF 改外接电解 |
| C1/C3 = 10 µF/10 V 0603 | 9V 输入勉强可用；补买 25 V 版更稳 |
| R12 = 200 Ω | 可用（18.5mA 未超 20mA），不换也行 |

---

## 2026-10-27 实际采购清单核对（A 已下单 21 项）

### 逐项判定

| # | 采购项 | 结论 | 说明 |
|---|---|---|---|
| 1 | D1 SS34 SMA | ✅ | — |
| 2 | D2 GL0603UG01 绿色 0603 | ✅ | 指示色无所谓 |
| 3 | Q4–Q6 S8550 SOT-23 | ✅ | 共阴高边主方案 |
| 4 | **H1,H2 2×20 排母** | ✅ **必买** | 我们 BOM 漏列了这 2 个（U1 的 DIP-80 脚印就是母座位置） |
| 5 | J1 XY301V-5.0-2P | ✅ | — |
| 6 | J3 A2547WV-4P | ✅ | 见下方"缺 XH 母壳"提醒 |
| 7 | JP1 跳线帽 | ✅ | 配 2P 排针 |
| 8 | TP1–TP9 RH-5000 | ✅ | — |
| 9 | **C-EXT 100µF/25V 电解 6.3×7.7** | ✅ | 外接 bulk，正确 |
| 10 | M3 铜柱 | ✅ | — |
| 11 | R3 180Ω | ✅ | — |
| 12 | R6,R9,R10 120Ω | ✅ | — |
| 13 | R11 360Ω | ✅ | — |
| 14 | **R12 200Ω** | 🟡 可用 | If≈18.5mA，顶到额定 20mA；有 220Ω 就换，没有也能焊 |
| 15 | R13,R14,R17–R19 1kΩ | ✅ | 建议另备 1 颗 2.2k（弱光换） |
| 16 | R2,R5,R8,R15,R20–R22 10kΩ | ✅ | R2/R5/R8 是 DNP，买了不贴 |
| 17 | R16 470Ω | ✅ | — |
| 18 | R23 0Ω | ✅ | DNP |
| 19 | **C1–C4 10µF/16V** | 🟡 有条件可用 | **只在 9V 输入下安全**；C1/C3 若上 12V 会超压 → **严禁 12V** |
| 20 | C5–C9 100nF/50V | ✅ | — |
| 21 | **C10 10µF/25V X5R** | ✅ | 正确，符合修正结论 |

### 缺项（必须补）

| 缺什么 | 为什么 | 怎么补 |
|---|---|---|
| **U3 散热片 10×10×8** | TO-220 在 9V/0.8W 下需散热 | 立创/淘宝几块钱 |
| **绝缘垫片 + 绝缘粒** | U3 背板是 5V 电位，散热片不能碰 GND/外壳 | 同上，买 TO-220 绝缘套装 |
| **导热硅脂** | 散热片贴合 | 一小支 |
| **J6 电机连接器（MDF7-5P 母壳/端子 或匹配线束）** | 板上 J6 是 MDF7-5P 针座，电机线需对应母壳 | 确认电机自带线束是否匹配；不匹配就买 MDF7-5P 压接线束或直接焊线 |
| **J3 的 XH2.54 4P 母壳 + 端子（可选）** | J3 是板端针座，若灯珠是裸线 | 要么买 4P XH 母壳压线，要么把线直接焊在 J3 引脚上 |

### 组委会物料发放时核对（不买）

- U2（LM1117-3.3，SOT-223，C126027）、U3（LM1117-ADJ，TO-220，C498319）
- KEY1/KEY2（5.8×5.8 六脚，C5379898）
- RGB 灯珠（三合一 4 线共阴）
- 2.54 排针（J4/J5/JP1 用）
- 核心板（天空星 STM32F407VET6）

### 由此产生的装配约束（写进测试记录）

1. **只允许 9V 输入**（C1/C3 是 16V，12V 会超压；C10 25V 没问题）
2. R12=200Ω 时红外发射接近额定，长时间点亮注意温度（不大）
3. U3 必须装散热片且绝缘
