Lilffy/NIPKOW/docs/BOM.md

# BOM（物料清单）v1 — 2026-10-24

> 依据：`Nipkow/sch/Schematic1/P1.esch2`（R17 已删，SHA-256 `4D34E959…C9989`）
> 明细 CSV：`docs/BOM_draft.csv`（51 个元件）
> 状态：**值已补齐**；封装大部分已定；立创编号仅少数已知 → 采购前必须补全

---

## 1. 汇总（按功能分组）

### 1.1 电源（7 + 2 器件）

| 位号 | 值 | 封装 | 说明 | 立创编号 |
|---|---|---|---|---|
| J1 | — | CONN-TH_XY301V-A-5.0-2P（KF301-2P） | 7.4–12 V 输入端子 | 待定 |
| D1 | SS34 | SMA | 防反接肖特基 | 待定（C7420365 为当前器件） |
| U2 | LM1117-3.3 | SOT-223 | 只供红外/指示 3.3 V | **C55544533**（器件名）／赛题给 C126027 ⚠️ |
| U3 | LM1117T-ADJ | TO-220 | 5 V 主轨（R10=120 Ω、R11=360 Ω） | **C498319** ✓ |
| C1/C3 | 10 µF | 0603 | 输入滤波（VIN_PROTECTED） | 待定 |
| C2/C4 | 10 µF | 0603 | 输出滤波 | 待定 |
| C5–C8 | 100 nF | 0603 | 高频退耦 | 待定 |
| C9 | 100 nF | 0603 | 电机电源退耦（新增） | 待定 |
| C10 | 100 µF | **待定** | 电机储能（新增，封装不能是 0603） | 待定 |

### 1.2 RGB 驱动（共阴版，2026-10-24 改）

| 位号 | 值 | 封装 | 说明 |
|---|---|---|---|
| Q4/Q5/Q6 | S8550 | SOT-23 | **新增**，PNP 高边开关（共阴），hFE 200–350（宏嘉诚 C20069126） |
| R17/R18/R19 | 1 kΩ | 0603 | **新增**，PNP 基极串阻 |
| R20/R21/R22 | 10 kΩ | 0603 | **新增**，基极上拉到 +5V_REG |
| R3 | 180 Ω | 0603 | 红路限流（≈15.6 mA，按 Vce≈0.2 V） |
| R6/R9 | 120 Ω | 0603 | 绿/蓝路限流（≈13.3 mA） |
| J3 | — | CONN-TH_A2547WV-4P | RGB 4 线接口；**J3-4 = 公共阴极 → GND** |
| Q1/Q2/Q3 | AO3400A | SOT-23 | **DNP 不贴**（共阳备用，已断开栅极串阻） |
| R1/R4/R7 | — | — | **已删除**（栅极串阻） |
| R2/R5/R8 | 10 kΩ | 0603 | 保留（Q1–Q3 栅极下拉，确保不贴的 NMOS 不会误开） |

### 1.3 红外索引（3 + 2 + 1）

| 位号 | 值 | 封装 | 说明 |
|---|---|---|---|
| R12 | 200 Ω | 0603 | 发射管限流（≈18.5 mA） |
| R13 | 1 kΩ | 0603 | 接收管上拉 |
| R14 | 1 kΩ | 0603 | 指示 LED 限流（原 2.2 kΩ） |
| D2 | GL0603UG01 | LED0603 | 索引指示（绿） |
| J4/J5 | — | HDR-TH_2P-P2.54 | 红外发射/接收对（焊线） |

### 1.4 按键 / 电机 / 核心板 / 测试点

| 位号 | 器件 | 封装 | 说明 |
|---|---|---|---|
| KEY1/KEY2 | 5.8 WSPT | SW-TH_6P-L5.8...K8-5851E | 6 脚双组按键，只用 2/3 脚；赛题物料 C5379898 ⚠️ 需核对 |
| J6 | MDF7-5P-2.54DSA(95) | HDR-TH_5P-P2.54 | 电机 5 线（电源/GND/PWM/FG/AUX） |
| JP1 | 2P2.54 单排针 | HDR-TH_2P-P2.54 | 5 V 注入跳线 |
| U1 | 立创·梁山派·天空星 | DIP-80 | 组委会提供，C22370035 |
| TP1–TP9 | RH-5000 | TEST-TH_BD2.54 | 测试点 |
| J7 | HX PZ2.54-1x4P | HDR-TH_4P-P2.54 | 串口：GND/TX/RX，第 4 脚经 R23 预留 3.3V |
| R23 | 0 Ω | 0603 | **DNP 默认不贴**；贴了则 J7-4 = +3V3_EXT（给 USB-TTL 供电用） |

### 1.5 其它

| 位号 | 值 | 说明 |
|---|---|---|
| R15 | 10 kΩ | PA4 上拉（SPI FLASH 片选） |
| R16 | 470 Ω | U2 假负载 |

---

## 2. 与赛题物料表的对照

| 赛题表 1 项 | 赛题编号 | 本设计对应 | 状态 |
|---|---|---|---|
| 按键/无锁 | C5379898 | KEY1/KEY2（5.8 WSPT） | ⚠️ 需核对封装/脚位 |
| 按键/自锁 | C2693640 | 未使用 | — |
| 0603 阻容 | 通用 | 全部阻容 | ✓ |
| LDO 可调 TO-220 | C498319 | U3 | ✓ |
| LDO 3.3 V SOT-223 | C126027 | U2（现器件名 C55544533） | ⚠️ 编号不一致，需确认能否互换 |
| 排针 2.54 | 通用 | JP1/J4/J5/J6/J3 | ✓ |
| 核心板 | C22370035 | U1 | ✓ |
| RGB 灯珠 | 提供（焊线） | J3 外接 | ✓（参数待实物） |

---

## 3. 采购前必须补的

- [ ] C10：选 100 µF/25 V 电解（或固态），确定封装（6.3×5.4 / 6.3×7.7 / 8×10）
- [ ] 全部器件的**立创编号**（供应商属性目前为空，ERC 有 5 个"编号不匹配"警告）
- [ ] 核对 U2 到底用 C126027 还是 C55544533（封装都是 SOT-223，但参数/货源不同）
- [ ] 核对 KEY1/KEY2 的实物与 C5379898 是否同一封装（6 脚 5.8×5.8，只接 2/3 脚）
- [ ] 连接器选型：J1（KF301-2P 5.08 mm）、J3（A2547WV-4P 或线对板）、J4/J5/J6（是否改可插拔端子）
- [ ] 电机线束插头与 J6 是否匹配（实物到手确认，可能要改连接器）
- [ ] 红外发射/接收管型号（现只有符号：发射管在 J4，接收管 DY-PT4133B 一类在 J5）

## 4. 自备清单（组委会不提供）

- ST-Link、USB-TTL（走核心板调试口）、万用表、示波器（实验室借）
- 散热片/导热垫（U3 TO-220）
- 导线、焊线、热缩管、红色/黑色电源线
