Lilffy/NIPKOW/hardware/BOM_SMT.csv

Quantity | Comment | Designator | Footprint | Value
3 | 10uF/25V | C1,C3,C10 | C0603 | 10uF/25V
2 | 10uF | C2,C4 | C0603 | 10uF
5 | 100nF | C5,C6,C7,C8,C9 | C0603 | 100nF
1 | SS34 | D1 | SMA_L4.3-W2.6-LS5.0-FD
1 | GL0603UG01 | D2 | LED0603-RD
3 | S8550 | Q4,Q5,Q6 | SOT-23-3_L2.9-W1.3-P1.90-LS2.4-BR
4 | 10000 | R15,R20,R21,R22 | R0603 | 10000
1 | 180 | R3 | R0603 | 180
3 | 120 | R6,R9,R11 | R0603 | 120
1 | 360 | R10 | R0603 | 360
1 | 200 | R12 | R0603 | 200
5 | 1000 | R13,R14,R17,R18,R19 | R0603 | 1000
1 | 470 | R16 | R0603 | 470
1 | 外围电路稳压 | U2 | SOT-223-3_L6.4-W3.5-P2.30-LS7.0-BR
