Lilffy/NIPKOW/hardware/BOM.csv

No. | Quantity | Comment | Designator | Footprint | Value | Manufacturer Part | Manufacturer | Supplier Part | Supplier
1 | 3 | 10uF/25V | C1,C3,C10 | C0603 | 10uF/25V
2 | 2 | 10uF | C2,C4 | C0603 | 10uF
3 | 5 | 100nF | C5,C6,C7,C8,C9 | C0603 | 100nF
4 | 1 | SS34 | D1 | SMA_L4.3-W2.6-LS5.0-FD |  | SS34 | R+O(宏嘉诚) | C7420365 | LCSC
5 | 1 | GL0603UG01 | D2 | LED0603-RD |  | GL0603UG01 | Guiguang light(桂光光电) | C51933293 | LCSC
6 | 1 | 主电源接口 | J1 | CONN-TH_XY301V-A-5.0-2P |  | 主电源接口 |  | C9900016950 | LCSC
7 | 1 | RGB灯珠接口 | J3 | CONN-TH_A2547WV-4P |  | RGB灯珠接口 |  | C9900216472 | LCSC
8 | 2 | 2P2.54单排针 | J4,J5 | HDR-TH_2P-P2.54-V-M |  | 2P2.54单排针 |  | C9900015265 | LCSC
9 | 1 | MDF7-5P-2.54DSA(95) | J6 | HDR-TH_5P-P2.54-V-M_MDF7 |  | MDF7-5P-2.54DSA(95) | HRS(广濑) | C19088617 | LCSC
10 | 1 | HX PZ2.54-1x4P ZZ | J7 | HDR-TH_4P-P2.54-V-M |  | HX PZ2.54-1x4P ZZ | hanxia(韩下) | C32713270 | LCSC
11 | 1 | 跳线 | JP1 | HDR-TH_2P-P2.54-V-M |  | 跳线 |  | C9900015265 | LCSC
12 | 2 | 5.8 WSPT | KEY1,KEY2 | SW-TH_6P-L5.8-W5.8-P2.00-LS4.5-TL_K8-5851E-L1 |  | 5.8 WSPT | SHOU HAN(首韩) | C5379898 | LCSC
13 | 3 | AO3400A | Q1,Q2,Q3 | SOT-23-3_L2.9-W1.3-P1.90-LS2.4-BR |  | AO3400A | HUASHUO(华朔) | C700953 | LCSC
14 | 3 | S8550 | Q4,Q5,Q6 | SOT-23-3_L2.9-W1.3-P1.90-LS2.4-BR |  | S8550 | R+O(宏嘉诚) | C20069126 | LCSC
15 | 7 | 10000 | R2,R5,R8,R15,R20,R21,R22 | R0603 | 10000
16 | 1 | 180 | R3 | R0603 | 180
17 | 3 | 120 | R6,R9,R11 | R0603 | 120
18 | 1 | 360 | R10 | R0603 | 360
19 | 1 | 200 | R12 | R0603 | 200
20 | 5 | 1000 | R13,R14,R17,R18,R19 | R0603 | 1000
21 | 1 | 470 | R16 | R0603 | 470
22 | 1 | 0 | R23 | R0603 | 0
23 | 9 | RH-5000 | TP1,TP2,TP3,TP4,TP5,TP6,TP7,TP8,TP9 | TEST-TH_BD2.54-P1.4_RED |  | RH-5000 | 荣和 | C5277086 | LCSC
24 | 1 | 立创·梁山派-天空星开发板 | U1 | DIP-80_L44.97-W69.97-P2.54X2-LS35.9_OLD
25 | 1 | 外围电路稳压 | U2 | SOT-223-3_L6.4-W3.5-P2.30-LS7.0-BR |  | 外围电路稳压 | R+O(宏嘉诚) | C55544533 | LCSC
26 | 1 | 主稳压电路 | U3 | TO-220-3_L10.0-W4.5-P2.54-L |  | 主稳压电路 | HGSEMI(华冠) | C498319 | LCSC
