Lilffy/NIPKOW/handover/docs/mech/board_99x89.dxf

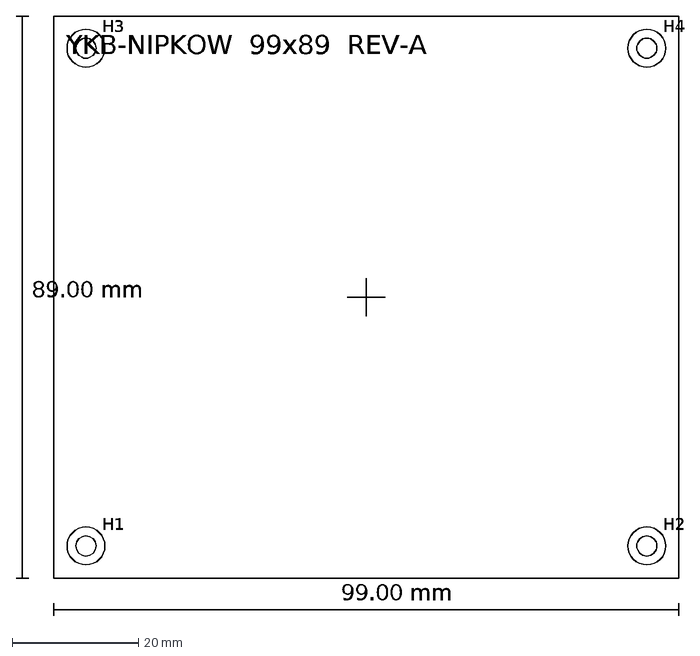
[picture p9: CAD file, 2026-10-27]
handover/docs/mech/board_99x89.dxf
H1
H2
H3
H4
99.00 mm
89.00 mm
YKB-NIPKOW 99x89 REV-A
