Lilffy/NIPKOW/handover/docs/mech/board_100x90.dxf

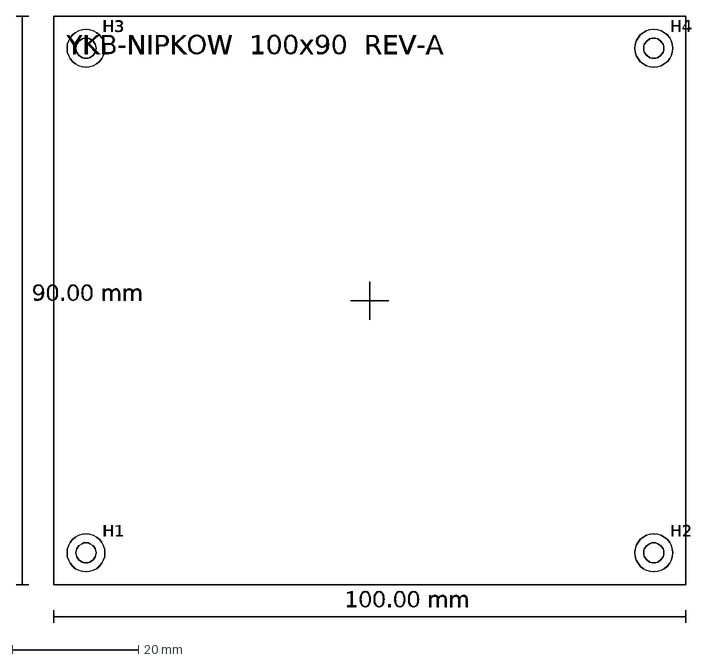
[picture p10: CAD file, 2026-10-27]
handover/docs/mech/board_100x90.dxf
H1
H2
H3
H4
100.00 mm
90.00 mm
YKB-NIPKOW 100x90 REV-A
