Lilffy/NIPKOW/hardware/assembly_bottom.png

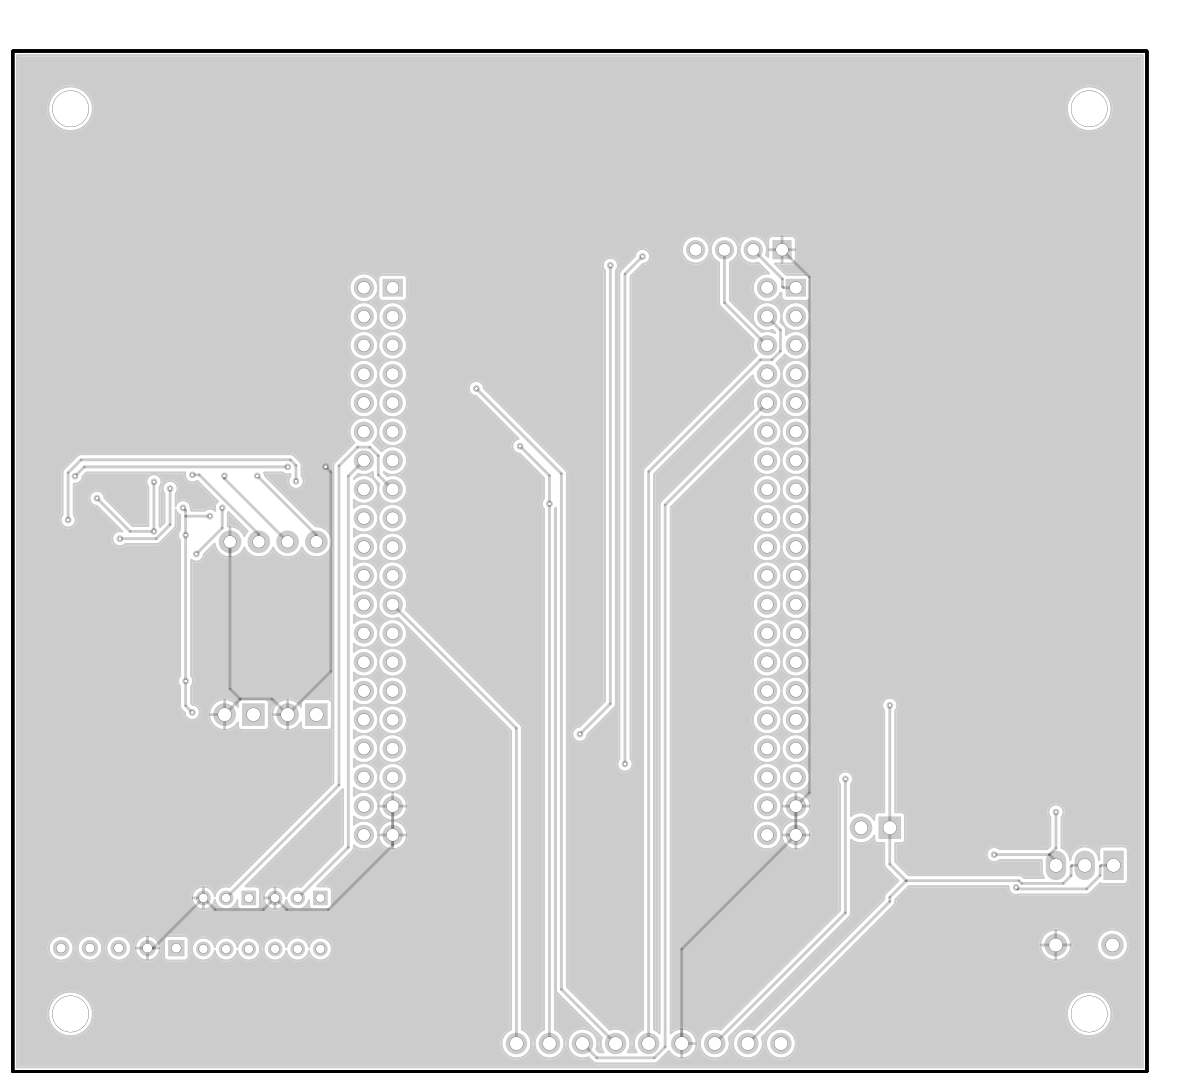
hardware/assembly_bottom.png
