Lilffy/NIPKOW/hardware/assembly_top.png

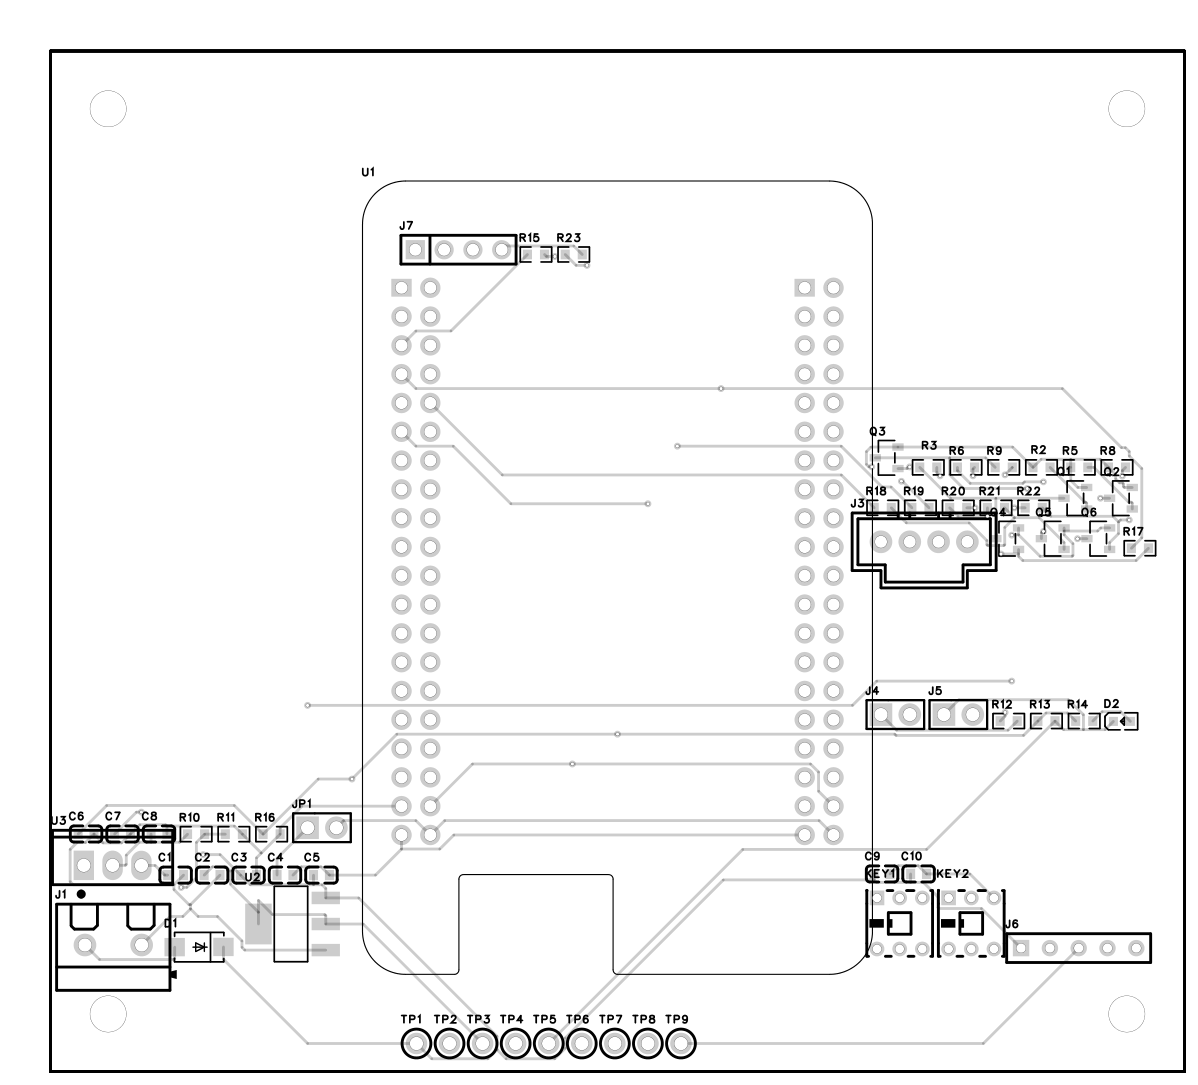
hardware/assembly_top.png
