Lilffy/NIPKOW/docs/QA_PITFALL_REVIEW.md

# 组委会问答逐条对照（2026-10-29 更新）

> 来源：组委会问答（问答.txt，132 条）。逐条对照我们的方案，标出踩过的坑 / 避开的坑 / 仍需注意的点。

## 一、已核对：我们没踩的坑（有证据）

| 问答 | 问题 | 我们的状态 |
|---|---|---|
| Q64/Q65 | 两个排母间距必须 **33.02 mm**（35.9 是定位孔距） | ✅ **从 Gerber 钻孔实测**：两排母内侧行距 = 66.51 − 33.49 = **33.02 mm**，两个 2×20 排母位置正确 |
| Q61/Q62 | 阶段一必须打板 + 焊实物 | ✅ PCB 已下单（10-26），V1 即交付版 |
| Q72 | 10×10 cm 内免费打样 | ✅ 100×90 mm，免费 |
| Q75 | RGB/红外/电机"画出端子、后期焊线"即可 | ✅ J3/J4/J5/J6 全部端子化 |
| Q118 | 测试点用 JLC EDA 的 TP | ✅ TP1–TP9 已放，网表已核 |
| Q124 | 实验室只提供 **0603** 阻容 | ✅ BOM 全部 0603 |
| Q40 | 焊盘乱码 `$1N3` 类网络问题 | ✅ DRC 0 error，网表已逐网核对 |
| Q46 | Proteus 仿真不了 407 | ✅ 不依赖仿真，靠编译 + 串口自测 |
| Q38 | ld 文件必须对应芯片 | ✅ `STM32F407VETx_FLASH.ld` |
| Q9/Q27 | 工具链自由，推荐 VSCode | ✅ CMake + VSCode + arm-none-eabi-gcc |
| Q22 | 器件用立创商城编号，别用软件自带库 | ✅ BOM 全部 C 编号 |
| Q79 | 纯 AI 画板评审不待见 | ✅ 全程人工 review + 网表核对 |

## 二、踩到/需要注意的坑

| 问答 | 问题 | 我们的风险 & 对策 |
|---|---|---|
| **Q84/Q57** | 电机 **6A / 50W 峰值**，电源线宽要够 | ⚠️ **J6 是 MDF7-5P 2.54 端子（约 3A/针）**，6A 峰值会超。对策：**电机电源线不经过 J6**，从 J1 电源端子直接分线给电机；J6 只接 PWM/FG/GND |
| **Q59/Q122/Q123** | 最终用**鳄鱼夹**供电；总电源开关（单刀双掷）由组委会提供 | ⚠️ 我们板上**没有电源开关**，J1 是螺丝端子可夹鳄鱼夹；若验收要求开关，用提供的自锁/双掷开关**外部串在电源线上** |
| **Q119/Q121** | 排母、常用排针排母**由组委会提供** | ⚠️ A 已买 H1/H2 2×20 排母（重复，无害）；后续别再重复买排母/排针 |
| **Q60/Q77** | 红外对管、鼓（3D打印）由组委会提供 | ✅ 已知，别自行采购鼓 |
| **Q120/Q99** | 电机**没有数据手册**，转速/电流未知 | ⚠️ TIM4 PWM 频率（现 1kHz 占位）必须**到货实测**；FG 可用（Q117）但参数未知 |
| **Q82** | 验收**禁止面包板** | ✅ 正式交付用 PCB；调试阶段临时搭面包板允许 |
| **Q116** | 三路 LED 独立调光"无要求，能展示即可" | ✅ 我们的 KEY1/KEY2 六档 + 串口命令都满足 |
| **Q58/Q76** | 红外可只留引脚、后期焊线/杜邦线接出 | ✅ 我们 J4/J5 就是排针，可直接插对管 |
| **Q98** | 3D 打印公差 0.4mm，孔别设计太小 | ✅ 鼓由组委会提供，不涉及我们的机械设计 |
| **Q101** | 排母需与核心板排针"镜像对称"（群内说明） | ✅ 钻孔呈对称 4 列，2×20 排母正反可插（注意丝印方向） |

## 三、需要的技术栈

### 软件
- **C + STM32 HAL**（指针/结构体到"结构体指针"程度足够）
- **STM32CubeMX**（时钟/引脚/外设配置）、**CMake + VSCode + arm-none-eabi-gcc**
- **ST-Link / STM32CubeProgrammer**（下载调试）
- **串口工具**：串口助手 / PuTTY / Python `pyserial`（M7 传图）
- **嘉立创 EDA Pro**（原理图/PCB/导出 Gerber/3D）
- **Git + GitHub**（协作、issue/PR）
- 算法：**PID 整定**（Z-N 起步）、索引周期测速、帧缓冲 + 扫描时序、Python 图像转 16×25 数组

### 硬件
- 天空星 **STM32F407VET6** 核心板 + 2×20 排母（组委会提供）
- 扩展板（已打样）+ 0603 阻容 + 端子/排针（部分提供）
- **ST-Link**、**USB-TTL（CH340/CP2102，3.3V）**
- **9V 电源 + 鳄鱼夹**（严禁 12V：C1/C3 是 16V）
- 万用表（必须）、示波器（可选，测 PWM/纹波）
- 焊台/热风枪（实验室有热风枪）
- **U3 散热片 10×10×8 + 绝缘垫片/绝缘粒 + 导热硅脂**
- 电机 + 线束、RGB 灯珠、红外对管、鼓（均提供）

## 四、行动清单（今天/本周）

1. 只买 **9V** 适配器；**不许 12V**
2. 补买：U3 散热片 + 绝缘垫片/绝缘粒 + 导热硅脂
3. 确认 J6 线束是否匹配；**电机电源从 J1 端子分线**，别走 J6
4. 确认 RGB 灯珠是 4 线三合一共阴
5. 到货后先测排母插拔、U1 间距（33.02 已由钻孔保证）
6. 验收演示脚本：五任务 10 分钟内，逐个演示（不用面包板）

## 五、供电网络专项核对（"只有一个 VCC 标签"陷阱）

**结论：我们没有这个问题。** 电源网络是分裂命名的，没有把所有供电并到一个 `VCC`：

| 网络 | 成员 | 电压 |
|---|---|---|
| `VIN_MAIN` | J1.1、D1.A | 9V 输入（防反接前） |
| `VIN_PROTECTED` | D1.K、C1/C3/C5/C7/C9/C10、U2.VIN、U3.VIN、J6.1、U1.66、TP1 | 9V（防反接后） |
| `+5V_REG` | U3.VOUT、C4/C8、R10.2、R12.1、Q4–Q6 发射极、R20–R22、JP1.1、TP2 | 5V |
| `+5V_CORE` | JP1.2、U1.40/80 | 5V（仅 JP1 短接时注入核心板） |
| `+3V3_EXT` | U2.VOUT、C2/C6、R13/R14/R16、R23、TP3 | 3.3V（只供红外/指示） |
| `+3V3_CORE` | U1.38/78、R15.2 | 核心板自身 3.3V（**不并入** +3V3_EXT，只用于上拉 PA4） |
| `UART_VCC` | R23、J7.4 | 预留（R23 默认不贴） |

**U2 / U3 接法（从原理图 PDF 逐引脚目视核对）**：

- **U3（LM1117-ADJ）**：pin3 VIN ← `VIN_PROTECTED`；pin2 VOUT → `+5V_REG`；pin1 ADJ 经 R10/R11 分压 → 5.0V ✅
- **U2（LM1117-3.3，SOT-223）**：pin3 VIN ← `VIN_PROTECTED`；pin1 GND → `GND`；pin2/pin4（tab）VOUT → `+3V3_EXT` ✅

> ⚠️ 注意：脚本从 `.esch2` 反推网表时，U2（旋转 90°）的符号位置拟合有歧义，曾把 U2 误判成"VIN/VOUT 接反"——**已用原理图 PDF 目视核对排除**，实际接线正确。旋转器件核对以 PDF/EDA 显示为准。

**真正会导致"一上电就烧"的两个点**：

1. **U2 贴反**（SOT-223 旋转 180°）：VIN/VOUT 互换，9V 直接灌进 3.3V 轨 → 烧 U2、红外、LED。焊接前确认 pin1（GND）方向与丝印。
2. **JP1 短接 + 同时插 USB 供电**：5V 轨与核心板 USB VBUS 并联，可能倒灌。做法：JP1 短接时只用外部 9V；插 USB 调试时断开 JP1。
