Lilffy/NIPKOW/docs/CHANGELOG.md

# 改动日志（对工作副本 `Nipkow/` 的编辑）

> 规则：每次改文件前先备份到 `.tools/backup/`；备份 SHA-256 记录在此，便于回滚核对。

## 2026-10-24 19:58 — 连接 JP1-2 → `+5V_CORE`

| 项 | 内容 |
|---|---|
| 文件 | `Nipkow/sch/Schematic1/P1.esch2` |
| 备份 | `.tools/backup/P1.esch2.20261024-195829.bak`（1,724,848 B，SHA-256 `4E7560B9…F9C0`） |
| 改动前 SHA-256 | `4E7560B9E73A51BC42957E6193A5012F42947A916A203328EED126E4FBE9F9C0` |
| 改动后 SHA-256 | `26C4A4698FCA1F5E50692063A26DFC6963D41A70B9FA939556932C3EF538F909` |
| 内容 | 给 JP1 第 2 脚所在的悬空导线（wire `51f54f318647ee7f`，坐标 1560,435→1530,435）加一个网络标签 `+5V_CORE`（ATTR key=NET，位于 1530,435） |
| 目的 | 使 JP1-2 与核心板 5V 引脚（U1-40 / U1-80，已有 `+5V_CORE` 标签）在网表上连通：跳线帽插上时 `+5V_REG` → 核心板 5V |
| 验证 | 重新解析网表：`+5V_CORE` = { JP1.2, U1.40(+5V0), U1.80(+5V0) }；文件逐行 JSON 校验 0 错误；线段簇 33→32（悬空簇并入） |
| 待人工确认 | 在 EDA 中打开工程，检查 JP1 附近出现 `+5V_CORE` 标签、ERC 无新增错误 |

**回滚命令**（PowerShell）：

```powershell
Copy-Item .tools\backup\P1.esch2.20261024-195829.bak .\Nipkow\sch\Schematic1\P1.esch2 -Force
```

## 2026-10-24 20:05 — 新增 4 个元件 + 改 4 个阻值 + PA4 上拉接线

| 项 | 内容 |
|---|---|
| 文件 | `Nipkow/sch/Schematic1/P1.esch2` |
| 备份 | `.tools/backup/P1.esch2.20261024-200611.bak`（1756503 B，最后一次改动前的状态） |
| 改动前 SHA-256 | `26C4A4698FCA1F5E50692063A26DFC6963D41A70B9FA939556932C3EF538F909` |
| 改动后 SHA-256 | `D42B23644466CE58EA03F4EE67DF195E9A1B0C48C98C758B5F3070C55F901630` |
| 新增元件 | R15 = 10 kΩ（PA4 ↔ `+3V3_CORE`，SPI FLASH 片选上拉）<br>R16 = 470 Ω（`+3V3_EXT` ↔ GND，U2 假负载）<br>C9 = 100 nF（`VIN_PROTECTED` ↔ GND，电机电源退耦）<br>C10 = 100 µF（`VIN_PROTECTED` ↔ GND，电机储能，**封装待定**） |
| 值更新 | R3: 330→**180**、R6: 270→**120**、R9: 270→**120**、R14: 2200→**1000** |
| 接线 | 每个新元件自带 2 条短引出线 + 网络标签；另在 U1-5(PA4) 引脚加短引出线 + `PA4` 标签 |
| 布局 | 新元件放在图纸下方空白区 y=1200，x=300/500/700/900（互不相接，已用网表验证） |
| 验证 | 网表：GND 31 脚、`VIN_PROTECTED` 11 脚、`+3V3_EXT` 8 脚、`+5V_CORE` 3 脚、`+3V3_CORE` 3 脚、`PA4` = {R15.1, U1.5}；文件逐行 JSON 0 错误 |
| 待人工确认 | 在 EDA 中打开，确认 4 个新元件正常显示、无红叉/重叠；运行 ERC |

**回滚命令**：

```powershell
Copy-Item .tools\backup\P1.esch2.20261024-200611.bak .\Nipkow\sch\Schematic1\P1.esch2 -Force
```

## 2026-10-24 20:42 — ERC 验收通过 + 补齐 7 个缺失数值

| 项 | 内容 |
|---|---|
| 文件 | `Nipkow/sch/Schematic1/P1.esch2`（EDA 在 20:18 重写过一次，文件结构被规范化：1,755,554 B） |
| 备份 | `.tools/backup/P1.esch2.20261024-204234.bak` |
| 改动后 SHA-256 | `0D283DDB227F5BB40F529CF752D9D06D18733034EA9B71E820FC65AA28A4042D`（1,778,362 B） |
| ERC 结果 | **0 错误，10 警告**（与改动前同一批：6 个单网络 + 1 个供应商编号不匹配 + 3 组悬空引脚）→ 我的 4 个新增元件与阻值修改**没有引入新告警** |
| 补齐数值 | C5 → 100 nF；R2/R5/R8 → 10 kΩ（原本没有 Value 属性，已新建） |
| 发现 | 图中多出 **R17**（器件 `GR0201F2R2TBG00`，2.2 Ω、0201 封装，位于 685,205，两脚悬空）——**不是本次改动添加的**，来源待用户确认 |
| 备注 | EDA 打开工程期间，磁盘上的手改可能被编辑器自动保存覆盖（本次遇到一次 C5 更新丢失，已重做）。**批量修改前请先关闭工程窗口** |

**回滚命令**：

```powershell
Copy-Item .tools\backup\P1.esch2.20261024-204234.bak .\Nipkow\sch\Schematic1\P1.esch2 -Force
```

## 2026-10-24 20:45 — 用户删除 R17；状态复核

| 项 | 内容 |
|---|---|
| 事件 | 用户确认 R17（`GR0201F2R2TBG00`）是误加，已在 EDA 中删除 |
| 文件 | `Nipkow/sch/Schematic1/P1.esch2`，1,757,969 B，SHA-256 `4D34E959B8BDA7C73FB016BB449B9F14CB558739C6F263F6CD2FDEE8110C9989` |
| 复核 | 元件 51 个（R17 已消失）；R15/R16/C9/C10、R3=180、R6/R9=120、R14=1000、C5=100nF、R2/R5/R8=10k 全部保留 |
| 网表 | `+5V_CORE` = {JP1.2, U1.40, U1.80}；`PA4` = {R15.1, U1.5}；GND 31 脚；VIN_PROTECTED 11 脚；无短接告警 |
| 新增文档 | `docs/BOM.md`（分组物料清单 + 采购待办）、`docs/BOM_draft.csv`（51 行明细） |

> 注：本轮之后 `docs/CHANGELOG.md` 中的"当前哈希"以本节为准；每次 EDA 保存都会改变文件哈希，属正常。

## 2026-10-24 21:14 — RGB 驱动改为共阴（PNP 高边）

| 项 | 内容 |
|---|---|
| 前置 | 用户在 EDA 中放置了 3 颗 S8550（`S8550_C20069126`，宏嘉诚，hFE 200–350，SOT-23），Q4/Q5/Q6 |
| 备份 | `.tools/backup/P1.esch2.20261024-211442.bak`（1,778,115 B） |
| 改动后 | 1,843,130 B，SHA-256 `B171D8B88506AB121C1DB8A26F5C4E61CFB6B91234B2A0BECC9845294E27EB92` |
| 改动 | ① J3-4 网络标签 `+5V_REG` → **GND**（公共阴极）<br>② 三个驱动节点命名 `R_DRV/G_DRV/B_DRV`<br>③ **删除 R1/R4/R7**（NMOS 栅极串阻）→ Q1–Q3 栅极仅剩 10 kΩ 下拉，永久关断<br>④ 新增 R17/R18/R19 = 1 kΩ（基极串阻）、R20/R21/R22 = 10 kΩ（基极上拉到 +5V_REG）<br>⑤ Q4–Q6 引脚接线：B→`x_BASE`、C→`x_DRV`、E→`+5V_REG` |
| 末态网表 | `R_DRV`={R3.2, Q4.C, Q1.D}、`R_BASE`={Q4.B, R17.2, R20.2}、`R_PWM`={PA6, R17.1, TP6}（G/B 同理）；J3-4 在 GND；Q4–Q6 发射极在 +5V_REG |
| 说明 | NMOS 组 Q1–Q3、R2/R5/R8 保留但**不贴**（BOM 标注 DNP）；栅极串阻已删除，即使 GPIO 推挽也不会误开 NMOS |
| 固件影响 | PA6/PA7/PB0 必须配置为**开漏输出**（低=亮，PWM 取反）；若推挽输出 3.3 V，PNP 会关不死 |

**回滚命令**：

```powershell
Copy-Item .tools\backup\P1.esch2.20261024-211442.bak .\Nipkow\sch\Schematic1\P1.esch2 -Force
```

## 2026-10-24 21:46 — 串口 J7 接入 + 原理图分区整理

| 项 | 内容 |
|---|---|
| 前置 | 用户放置了 1×4 2.54 排针（器件 `HX PZ2.54-1x4P ZZ`），原设计ator `U4` |
| 改动后 | 1,898,216 B，SHA-256 `BE317FA65582774965E43C888BAD71C9A5745F0A65D510A601272550C7AD24A9` |
| 串口 | U4 **重命名为 J7**；pin1→GND、pin2→UART_TX(PA2)、pin3→UART_RX(PA3)、pin4 悬空（NC，勿接 USB-TTL VCC） |
| 分区移动 | J3 从电源区移到 RGB 区 (1280,410)→(480,300)<br>Q4–Q6 + R17–R22 从图纸下方移到 RGB 区 (x 100–220, y 470–850)<br>C9/C10 移到核心板/电机之间 (900,1000)/(1060,1000)<br>R16 移到电源区 (1300,620)<br>R15 移到核心板旁 (1050,1400)<br>J7 移到左下 (300,1200) |
| 验证 | 分批移动，每批后重跑网表对比：**J3、RGB 组、C9/C10/R15/R16/J7 四批均与移动前网表完全一致**（无新增短接） |
| 末态网表 | `UART_TX`={J7.2, PA2}、`UART_RX`={J7.3, PA3}、`GND` 33 脚、`R_DRV/G_DRV/B_DRV` 各 3 脚、`+5V_REG` 13 脚 |
| 遗留 | 7 段已删元件留下的残桩（不影响电气；ERC 可能报单网络警告） |
| 文档 | 新增 `docs/SCHEMATIC_LAYOUT.md`（分区图）、更新 `docs/NETS.md`、`docs/BOM_draft.csv`（含 J7） |

## 2026-10-24 23:47 — J7-4 加 R23（0 Ω 预留，默认不贴）

| 项 | 内容 |
|---|---|
| 改动后 | 1,869,747 B，SHA-256 `8D46D07DEFBF24A0472E188B64E4DAC7291609E9BAADFF78131D5CB2BAFCBC9B` |
| 新增 | R23 = 0 Ω（0603，**默认不贴**） |
| 连接 | J7.4 —(网络 `UART_VCC`)— R23 — `+3V3_EXT` |
| 用法 | 需要板子给 USB-TTL 供电时贴 R23；否则保持不贴（J7-4 悬空，安全） |
| 验证 | 网表：`UART_VCC`={J7.4, R23.2}、`+3V3_EXT` 9 脚（含 R23.1）；其余网络与改动前完全一致；JSON 0 错误 |
| 备注 | EDA 期间重写过文件（体积由 1.90 MB 变为 1.87 MB，属日志规范化），语义已验证一致 |

## 2026-10-24 23:52 — PCB 首次整体摆放（机械预留方案）

| 项 | 内容 |
|---|---|
| 前置 | 用户在 EDA 执行"从原理图更新到 PCB"，PCB 出现 59 个封装（初始位置散乱） |
| 文件 | `Nipkow/pcb/PCB1.epcb2`，1,505,007 B，SHA-256 `5BFA7CDA0B45EFBA07A1A2813FC46172820D4C80827A3CE9016C13E23F246997` |
| 板框假设 | **110 × 90 mm**（4331 × 3543 mil），原点在左下角；R3 圆角 |
| 布局 | 核心板 U1 居中（33×70 mm 包络）；左侧条带=电源区；右侧条带=RGB（上）/红外（中）/按键+电机（下）；顶条带=J7+R15+R23；底条带=TP1–TP9 |
| 器件 | 59 个全部落位；**两两包围盒重叠 = 0**（脚本检查） |
| 坐标范围 | x 123–4182 mil、y 97–3223 mil（板内，四周留 ≥5 mm） |
| 待用户完成 | 画板框、打安装孔（见 PCB_PLAN）、检查 U1 方向与机械件 |
| 备注 | 摆放为"棚架式"自动排列，位置是初稿，允许自由微调 |

## 2026-10-25 03:36 — 板框改 100×90 mm，重新摆放

| 项 | 内容 |
|---|---|
| 原因 | 用户澄清下单限制是**单边 <100 mm**（此前误按 110×90 摆放） |
| 改动 | `pcb_place.py` 板宽 4331→**3937 mil（100 mm）**；重新摆放 + 位号文字跟随 |
| 文件 | `Nipkow/pcb/PCB1.epcb2`，1,605,193 B，SHA-256 `59D0DDDB138295158B3E09BE30986E94EAB547BB897CB52F76703E6D8C61C2C4` |
| 结果 | 59 器件全部落位；包围盒重叠 0；器件实际范围 x 2.0–97.2 mm、y 1.5–73.3 mm |
| 孔位 | (5.08,5.08) (94.92,5.08) (5.08,84.92) (94.92,84.92) mm；四角到最近器件 ≥5 mm |
| 待办 | 画板框 100×90、自动布线、人工收尾 |

## 2026-10-25 04:55 — 通过 MCP 接口完成 PCB 板框/孔/自动布线/铺铜/DRC/导出

| 项 | 内容 |
|---|---|
| 方式 | 用户启动 `lceda-pro --mcp http --port 3030`；我用 JSON-RPC 调用编辑器 API（`.tools/lceda.py`） |
| 板框 | 闭合折线，层 11，(0,0)–(3937,3543) mil = **100×90 mm** |
| 安装孔 | 4 × M3 NPTH（3.2 mm）(200,200)(3737,200)(200,3343)(3737,3343) mil |
| 摆放 | 59 个器件按分区坐标重新摆好（API `pcb_PrimitiveComponent.modify`） |
| 自动布线 | 37 个网络全部布通，**未布线 0**；走线约 433 段，**32 个过孔** |
| 铺铜 | 底层 GND 覆铜（`GND_PLANE`），重建铜区后 GND 焊盘全部连通 |
| DRC | **0 错误**（此前 2 个 GND 未连接，铺铜重建后消除） |
| 板参数 | 3937×3543 mil；59 器件（全顶层）；215 焊盘（86 SMT + 125 PTH + 4 NPTH）；37 网络 |
| 导出 | `Nipkow/Gerber.zip`（648 KB）、`BOM.csv`、`PickAndPlace.csv`、`PCBInfo.txt`，已复制到 `docs/export/` |
| 走线宽度 | 全部 **10 mil**（自动布线默认）。尝试加粗到 30–50 mil 产生 245 个间距错误，已回退 |
| 遗留 | C10（100 µF）仍是 0603 封装占位，无法贴装；BOM 缺立创编号；Q1–Q3、R23 为 DNP |
| 脚本 | `.tools/lceda.py`（MCP 客户端）、`apply_place2.py`、`pour.py`、`drc.py`、`export_final.py` |
