Lilffy/NIPKOW/handover/docs/RISKS.md

# 风险登记册（下单前必须清零）

> 更新：2026-10-25　状态：⬜未处理 🟡有对策待验证 ✅已关闭
> 每条都有"验证方法"和"改了要动哪个元件"，不要只写"注意"。

---

## 1. 会直接导致功能失效的风险

| # | 风险 | 触发条件 | 后果 | 对策 | 状态 |
|---|---|---|---|---|---|
| R1 | **RGB 三路 PNP 基极被上拉到 5 V** | 关断时引脚经 10k 被拉到 5 V；三路 PWM = **PA6 / PA7 / PB0**（`docs/refs/引脚分配.md`） | 若非 FT 引脚：长期承受 5 V → 漏电/损坏 | ① 固件**必须开漏**（推挽高会把 PNP 误导通，并倒灌 1 mA）；② 按 F407 数据手册 Table 7 核对这三个脚的 `FT` 标注（F407 GPIO 绝大多数为 FT，含 PA6/PA7/PB0）；③ 万一不是 FT，把那一路 10k 改接 +3V3 | 🟡 待核一眼 |
| R2 | **电机 PWM 只给 3.3 V，电机可能不认** | 3720 内置驱动要求 5 V 逻辑高电平 | 电机不转/转速不线性，第一阶段任务 5 挂 | 实测：3.3 V 方波试转；不行则 PB6 开漏 + 4.7k 上拉 5 V，或 2N7002 电平转换（PCB 预留焊盘） | ⬜ 等实物 |
| R3 | **JP1 5V 与 USB 5V 可能直通** | 核心板 USB 5V 与 `PIN_IN_+5V` 之间无二极管 | 插 USB 时反灌电脑，或双电源打火 | 万用表二极管档实测；直通则规定"USB 供电时拔 JP1"，丝印标注 | ⬜ 待实测 |
| R4 | **U3（LM1117-ADJ）散热不足** | SOT-223 的 θJA：仅引脚 120–150 °C/W、10×10 mm 铜 ≈90、25×25 mm 双面铜 ≈60。9 V/0.3 A 耗散 1.2 W → ΔT 108 °C（裸焊盘），**不可行** | 热保护跌压、输出掉到 4 V、长期失效 | ① **强制用 9 V 适配器**，5V 负载压到 0.25 A 以内；② 焊盘下 ≥25×25 mm 双面铜 + ≥9 个过孔（θJA≈55–60）；③ **加 15×15×10 mm 铝散热片**（θSA≈20 °C/W，总 ≈25–30 °C/W，ΔT≈36 °C）；④ 最优解是换 buck（MP1584 类，损耗 ≈0.2 W） | 🟡 有对策 |
| R5 | **灯珠四脚顺序未核对** | 实物是焊线安装的 4 脚灯珠，R/G/B 顺序可能和 J3 的 1R 2G 3B 不同 | 颜色错乱（红绿蓝互换） | 拿到实物用万用表二极管档点出 3 个 PN 结，标线后再焊；**极性看 R20** | ⬜ 等实物 |
| R6 | **电机 5 线定义未核对（黄线未知）** | 蓝线不是 PWM 或绿色 FG 极性反 | 电机不受控 / 测速错误 | J6 做成可插拔端子；先只接红黑测转向，再逐根试；黄线悬空并用热缩管包住 | ⬜ 等实物 |
| R17 | **LM1117 系列要求输出电容带 ESR** | LM1117/AMS1117 只挂 MLCC（低 ESR）时可能振荡；数据手册建议 22 µF 钽或电解 | 3.3 V/5 V 轨纹波大、甚至自激（负载一跳就掉压） | 每条 LDO 输出必须 **≥10–22 µF 电解/钽 + 100 nF MLCC**；重点核对 U2 输出（C8 只有 100 nF 就不够），U3 侧有 C10（100 µF 电解）✔ | ⬜ 待核原理图 |
| R19 | **5V LDO 封装与赛题提供件不一致** | 赛题表1 提供的可调 LDO 是 **TO-220（C498319）**；本板 U3 画的是 **SOT-223** | 用不了组委会那一片（自购 C263277 几块钱，但等于少了一份备件）；且 SOT-223 散热差 | 二选一：① **改 TO-220 封装**（顺带解决 R4：TO-220 夹散热片 θJA≈25，1.2 W 只升 30 °C）；② 保留 SOT-223 + 自购 + 散热片。**打板前定死** | ⬜ 待决策 |
| R20 | **RGB 灯珠极性：赛题图写"共阳"，TASKS 记"共阴"** | 赛题图 3 标注"共阳 · LED 灯罩固定"；TASKS V2.0 说组委会口径为共阴，原理图已按共阴改（高边 PNP） | 若实物是共阳，现在的高边方案点不亮（三路全灭），第一阶段任务 2 直接挂 | ① 灯珠是**焊线安装**（赛题表1），拿到实物先用万用表二极管档测公共端；② **Q1–Q3（AO3400A 低边，现 DNP）正好是共阳方案**，别从 BOM 删掉；③ 原理图里 J3-4 与 Q1–Q3 的连接方式要能兼容两种 | ⬜ 等实物 |

## 2. 会导致返工/多花钱的风险

| # | 风险 | 说明 | 对策 | 状态 |
|---|---|---|---|---|
| R7 | 板框 100×90 与摆放 110×90 不一致 | 见 `PCB_P0_PLAYBOOK.md` §4 | 按 §4.2 顺序收缩；实在放不下用 99×89 备选 | 🟡 有流程 |
| R8 | 机械底座尺寸未定 | 孔位/线束长度未知 | 板按 100×90 + 4 角孔先做；底座用腰形孔吸收误差 | 🟡 有对策 |
| R9 | 板载 SPI FLASH 与 PA4/PA6/PA7 复用 | 固件误初始化 SPI1 → 与 FLASH 抢总线 | R15 10k 上拉已锁 CS 高；固件**不初始化 SPI1**；文档写进固件 README | ✅ 已处理 |
| R10 | C10（100 µF/25 V）封装未定 | 不同厂家 6.3×7.7 / 8×10 差异大 | ✅ 已定：直插 6.3×7.7（ROQANG RVT1E101M0607，C72477） | ✅ 已关闭 |
| R11 | **KEY1/KEY2 封装与赛题提供件不符** | 赛题表1 明确提供 **C5379898 无锁按键（5.8×5.8 六脚 DPDT，插件）**；若 PCB 现在画的是 6×6 四脚贴片，实物插不上 | 按 C5379898 重画 KEY 封装（6 脚，脚距见器件手册）；或自购 6×6 四脚但要改丝印/成本 | ⬜ 待改封装 |
| R18 | 2×20 排母老编号已停售 | C50982 页面标「已停售」 | 用 C53202170（或备选 C54973812） | ✅ 已替换 |
| R12 | ERC 遗留 10 条警告 | 单网络、悬空引脚 | 逐条处理或加"非连接标识"，并记录在案 | ⬜ 待重跑 |

## 3. 第二阶段风险（现在只需预留）

| # | 风险 | 现在要做的 |
|---|---|---|
| R13 | 1200 rpm 下索引脉冲抖动 | 红外区已独立地 + 100 pF 预留；后续可加 74LVC1G17 |
| R14 | 电机噪声干扰成像 | 电机地与信号地单点汇接（`ROUTING.md` §3.2）；FG 走线远离 RGB |
| R15 | 16×25 像素时序余量 | 125 µs/像素：单行 25 像素 ≈ 3.1 ms，转一圈 50 ms，余量充足；固件用 DMA + 定时器 |
| R16 | 动平衡与防护 | 3D 打印件留配重槽；转速先 300 rpm 试跑 |

---

## 4. 三条"现在改一个电阻 vs 打板后飞线"的决策

这三条如果拖到板子回来才发现，每条都要飞线 + 割铜：

1. **R1 的非 FT 引脚**：现在把 10k 改接 +3V3，零成本；打板后要割线飞线。
2. **R2 的电机 PWM 电平**：现在在 J6-3 旁预留 1k + 4.7k + SOT-23（2N7002）三个焊盘，零成本；打板后要立着焊。
3. **R3 的 JP1/USB**：现在丝印加一行字，零成本；打板后只能靠记性。

> 建议把这三条做成 PCB 上的**可选焊盘**（默认不贴），比在文档里写"注意"有用得多。

---

## 4.1 可选优化（不改也能过，改了更稳）

| 项 | 现在 | 可选 | 代价 | 建议 |
|---|---|---|---|---|
| U2（3.3V）静态功耗 | LM1117-3.3，Iq ≈ 5 mA（白耗 25 mW，效率 ~40%） | AP2112K-3.3（SOT-23-5，Iq 55 µA）或 XC6206P332 | **改封装 = 改原理图 + 改 PCB** | 赛题点名 LM1117 就别动；只做加分别折腾 |
| U3（5V）效率 | 线性，效率 ~55%，1.0 W 变热 | MP1584/MP2315 buck（损耗 ~0.2 W） | 多 5 个器件、要布电感 | 二期若还要接更多负载，值得改 |
| 3.3V 来源 | 扩展板 U2 产生 | 直接用核心板 3.3V（排针 38 脚） | 少一颗 LDO、少一路功耗 | 若核心板 3.3V 余量够（<100 mA），可省掉 U2 整套 |

---

## 5. 变更记录

| 日期 | 内容 |
|---|---|
| 2026-10-25 | 首版，新增 R1（RGB 5V 兼容）、R2（电机 PWM 电平）、R3（JP1/USB 直通）三条硬件风险 |
| 2026-10-25 | 补料号核验结果：R4 换成实测 θJA 数据 + 散热片方案；R10/R18 关闭；R11 更正为「C5379898 封装不兼容」；新增 R17（LM1117 输出 ESR） |
