Lilffy/NIPKOW/hardware/schematic.pdf

1

2

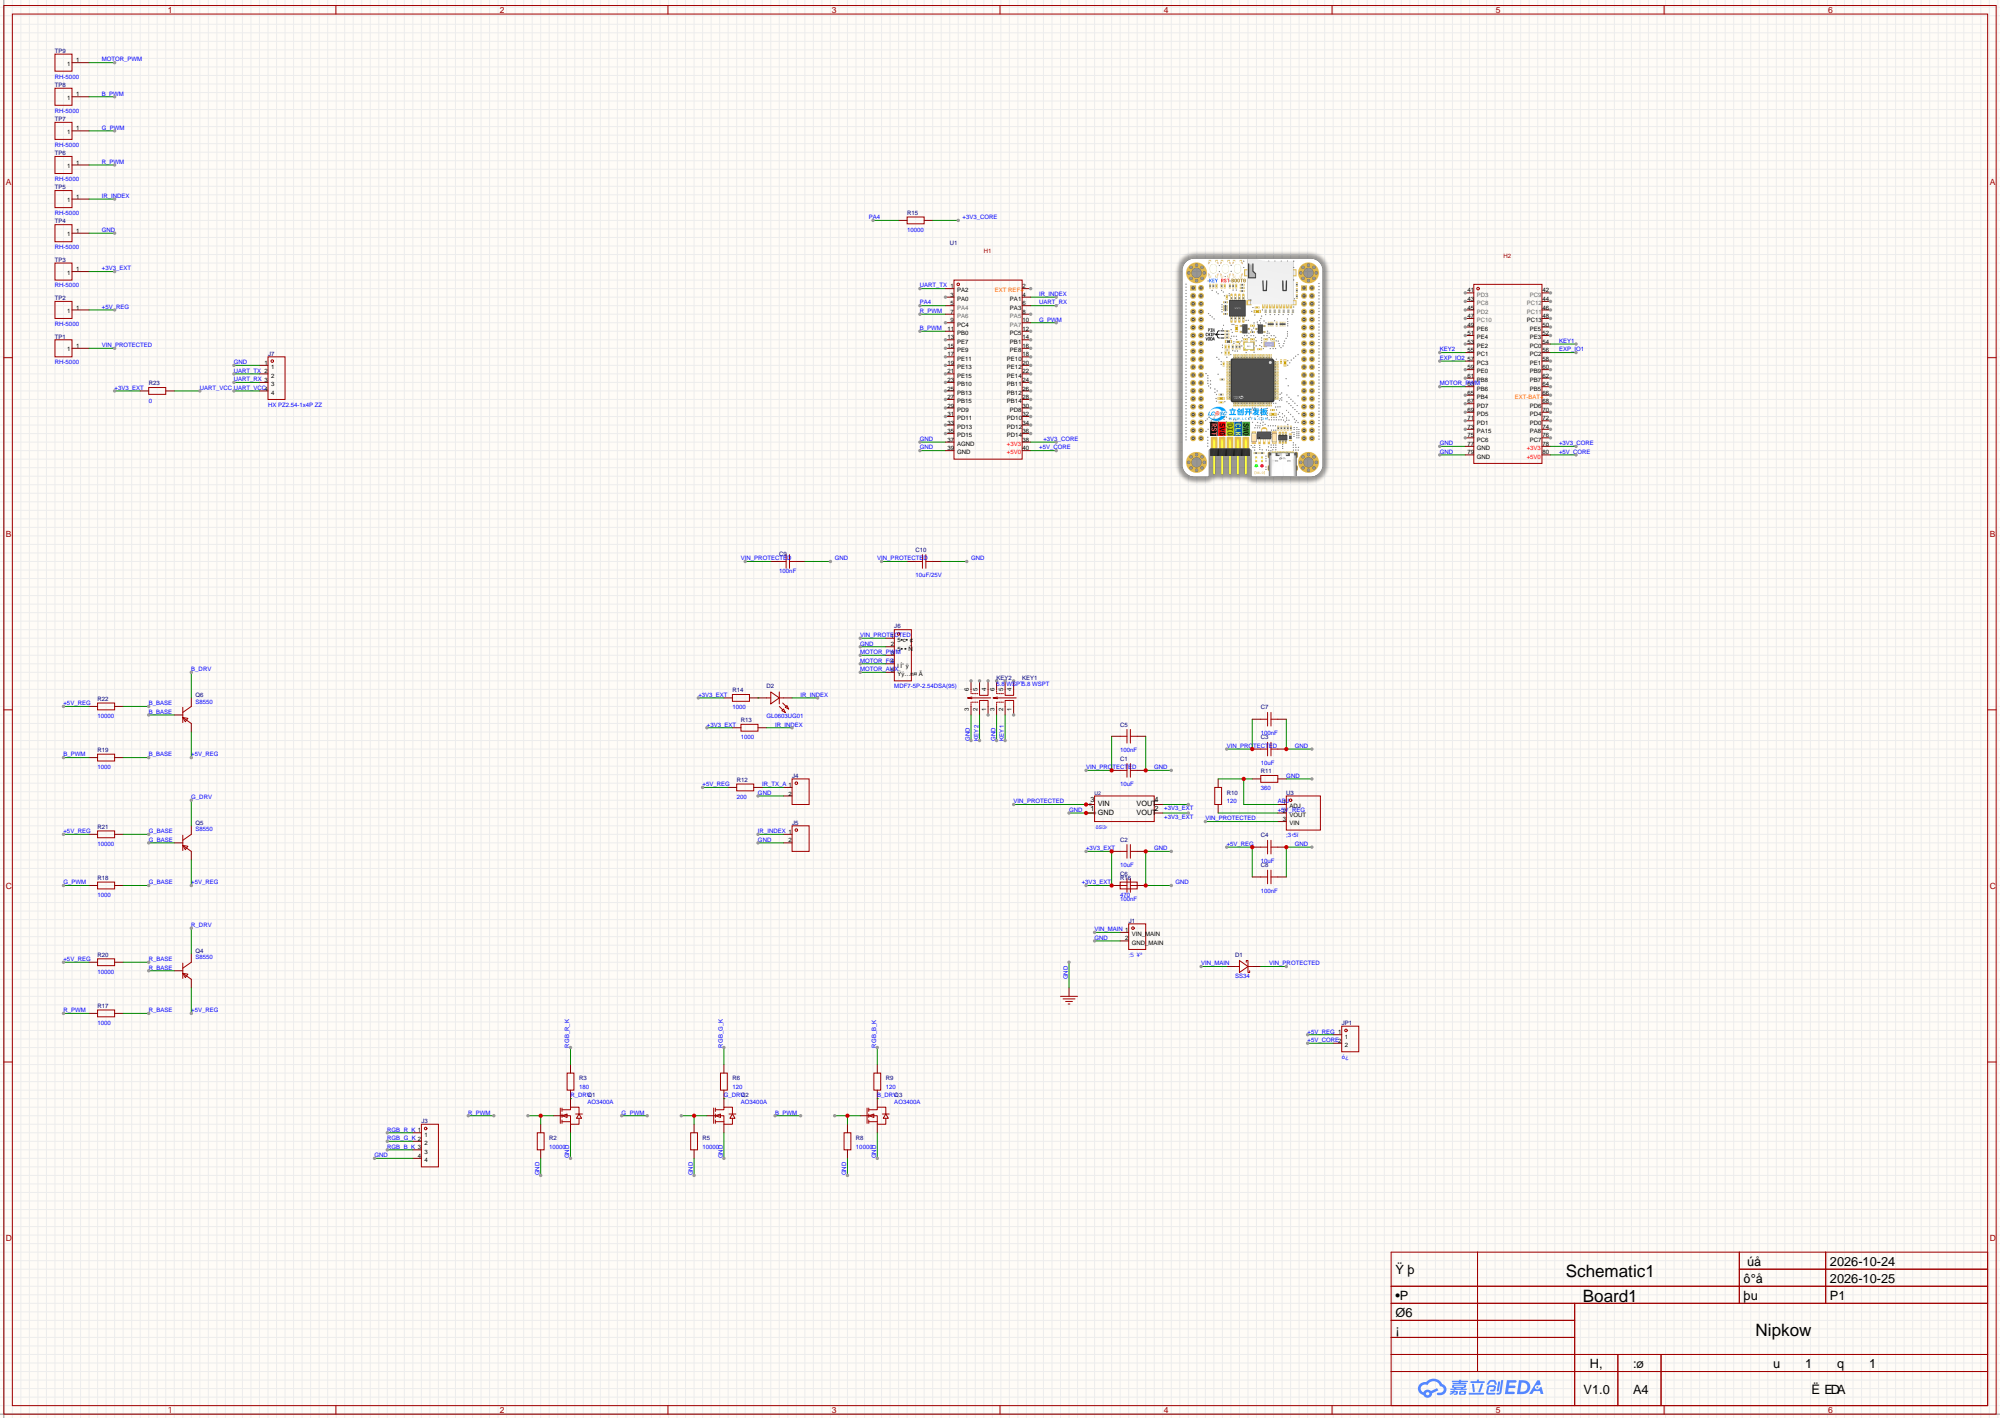
[picture p13: page 1]

TP9
1 | 1 | MOTOR_PWM

RH-5000
TP8

B_PWM

TP7

G_PWM

R_PWM

TP5 | | 1 | IR_INDEX
RH-5000 | | | | R15
TP4 | PA4 | +3V3_CORE

TP3
RH-5000 | | | | | | | | | | UART_TX | | PA2 1 | | EXT REF+2
TP2 | | | | | | | | | | | | PA0 3 | | | | PA1 4 | IR_INDEX | | | 41 | PD3 | | | PC9 | 42

1 | +3V3_EXT

+5V_REG | | | | | | | PA4 | | PA4 5 | | | | PA3 6 | UART_RX | | | 43 | PC8 | | | PC12 | 44

1 | 1 | | | | | | | | R_PWM | | PA6 7 | | | | PA5 8 | | | | 45 | PD2 | | | PC11 | 46
RH-5000 | | | | | | | | | | | | PC4 9 | | | | PA7 10 | G_PWM | | | 47 49 | PC10 | | | PC13 | 48 50

B_PWM | | PB0 11 | | | | PC5 12 | | | | | PE6 | | | PE5

TP1 | | | | | | | | | | | | PE7 13 | | | | PB1 14 | | | | 51 | PE4 | | | PE3 | 52 | KEY1
1 | 1 | VIN_PROTECTED | | | | | | | | | PE9 15 | | | | PE8 16 | | | KEY2 | 53 | PE2 | | | PC0 | 54 | EXP_IO1

RH-5000 | | | | | | | GND | 1 | 1 | | | PE13 19 | | | PE12 20 | | | | EXP_IO2 | 57 59 | PC3 | | | PE1 | 58 60

UART_TX | 2 | | | | | | | PE14 22 PE15 21 | | | | | | PE0 | | | PB9
UART_RX | 3 | 2 | | | PB10 23 | | | PB11 24 | | | | MOTOR_PWM | 61 | PB8 | | | PB7 | 62

+3V3_EXT | | UART_VCC UART_VCC R23 | | 4 | 3 | | | PB13 25 | | | PB12 26 | | | | | 63 | PB6 | | | PB5 | 64

4 | | | PB15 27 | | | PB14 28 | | | | | 65 | PB4 | | EXT-BAT+ | | 66

PD11 31 | | | PD1032 | | | | | | PD5 | | | PD4
PD13 33 | | | PD1234 | | | | | 71 | PD1 | | | PD0 | 72
PD15 35 | | | PD1436 | | | | | 73 | PA15 | | | PA8 | 74

GND | | AGND 37 | | | +3V3 38 | | | +3V3_CORE | | 75 | PC6 | | | PC7 | 76 | +3V3_CORE
GND | | GND 39 | | | +5V0 40 | | | | GND | 77 79 | GND | | | +3V3 | 78 80 | +5V_CORE

GND | | | +5V0

VIN_PROTECTED | GND | VIN_PROTECTED | | GND

VIN_PROTECTED | 1
GND | | 5•c•¢ 5••Ñ 2
MOTOR_PWM | 3
MOTOR_FG | | lÍˆÿ 4

B_DRV | | | | | | | | MOTOR_AUX | | Ÿý…n¤Ä 5

KEY2 | KEY1

R14 | | D2 | | | | MDF7-5P-2.54DSA(95) | | 5.8 WSPT

+5V_REG | R22 | B_BASE | S8550 | | | 1000 | | | | | | | | | | | | | C7

Q6 | +3V3_EXT | | | | | | IR_INDEX

10000 | B_BASE | | | | | | GL0603UG01

+3V3_EXT | | R13 | | IR_INDEX | | | | | | | | C5

R19 | | | | | | | 100nF | | | VIN_PROTECTED | | GND

B_PWM | | B_BASE | +5V_REG | | | | | C1

1000 | | | | | | VIN_PROTECTED | | GND | | | 10uF

J4 | | | | | | R11 | GND

+5V_REG | | 1 | U2 | 10uF | R10 | 360 | U3

GND | 2

G_DRV | 200 | VIN_PROTECTED | | VIN 3 | VOUT4 | | 120 | ADJ

GND 1 | VOUT2 | | | | +5V_REG | 1 | ADJ

GND | | | +3V3_EXT

2 | VOUT

Q5 | | J5 | | | | | | | | | 3 | VIN

+5V_REG | R21 | G_BASE | S8550 | IR_INDEX | 1 | | ô5ï3‹ | | | | | C4 | | ;3‹5ï

10000 | G_BASE | | GND | 2 | | | C2 | | +5V_REG | | | | | GND

+3V3_EXT | | | GND

C | G_PWM | | G_BASE | +5V_REG | +3V3_EXT | | GND | | | C

R_DRV | VIN_MAIN

J1
VIN_MAIN 1
GND_MAIN 2

GND

+5V_REG | R20 | R_BASE | S8550 | | ;5¥ª | VIN_MAIN | D1 | VIN_PROTECTED

10000 | R_BASE

R_PWM | | R_BASE | +5V_REG

+5V_REG
+5V_CORE | 2 | 2

R3 | | | R6 | | | R9
180 | | | 120 | | | 120
R_DRV | | Q1 | G_DRV | | Q2 | B_DRV | | Q3
AO3400A | | | AO3400A | | | AO3400A

RGB_R_K | 1 | 1 | R_PWM | | G_PWM | | GND | B_PWM GND

RGB_G_K | 2 | | | R2 | | R5 | | | R8
RGB_B_K | 3 | 2 | | 10000 | | 10000 | | | 10000
GND | | 4 | 3

úå | | 2026-10-24
ô°å | | 2026-10-25

•P | Board1 | þu | | P1
Ø6
¡ | | | Nipkow
