Lilffy/NIPKOW/hardware/silk_assembly.pdf

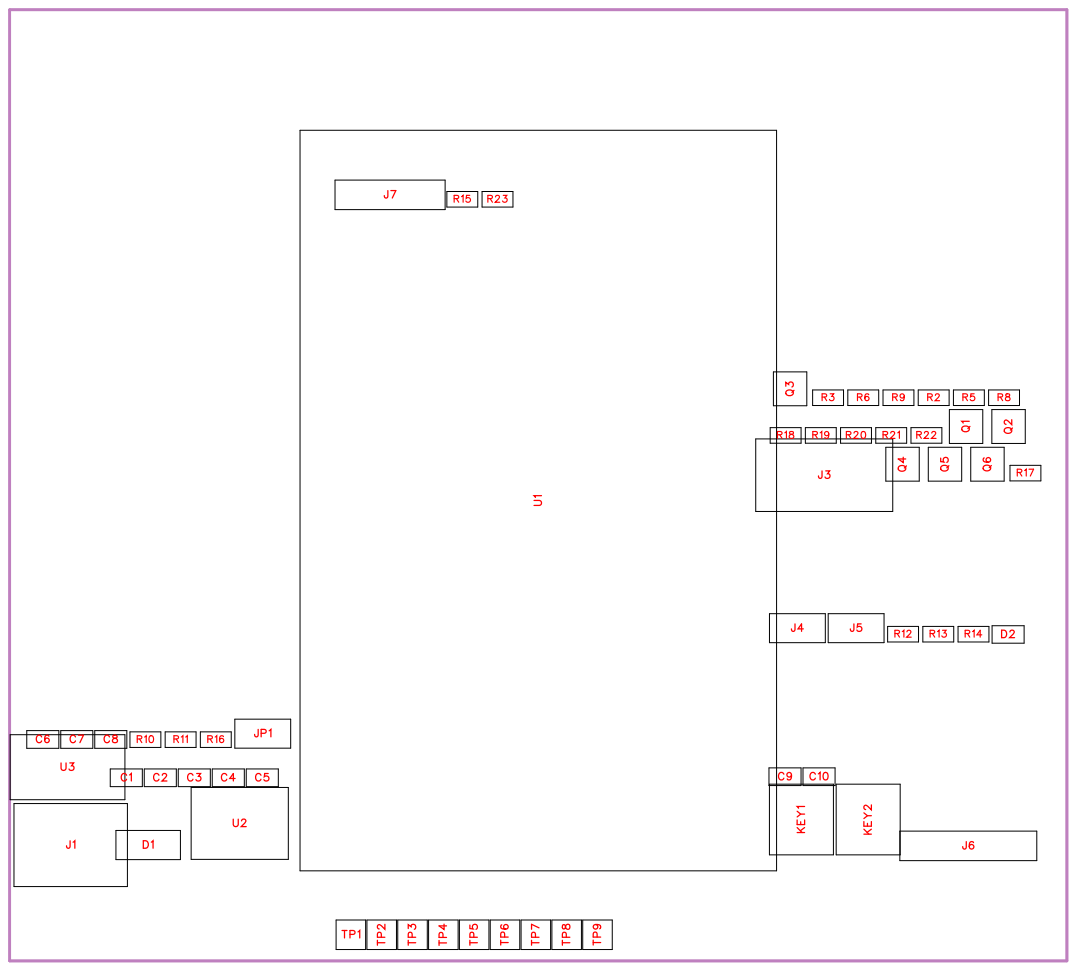
[picture p14: page 1]

No. | Quantity | Comment | Designator | Footprint | Value | Manufacture r Part | Manufacture r | Supplier Part | Supplier
1 | 4 | 10uF | C1,C2,C3,C4 | C0603 | 10uF
2 | 5 | 100nF | C5,C6,C7,C8,C9 | C0603 | 100nF
3 | 1 | 10uF/25V | C10 | C0603 | 10uF/25V
4 | 1 | SS34 | D1 | SMA_L4.3-W2 .6-LS5.0-FD | | SS34 | R+O(• Ú) | C7420365 | LCSC
5 | 1 | GL0603UG01 D2 | | LED0603-RD | | GL0603UG01 | Guiguang light(BII5) | C51933293 | LCSC
6 | 1 | ;5•¥ã | J1 | CONN-TH_XY3 01V-A-5.0-2 P | | ;5•¥ã | | C9900016950 LCSC
7 | 1 | RGBoà¥ã | J3 | CONN-TH_A25 47WV-4P | | RGBoà¥ã | | C9900216472 LCSC
8 | 2 | 2P2.54U’ˆ | J4,J5 | HDR-TH_2P-P 2.54-V-M | | 2P2.54U’ˆ | | C9900015265 LCSC
9 | 1 | MDF7-5P-2.5 4DSA(95) | J6 | HDR-TH_5P-P 2.54-V-M_MD F7 | | MDF7-5P-2.5 4DSA(95) | HRS(•Ñ) | C19088617 | LCSC
10 | 1 | HX PZ2.54-1x4P ZZ | J7 | HDR-TH_4P-P 2.54-V-M | | HX PZ2.54-1x4P ZZ | hanxia(é) | C32713270 | LCSC
11 | 1 | ó¿ | JP1 | HDR-TH_2P-P 2.54-V-M | | ó¿ | | C9900015265 LCSC
12 | 2 | 5.8 WSPT | KEY1,KEY2 | SW-TH_6P-L5 .8-W5.8-P2. 00-LS4.5-TL _K8-5851E-L 1 | | 5.8 WSPT | SHOU HAN(–é) | C5379898 | LCSC
13 | 3 | AO3400A | Q1,Q2,Q3 | SOT-23-3_L2 .9-W1.3-P1. 90-LS2.4-BR | | AO3400A | HUASHUO(N)C700953 | | LCSC
14 | 3 | S8550 | Q4,Q5,Q6 | SOT-23-3_L2 .9-W1.3-P1. 90-LS2.4-BR | | S8550 | R+O(• Ú) | C20069126 | LCSC
15 | 7 | 10000 | R2,R5,R8,R15,R20,R21,R22 R0603 | | 10000
16 | 1 | 180 | R3 | R0603 | 180
17 | 3 | 120 | R6,R9,R10 | R0603 | 120
18 | 1 | 360 | R11 | R0603 | 360
19 | 1 | 200 | R12 | R0603 | 200
20 | 5 | 1000 | R13,R14,R17,R18,R19 | R0603 | 1000
21 | 1 | 470 | R16 | R0603 | 470
22 | 1 | 0 | R23 | R0603 | 0
23 | 9 | RH-5000 | TP1,TP2,TP3,TP4,TP5,TP6, TP7,TP8,TP9 | TEST-TH_BD2 .54-P1.4_RE D | | RH-5000 | cŒ | C5277086 | LCSC

24 | 1 | Ñ• | U1 | DIP-80_L44. 97-W69.97-P 2.54X2-LS35 .9_OLD
25 | 1 | ô5ï3‹ | U2 | SOT-223-3_L 6.4-W3.5-P2 .30-LS7.0-B R | ô5ï3‹ | R+O(• Ú) | C55544533 | LCSC
26 | 1 | ;3‹5ï | U3 | TO-220-3_L1 0.0-W4.5-P2 .54-L | ;3‹5ï | HGSEMI(N ) | C498319 | LCSC

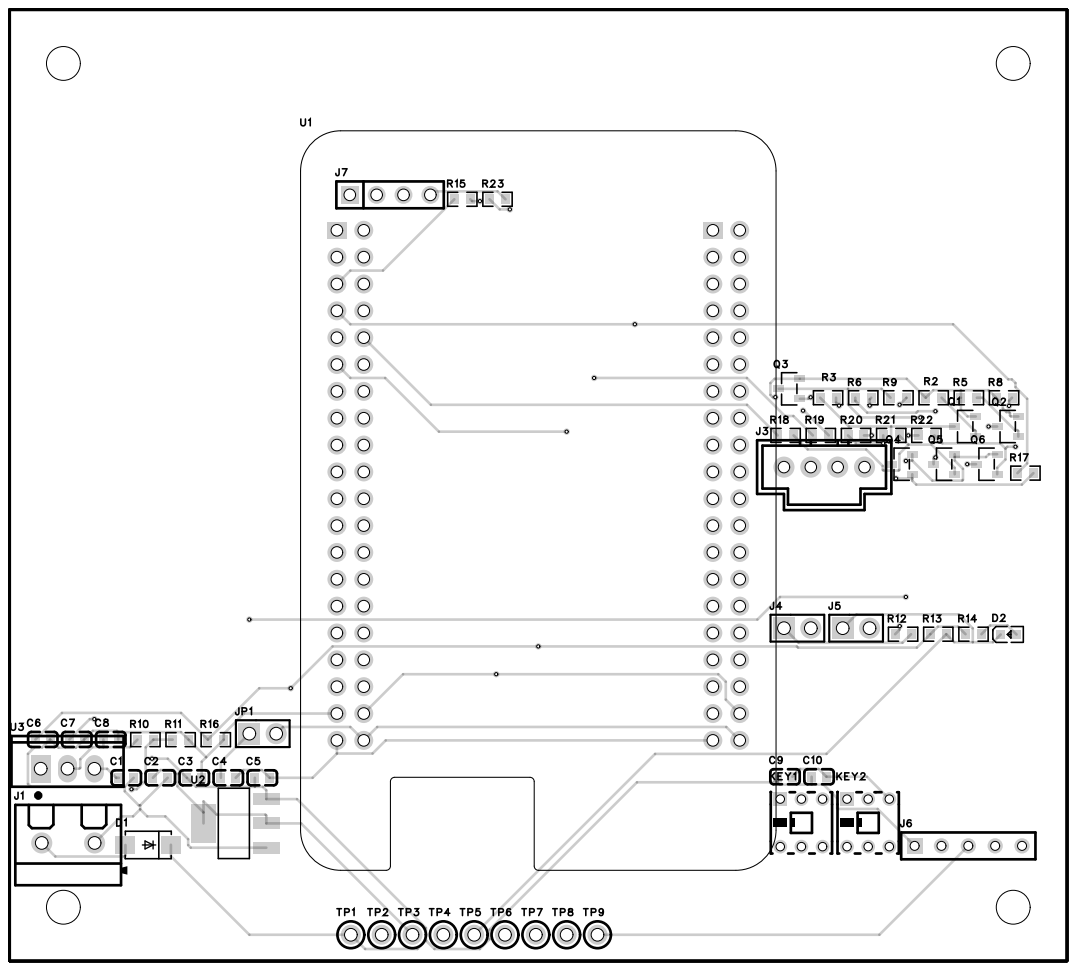
[picture p15: page 5]

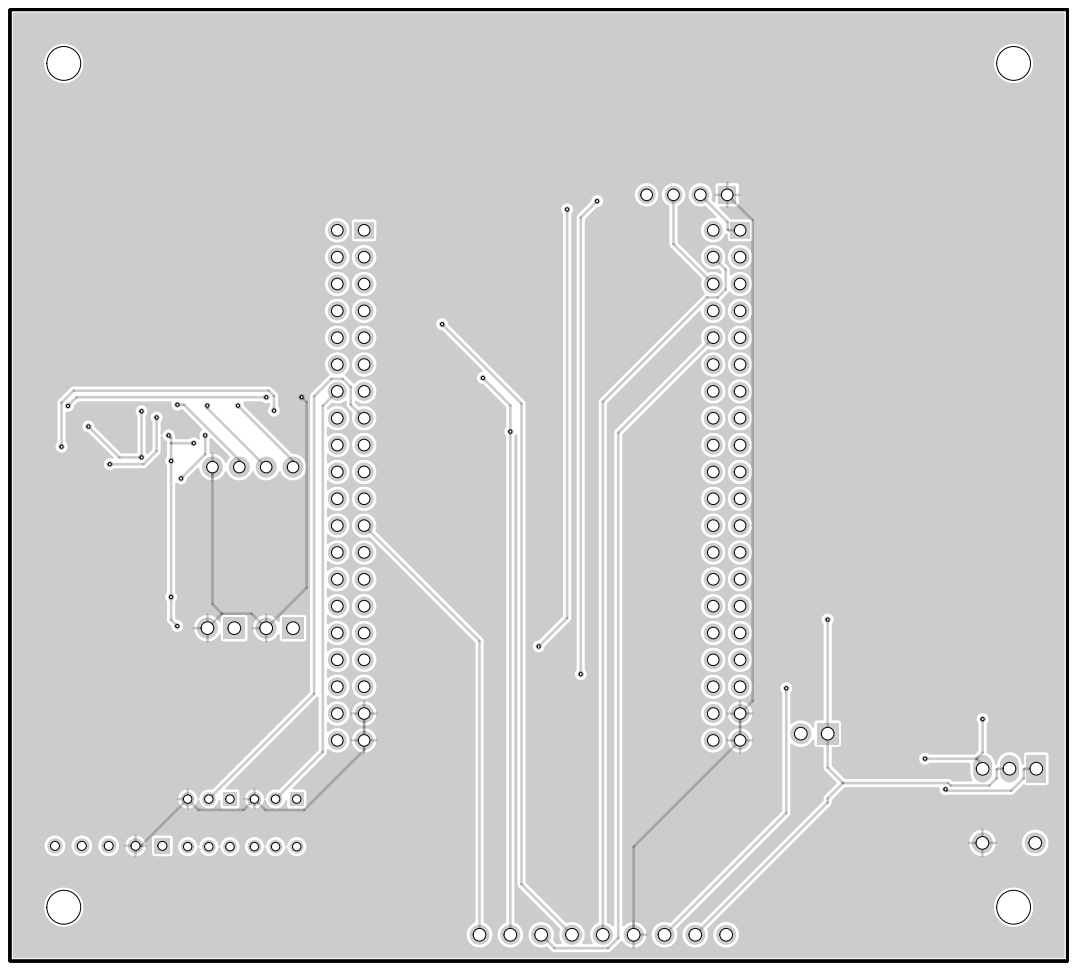
[picture p16: page 6]

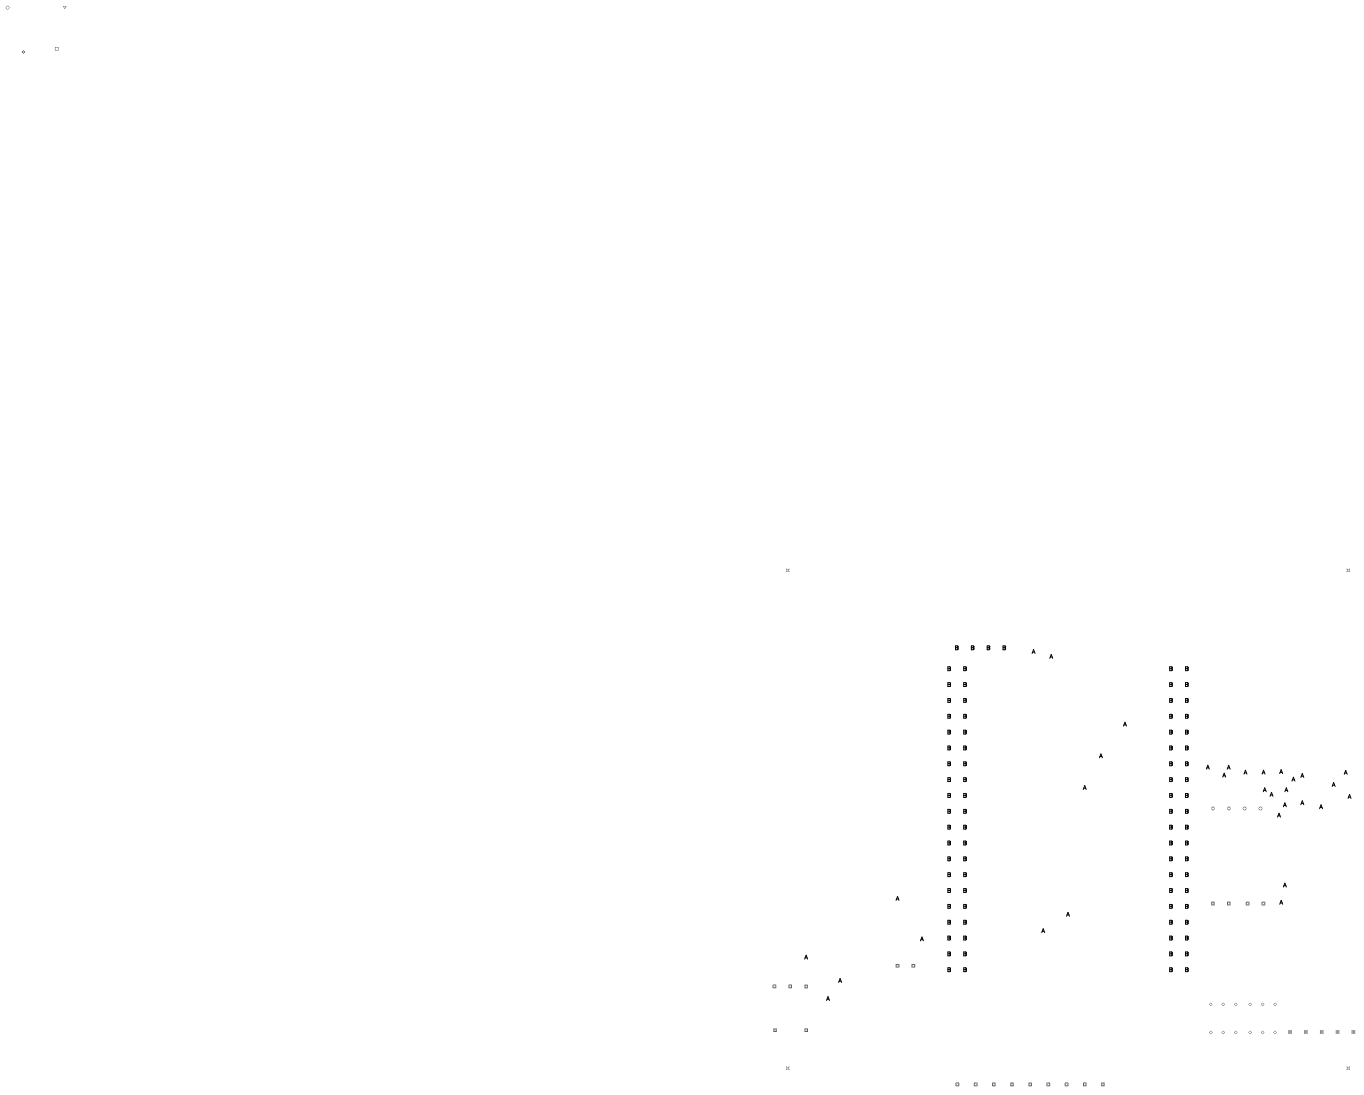
[picture p17: page 7]
