Lilffy/NIPKOW/firmware/cubemx/Core/Src/main.c

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
/* Includes ------------------------------------------------------------------*/

/* USER CODE BEGIN Includes */
#include "main.h"
#include "ir.h"
#include "key.h"
#include "motor.h"
#include "rgb.h"
#include "control.h"
#include "cmd.h"
#include "uart.h"
#include "stm32f4xx_hal_gpio.h"
#include <stdint.h>
#include <stdio.h>

/* USER CODE END Includes */

/* USER CODE BEGIN PD */
/* 取消下一行注释以启动时运行 IR 软件自测。 */
/* #define IR_SELF_TEST */

/* USER CODE END PD */

TIM_HandleTypeDef htim3;
TIM_HandleTypeDef htim4;

UART_HandleTypeDef huart2;

void SystemClock_Config(void);
static void MX_GPIO_Init(void);
static void MX_TIM3_Init(void);
static void MX_TIM4_Init(void);
static void MX_USART2_UART_Init(void);
/* USER CODE BEGIN 0 */
int _write(int fd, char *ptr, int len) {
  (void)fd;
  HAL_UART_Transmit(&huart2, (uint8_t *)ptr, (uint16_t)len, 10);
  return len;
}
/* USER CODE END 0 */

/**
 * @brief  The application entry point.
 * @retval int
 */
int main(void) {

  /* MCU Configuration--------------------------------------------------------*/

  /* Reset of all peripherals, Initializes the Flash interface and the Systick.
   */
  HAL_Init();

  /* Configure the system clock */
  SystemClock_Config();

  /* Initialize all configured peripherals */
  MX_GPIO_Init();
  MX_TIM3_Init();
  MX_TIM4_Init();
  MX_USART2_UART_Init();
  /* USER CODE BEGIN 2 */
  motor_init();
  rgb_init();
  printf("\r\n=== NIPKOW M0 ===\r\n");
  printf("SYSCLK = %lu Hz\r\n", (unsigned long)HAL_RCC_GetSysClockFreq());
  printf("HCLK   = %lu Hz\r\n", (unsigned long)HAL_RCC_GetHCLKFreq());
  ir_init();
  control_init();
  uart_init();
#ifdef IR_SELF_TEST
  uint32_t test_start = ir_last_edge_ms();
  ir_on_edge_at(test_start + 5U);  /* 5ms：丢弃 */
  ir_on_edge_at(test_start + 25U); /* 25ms：计数 1 */
  ir_on_edge_at(test_start + 30U); /* 距上次有效边沿 5ms：丢弃 */
  ir_on_edge_at(test_start + 50U); /* 距上次有效边沿 25ms：计数 2 */
  printf("[IR TEST] count=%lu (expected 2)\r\n", (unsigned long)ir_count());
  ir_init();
#endif
  /* USER CODE END 2 */

  /* Infinite loop */
  /* USER CODE BEGIN WHILE */
  bool prev_led = false;
  static uint32_t key1_last_cnt = 0U;
  static uint32_t key2_last_cnt = 0U;
  while (1) {
    /* USER CODE END WHILE */

    /* USER CODE BEGIN 3 */

    static bool led_active = false;
    static uint32_t led_t0 = 0U;
    /*按键检测 BEGIN*/
    key1_press();
    key2_press();
    uint32_t key1_current_cnt = key1_cnt();
    uint32_t key2_current_cnt = key2_cnt();
    uint32_t difference1 = key1_current_cnt - key1_last_cnt; // RGBM 4
    uint32_t difference2 = key2_current_cnt - key2_last_cnt; //  level 6
    
    for (uint32_t i = 0; i < difference1; i++) {
      control_next_target();
    }
    key1_last_cnt = key1_current_cnt;
    for (uint32_t i = 0; i < difference2; i++) {
      control_level_step();
    }
    key2_last_cnt = key2_current_cnt;
    if ((difference1 > 0U) || (difference2 > 0U)) {
      control_apply();
    }

    /* 串口命令（M4）：非阻塞，收到完整一行才处理 */
    cmd_poll();

    /*按键检测 END*/
    /*自动循环 BEGIN*/

    /*自动循环 END*/
    /* 按键/串口的状态统一在 control.c 维护 */


    if (ir_take_event()) {
      static uint32_t ir_print_cnt = 0U;
      led_active = true;
      led_t0 = HAL_GetTick();
      /* 每 10 个事件打印一次，避免 115200 串口拖慢主循环 */
      if (++ir_print_cnt >= 10U) {
        ir_print_cnt = 0U;
        printf("[IR] count=%lu last=%lu ms\r\n", (unsigned long)ir_count(),
               (unsigned long)ir_last_edge_ms());
      }
    }

    if (led_active && (HAL_GetTick() - led_t0 >= 1000U)) {
      led_active = false;
    }

    if (led_active != prev_led) {
      prev_led = led_active;
      HAL_GPIO_WritePin(CORELED_GPIO_Port, CORELED_Pin,
                        led_active ? GPIO_PIN_SET : GPIO_PIN_RESET);
    }
  }
  /* USER CODE END 3 */
}

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
/* USER CODE BEGIN 4 */
void HAL_GPIO_EXTI_Callback(uint16_t GPIO_Pin) {
  if (GPIO_Pin == IR_INDEX_Pin) {
    ir_on_edge_isr();
  }
}
/* USER CODE END 4 */
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
