Lilffy/NIPKOW/firmware/cubemx/Core/Inc/main.h

#define KEY1_Pin GPIO_PIN_0
#define KEY1_GPIO_Port GPIOC
#define KEY2_Pin GPIO_PIN_1
#define KEY2_GPIO_Port GPIOC
#define IR_INDEX_Pin GPIO_PIN_1
#define IR_INDEX_GPIO_Port GPIOA
#define IR_INDEX_EXTI_IRQn EXTI1_IRQn
#define UART_TX_Pin GPIO_PIN_2
#define UART_TX_GPIO_Port GPIOA
#define UART_RX_Pin GPIO_PIN_3
#define UART_RX_GPIO_Port GPIOA
#define R_PWM_Pin GPIO_PIN_6
#define R_PWM_GPIO_Port GPIOA
#define G_PWM_Pin GPIO_PIN_7
#define G_PWM_GPIO_Port GPIOA
#define B_PWM_Pin GPIO_PIN_0
#define B_PWM_GPIO_Port GPIOB
#define CORELED_Pin GPIO_PIN_2
#define CORELED_GPIO_Port GPIOB
#define MOTOR_PWM_Pin GPIO_PIN_6
#define MOTOR_PWM_GPIO_Port GPIOB
