Lilffy/NIPKOW/(commit log)

2026-10-25 init: project docs, hardware manufacturing files, firmware plan
    [BOM.csv, BOM_draft.csv, PickAndPlace.csv]
2026-10-25 feat(sw): M0 固件骨架（168MHz + USART2 + 心跳灯）与 CMake 工程
2026-10-25 fix(sw): PB2 LED 改为高电平点亮（与核心板原理图 PB2->LED2->R29->GND 一致）
    [main.c, main.h]
2026-10-25 docs: 两 AI 协作守则 + CODEOWNERS + Issue/PR 模板
2026-10-25 docs: 上传扩展板原理图 PDF（hardware/schematic.pdf）
2026-10-25 fix(hw): C10 改 10uF/25V（100uF 外接）；docs: A 硬件交接说明 + 固件模块规划
    [BOM.csv, PickAndPlace.csv]
2026-10-25 docs: CubeMX 新建工程指南 + 编译脚本；M0 骨架完成
2026-10-25 docs: M0 动手手册（分步学习路径）
2026-10-25 docs: AI 协作核心规则（精简版）
2026-10-25 docs: CubeMX 引脚配置 click 级步骤（M0 工程部分）
2026-10-26 feat(sw): 加入 CubeMX M0 工程（firmware/cubemx：.ioc + Core + 选择性 HAL）
2026-10-26 fix(sw): 修正 ir.h（误贴成实现代码）+ 同步 ir.c 边沿消抖版本
    [ir.c, ir.h, main.c]
2026-10-26 docs(a): A 的交接包（12 页打印包 / 作业文档 / 板框 DXF / 生成脚本）
    [board_100x90.dxf, board_99x89.dxf]
2026-10-26 docs: 增加推送闭环协议（推送前读对方记录、推送后固定格式汇报）
2026-10-26 feat(sw): M1 红外事件触发 LED 亮 1s（非阻塞状态机）
2026-10-27 docs: 红外对管（5A2L-10 + DY-PT4133B-A2）与电路核对结论
2026-10-27 docs: 索引加入红外对管核对
2026-10-27 docs: 决策记录——RGB 三合一形态确认项 + KEY1/KEY2 交互方案（每路独立 6 级）
2026-10-27 docs: PCB 迭代打板计划（V1 验证 → V2 收敛）
2026-10-27 docs: 第一阶段截止 11-06，V2 取消，V1 即交付版；倒排表与风险
2026-10-27 docs: 原理图分区对照表（59 器件→14 模块）
2026-10-27 docs: 更正 TP1-TP9 网络表（按网表核对）
2026-10-27 fix(sw): P0 电机 CCR 量纲、每路独立档位、按键去重、RGB/电机初始化清场、IR 打印限频
    [main.c]
2026-10-27 docs: 统一 RGB 为共阴（QUESTIONS Q1/Q7 与 README/DECISIONS 对齐）
2026-10-27 docs: PROJECT_BRIEF 回填共阴方案/59 元件网表/限流值/C10 处理（响应 A 的过期文档清单）
2026-10-27 docs(hw): 导出丝印/装配图（顶/底 PNG + 4 页 PDF）与装配接线说明
2026-10-27 docs: 采购核对表（按最新 BOM + A 自查修正：C10/C1C3 耐压/R12/U3 散热）
2026-10-27 docs: 采购核对表加入 A 的实际采购 21 项判定（C1-C4 16V 限制 9V、缺散热片/J6 线束）
2026-10-27 docs: 澄清 C4/C8、C2/C6 是并联的一对（10uF + 100nF），不是单个器件
2026-10-28 docs: 补 J7 串口接线与调试方法（A_HANDOVER_NOTES 4.5 + ASSEMBLY_NOTES）
2026-10-28 feat(sw): M4 串口命令（UART RX 中断+环形缓冲、control 状态层、cmd 解析：HELP/STATUS/TARGET/LEVEL/RGB/MOTOR/IR/CLR）
2026-10-28 docs(sw): 记录 M4 串口命令实现与验证方法
2026-10-29 docs: 组委会问答逐条对照（已避坑/风险/技术栈/行动清单）
2026-10-30 docs: 供电网络专项核对（无统一 VCC；U2/U3 接线经原理图目视确认；贴反/JP1 倒灌风险）
2026-10-31 docs: 硬件核查清单（含 P0：R10/R11 需对调焊才能出 5.0V；U2 方向/型号确认）
2026-10-31 docs: 到货核对清单 + 元件理想件/凑活能用对照
2026-10-31 docs: 记录 10-30 补件与仍缺项
2026-10-31 docs: 记录 10-30 晚到货状态
2026-10-31 docs: 结论 R10/R11 换值不改铜箔→不重打板；补充 V1 最终焊接值表
2026-10-31 docs: 所有已发现问题与应对汇总
2026-10-31 docs: V1 板焊接顺序
2026-10-31 docs: V2 改板任务书（交给 A）
2026-10-31 docs: PCB 画板流程与检查清单（新手版）
2026-10-31 hardware: 更新 hardware/Gerber.zip
2026-10-31 hardware: 更新 hardware/BOM.csv
    [BOM.csv]
2026-10-31 hardware: 更新 hardware/PickAndPlace.csv
    [PickAndPlace.csv]
2026-10-31 hardware: hardware/BOM_SMT.csv
    [BOM_SMT.csv]
2026-10-31 hardware: hardware/PickAndPlace_SMT.csv
    [PickAndPlace_SMT.csv]
2026-11-01 fix: 重新导出 Gerber（修复13个GND通孔孔径）
2026-11-01 docs: 新增导出后钻孔核对步骤
2026-11-06 docs: 最终版焊接步骤
2026-11-06 docs: docs/SOLDER_1PAGE.md
2026-11-06 docs: docs/SOLDERING_ORDER_V2.md
